wael-suleiman-UdeS/RobotFoot/Livrables/Présentation Publique/Images/ConceptArt.png

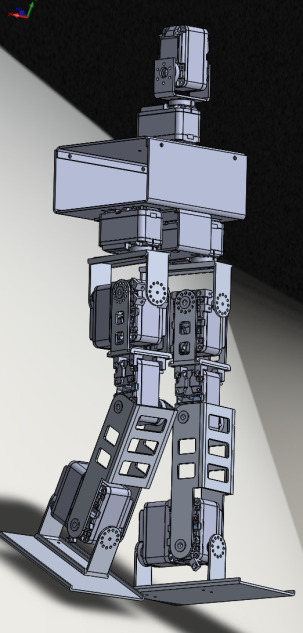
Livrables/Présentation Publique/Images/ConceptArt.png
