wael-suleiman-UdeS/RobotFoot/README.md

RobotFoot
=========

A humanoid robot soccer team.
