wael-suleiman-UdeS/RobotFoot/PCB/PINMAP.TXT

PE14 -> LED1
PE15 -> LED2
PC1  -> SW1
PC2  -> SW2
PC3  -> SW3
PA0  -> Vsense (ADC123_IN0)
PA2  -> DBG_TX (USART_2)
PA3  -> DBG_RX (USART_2)
PB10 -> MOT_TX (USART_3)
PB11 -> MOT_RX (USART_3)
PA4  -> MCU_AUDIO
PC10 -> SCLK [GY/ACC]
PC11 -> MISO [GY/ACC]
PC12 -> MOSI [GY/ACC]
PD0  -> INT1_A
PD1  -> INT2_A
PD2  -> INT1_G
PD3  -> INT2_G
PD4  -> DEN_G
PD6  -> CS_G
PD7  -> CS_A
