wael-suleiman-UdeS/RobotFoot/Darwin/Framework/LisezMoi.txt

Votre rôle sera de modifier le fichier suivant et ses dépendances:

./src/motion/modules/Walking.cpp
