wael-suleiman-UdeS/RobotFoot/Livrables/Canevas/Rapports.docx

Titre du rapport

Équipe RobotFoot

Présenté à:

Noms des superviseurs

Département de génie électrique et de génie information

Date de remise du rapport

# Section 1

## Sous-section 1.1

Lorem ipsum

## Sous-section 1.2

Lorem ipsum

# Section 2

## Sous-section 2.1

Lorem ipsum

## Sous-section 2.2

Lorem ipsum
