wael-suleiman-UdeS/RobotFoot/Marketing/Most.docx

# Most Player

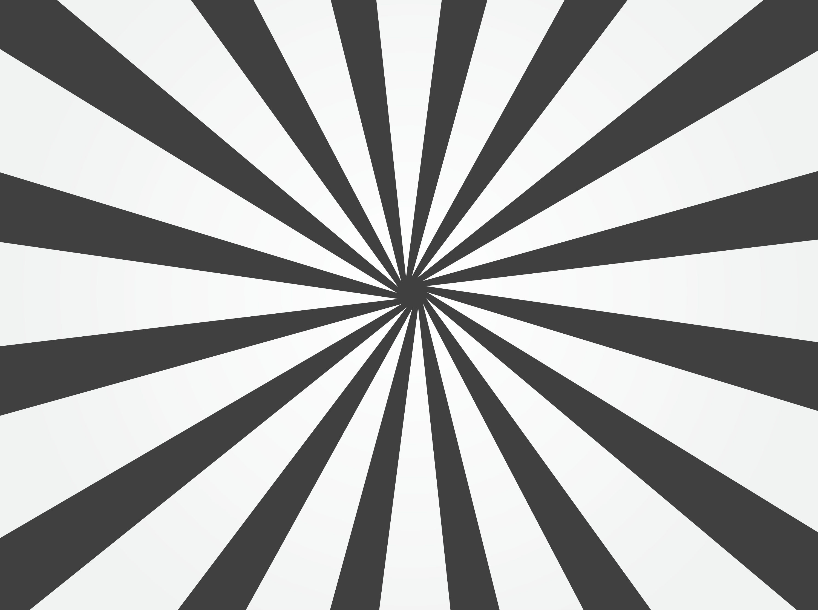
[picture p21: figure]
Background Graphic
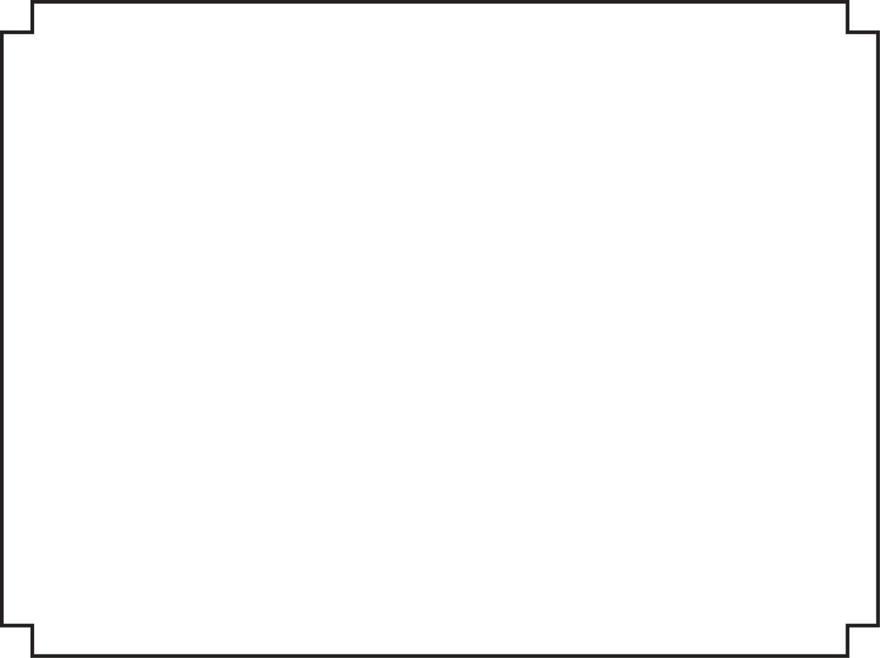
[picture p22: figure]
Background Graphic

RobotFoot

is hereby recognized as this season’s Most Improved Player for phenomenal participation on

learn how to walk

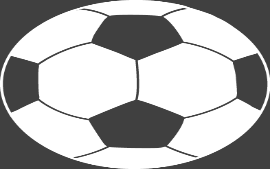
[picture p23: figure]
Soccer ball

| | Presented By: L’équipe RobotFoot On This Day: December 5, 2013
