wael-suleiman-UdeS/RobotFoot/Livrables/Présentation Publique/Affiche.docx

Présentation Publique

      Affiche / Présentation publique

Légende

En gris : À mettre sur l'affiche

Titre de l'affiche

- Comment construire un robot de A à Z : RobotFoot
- How it's made : RobotFoot
- RobotFoot
        Estimer les coûts du projet et faire la planification financière (20 pts)
- Tableau des dépenses
- Prix total du projet pour nous
- Prix total du projet pour un particulier
        Mettre en place des mesures de suivi et de contrôle (20 pts)
- Pointe de tarte des heures des membres de l'équipe
- Moyenne par sprint mis-à-jour (sans les sprints de 0 hrs)
- Échéancier S7-S8
- Suivi des risques
        Faire la conception détaillée (15 pts)
- Résumé de comment créer un robot humanoïde
        Valider et implémenter la solution (15 pts)
- Image de la reconnaissance d'image (les crayons feutre)
- La démonstration du robot qui marche et botte la balle
        Répondre de façon satisfaisante aux questions (14 pts)
- Création de Spécialistes
        Recourir à un support visuel de qualité (13 pts)
- Image du robot
- Nos commanditaire
        Capter l'attention de l'auditoire (13 pts)
- Bien habillé
- Habit de groupe (chandail d'arbitre par exemple)
- LEDs sur la plate-forme et/ou les buts
        Énoncer les objectifs à atteindre (10 pts)
- Tableau des contraintes
- But du projet
