wael-suleiman-UdeS/RobotFoot/Livrables/MAP/Shémas/RobotFoot - Proforma.docx

## 1.1 Rapports - proforma

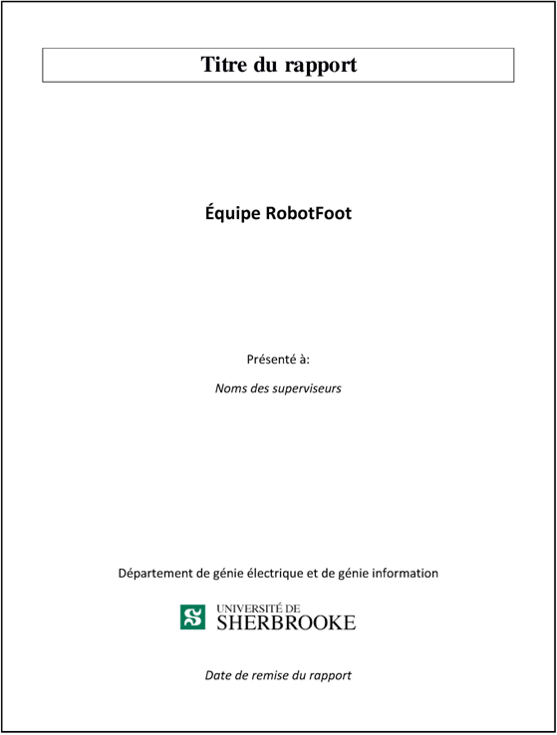
[picture p32: figure]
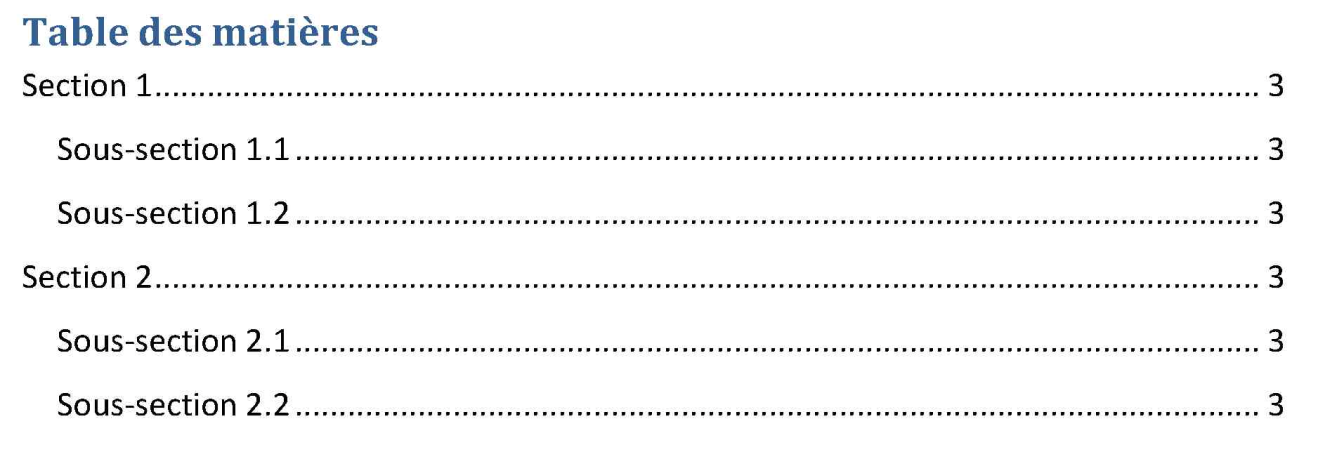
[picture p33: figure]
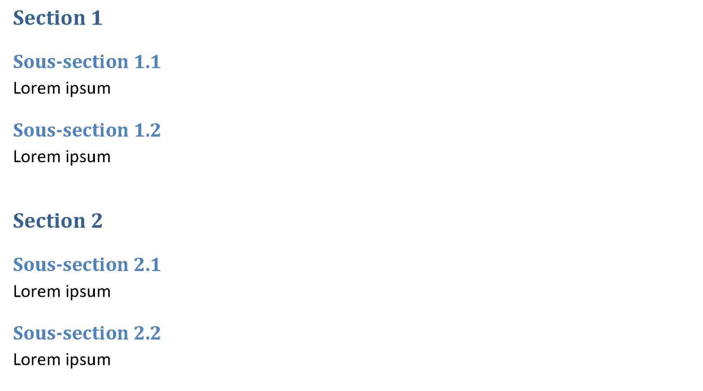
[picture p34: figure]

## 1.2 Compte-rendu de rencontres - proforma

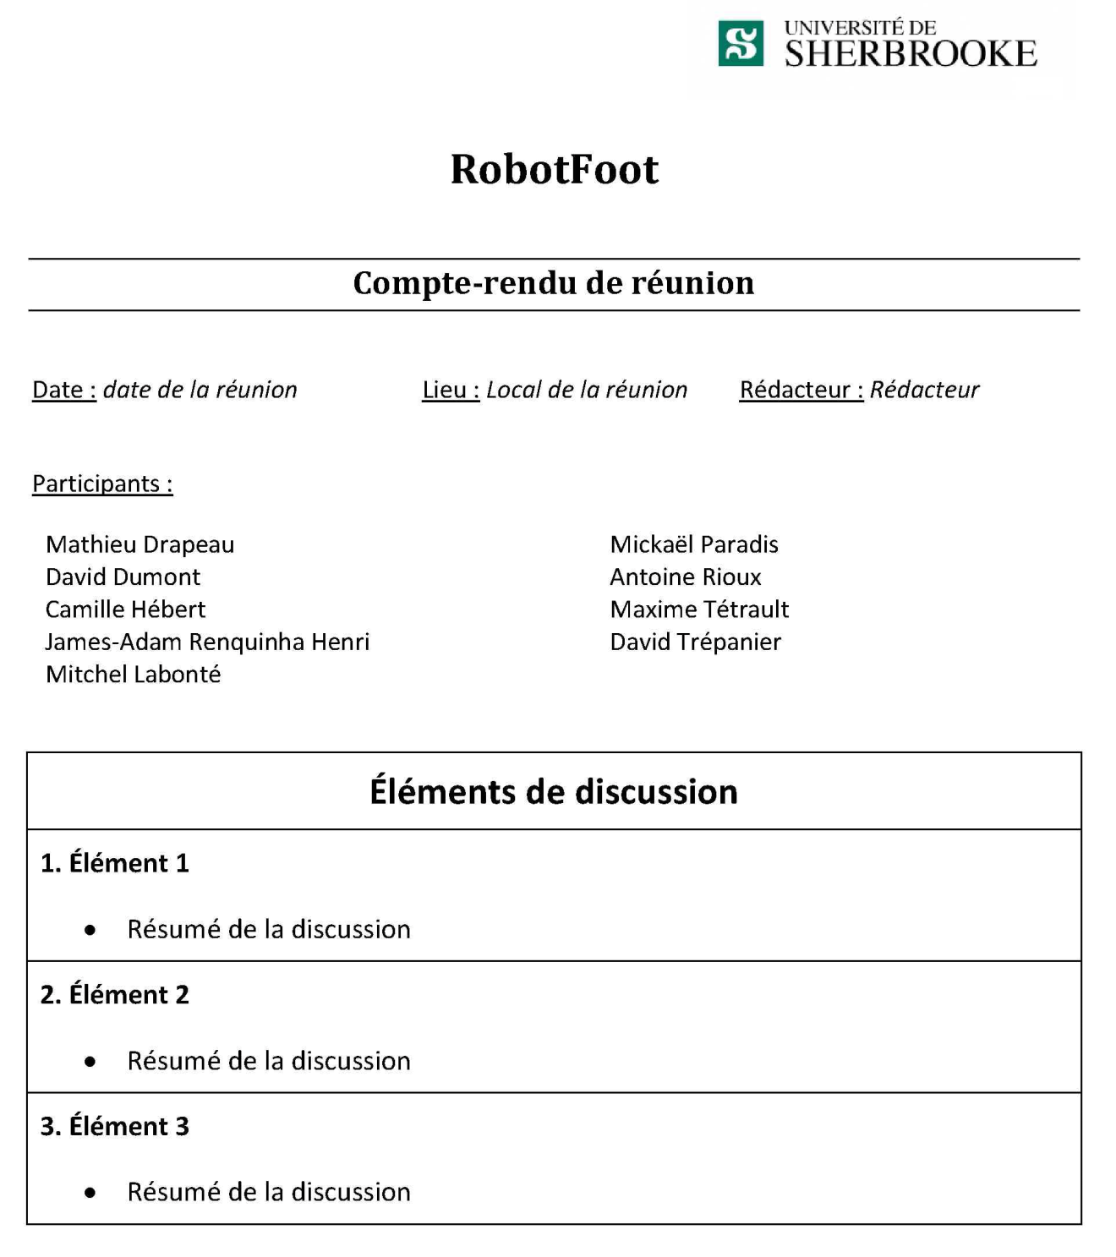
[picture p35: figure]

## 1.3 Suivi budgétaire
