wael-suleiman-UdeS/RobotFoot/Budget/Factures/CA-256597_RoboShop.pdf

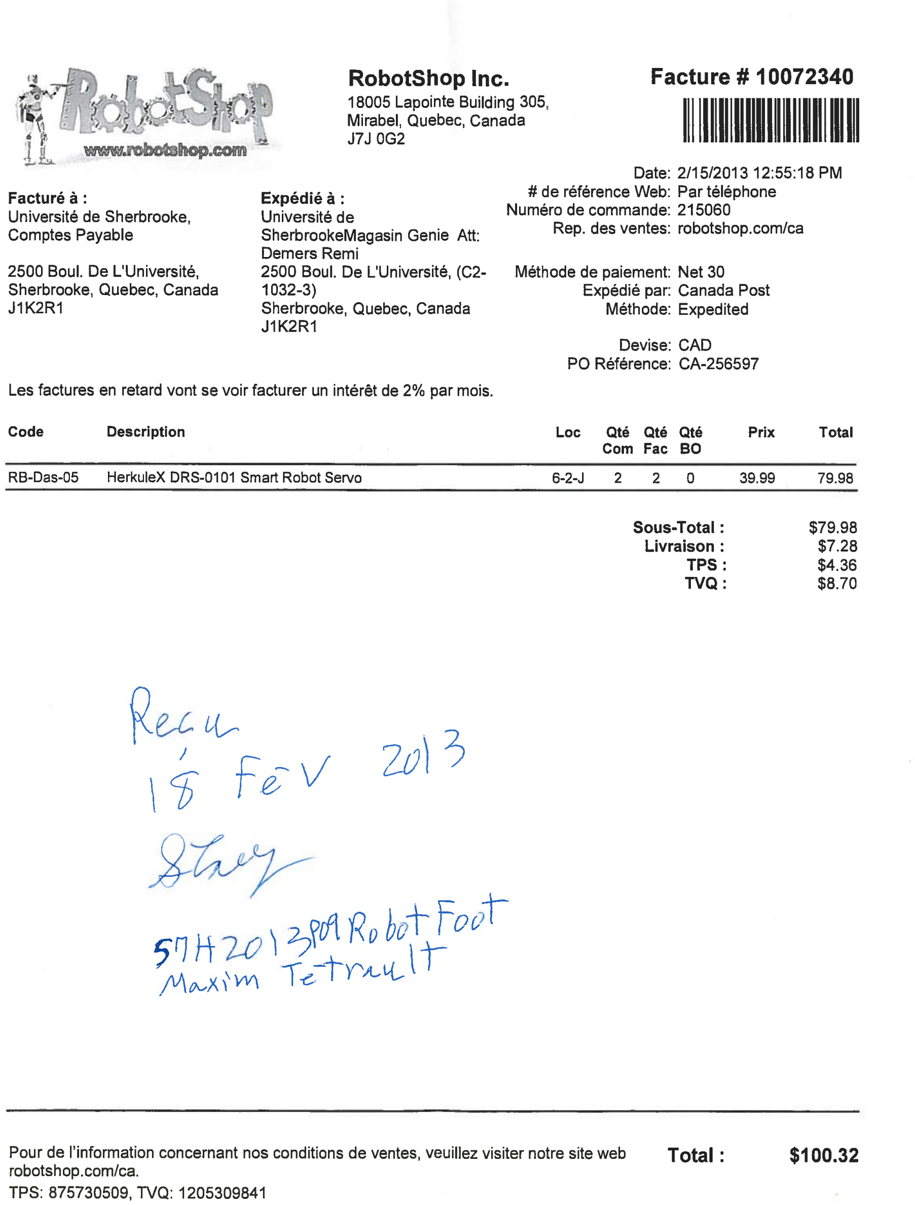
[picture p36: page 1]
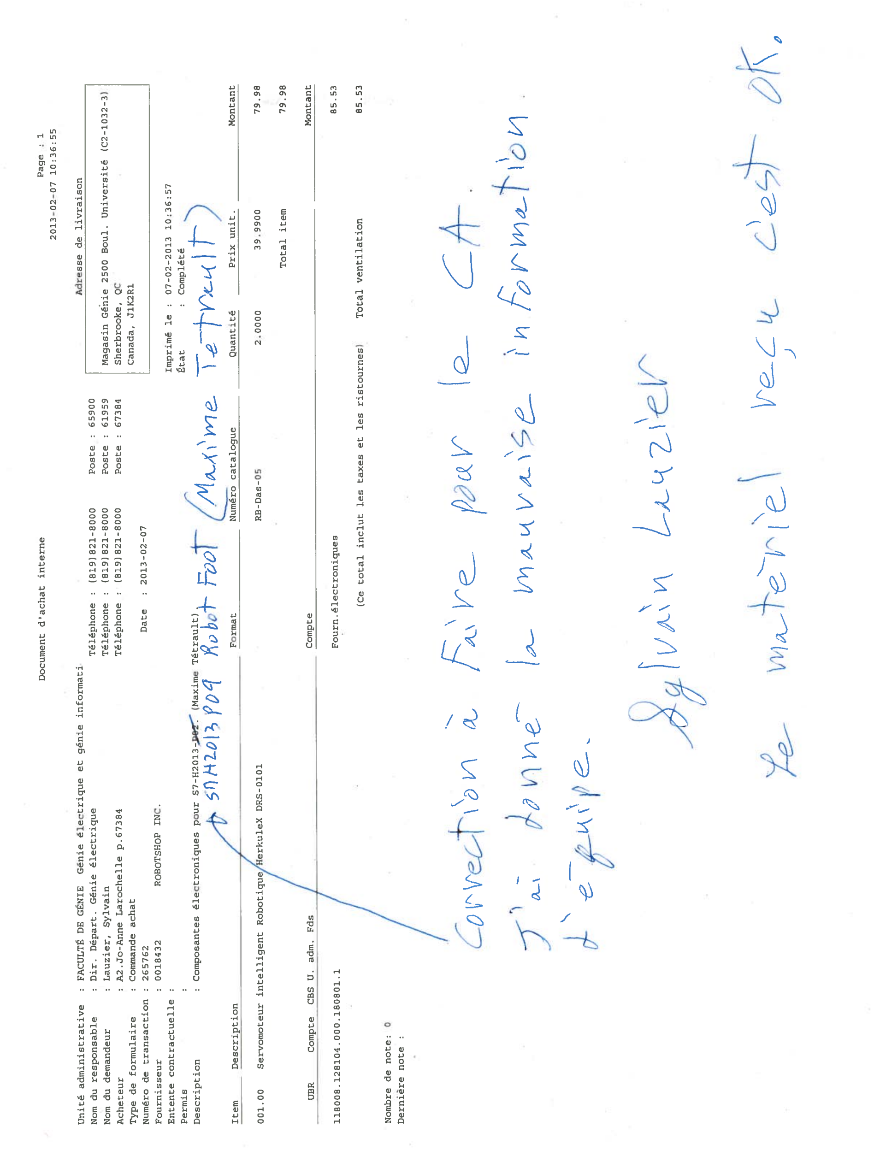
[picture p37: page 2]
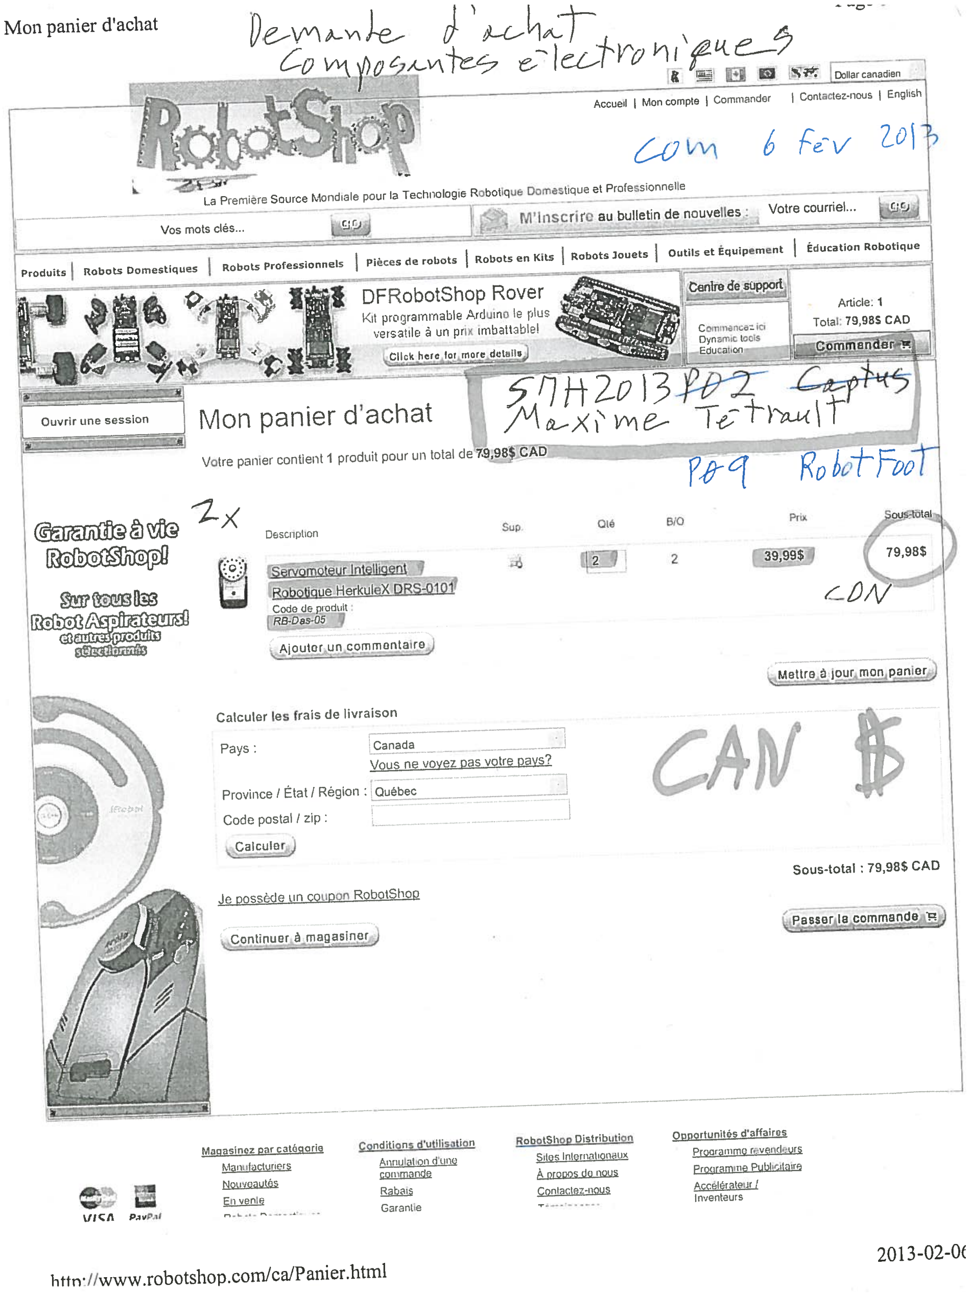
[picture p38: page 3]
