wael-suleiman-UdeS/RobotFoot/Budget/Factures/CA-257648_RoboShop.pdf

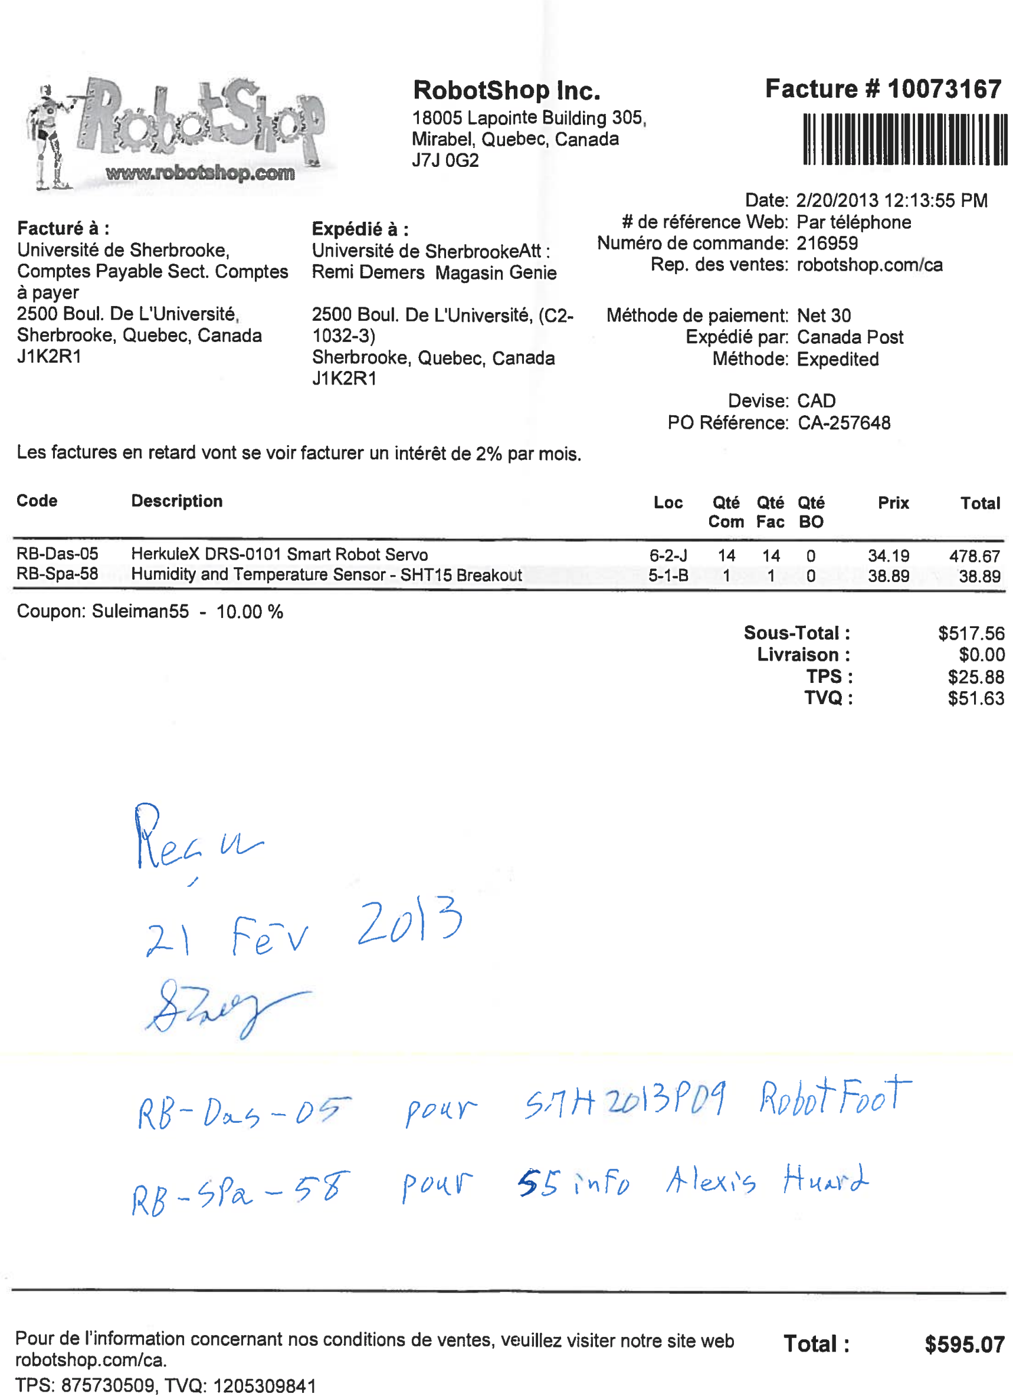
[picture p39: page 1]
