wael-suleiman-UdeS/RobotFoot/Budget/Factures/Rapport de d+®penses - GEGI - +ëtudiant  - V3_R1.xlsx

Sheet: Rapport de dépenses
 |  |  |  |  |  |  | RAPPORT DE DÉPENSES
Département de génie électrique et de génie informatique
ACTIVITÉ : |  |  |  |  |  |  |  |  | Dates de l'activité
 |  |  |  |  |  |  |  | Du :
Nom étudiant | David Dumont |  | Responsable du budget : |  |  |  |  | Au :
Matricule | 9097112 |  | UBR :
Téléphone | 819-239-9498 |  | Équipe projet : | P9 - Robot Foot
ACHAT | Facture d'achat |  |  |  |  |  |  | x | x | Devise | TOTAL
Date |  | Description de la dépense |  |  |  | Montant |  | Facture originale | Preuves paiement (relevés)
2013-03-28 |  | Achat carte-mémoire et un lecteur |  |  |  | 23.63 $ |  |  |  |  | 23.63 $
2013-03-28 |  | Webcam |  |  |  | 26.30 $ |  |  |  |  | 26.30 $
2013-04-22 |  | Essence - On est aller chercher des pièces pour notre robot à la place de se les êtres fait livrer (50$ de livraison) pour pouvoir les avoirs à temps pour l'audit. Il y avais Mitchel Labonté, Antoine Rioux et Mickaël Paradis présent dans l'automobile de Mitchel Labonté. Les pièces ont été fabriqué chez CBR Laser à Princeville/Plessiville. Le gas est celui utilisé pour l'aller-retour de la rue Léonard à Princeville. |  |  |  | 36.00 $ |  |  |  |  | 36.00 $
 |  |  |  |  |  |  |  |  |  |  | 0.00 $
 |  |  |  |  |  |  |  |  |  |  | 0.00 $
 |  |  |  |  |  |  |  |  |  |  | 0.00 $
 |  |  |  |  |  |  |  |  |  |  | 0.00 $
 |  |  |  |  |  |  |  |  |  |  | 0.00 $
 |  |  |  |  |  |  |  |  |  |  | 0.00 $
 |  |  |  |  |  |  |  |  |  |  | 0.00 $
 |  |  |  |  |  |  |  |  |  |  | 0.00 $
 |  |  |  |  |  |  |  |  |  |  | 0.00 $
 |  |  |  |  |  |  |  |  |  |  | 0.00 $
 |  |  |  |  |  |  |  |  |  |  | 0.00 $
 |  |  |  |  |  |  |  |  |  |  | 0.00 $
 |  |  |  |  |  |  |  |  |  |  | 0.00 $
 |  |  |  |  |  | 85.93 $ |  |  |  |  | 85.93 $
NOTES : |  |  |  |  |  |  |  |  |  | Sous-total : | 85.93 $
 |  |  |  |  |  |  |  |  |  | Avances :
 |  |  |  |  |  |  |  |  |  | TOTAL : | 85.93 $
 |  |  |  |  |  |  |  |  |  |  | LES PIÈCES JUSTIFICATIVES ORIGINALES SONT
 | Signature du responsable (approbation) |  | Nom en lettres moulées |  | Date |  |  |  |  |  | OBLIGATOIRES AINSI QUE LA PREUVE DE PAIEMENT.

Sheet: Directives
Directive relative au remboursement des frais de déplacement (extrait de la directive 2600-013)
8.1 | La demande de paiement des frais de déplacement doit comprendre les renseignements suivants :
 | - la durée et l'endroit
 | - le motif du déplacement (si pour enseignement, indiquer le sigle, la session et l'APP)
 | - le nom et la fonction de la personne rencontrée, ainsi que la relation d’affaires (s’il y a lieu)
 | - le détail des dépenses encourues et le montant du remboursement réclamé
 | - les pièces justificatives originales (les photocopies de pièces ne sont pas acceptées)
 | - les pièces justificatives doivent indiquer clairement que le montant est payé.
8.2 | La demande de paiement de dépenses inhabituelles doit être appuyée de justifications détaillées.
 | Précisions
 | Il est important d'inscrire tous les détails pertinents à votre demande, ceci afin d'en accélérer le traitement.
 | Il n'est pas nécessaire d'indiquer le kilométrage, car les déplacements sont remboursés selon la directive de l'Université de Sherbrooke, disponible à l'adresse suivante : https://helios.usherb.ca/lib880/dosetu/cw/wde0/CGW100PA
 | Lorsqu'une facture d'hôtel comprend un forfait, si possible, indiquer le contenu du forfait si celui-ci n'est pas détaillé sur la facture (salle de cours, coucher, repas, pauses-café, par exemple).
Envoi du rapport de dépenses
 | Lorsque complété, vous devez retourner votre rapport de dépenses à l'adresse suivante, accompagné des pièces justificatives appropriées :
 | Université de Sherbrooke
 | Faculté de génie
 | Département de génie électrique et informatique
 | 2500, boul. de l'Université
 | Sherbrooke (Québec) J1K 2R1
 |  | Rapport cliquer ici
