wael-suleiman-UdeS/RobotFoot/Budget/Factures/Remboursement 1 Max- batterie (paypal).png

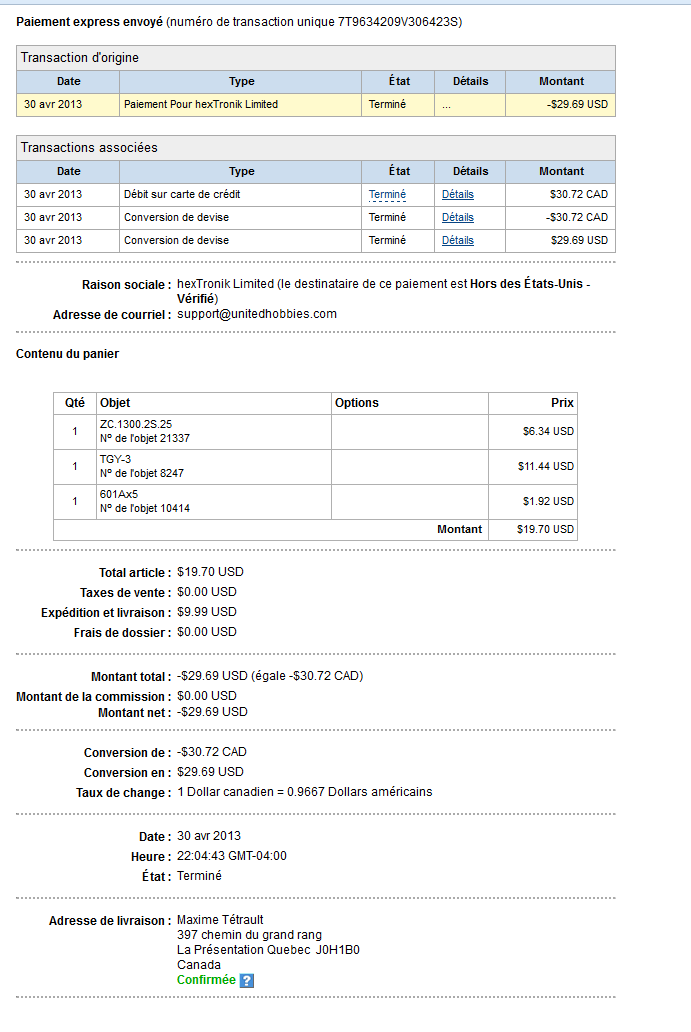
Budget/Factures/Remboursement 1 Max- batterie (paypal).png
