wael-suleiman-UdeS/RobotFoot/Budget/Factures/Remboursement 1 Max- batterie.png

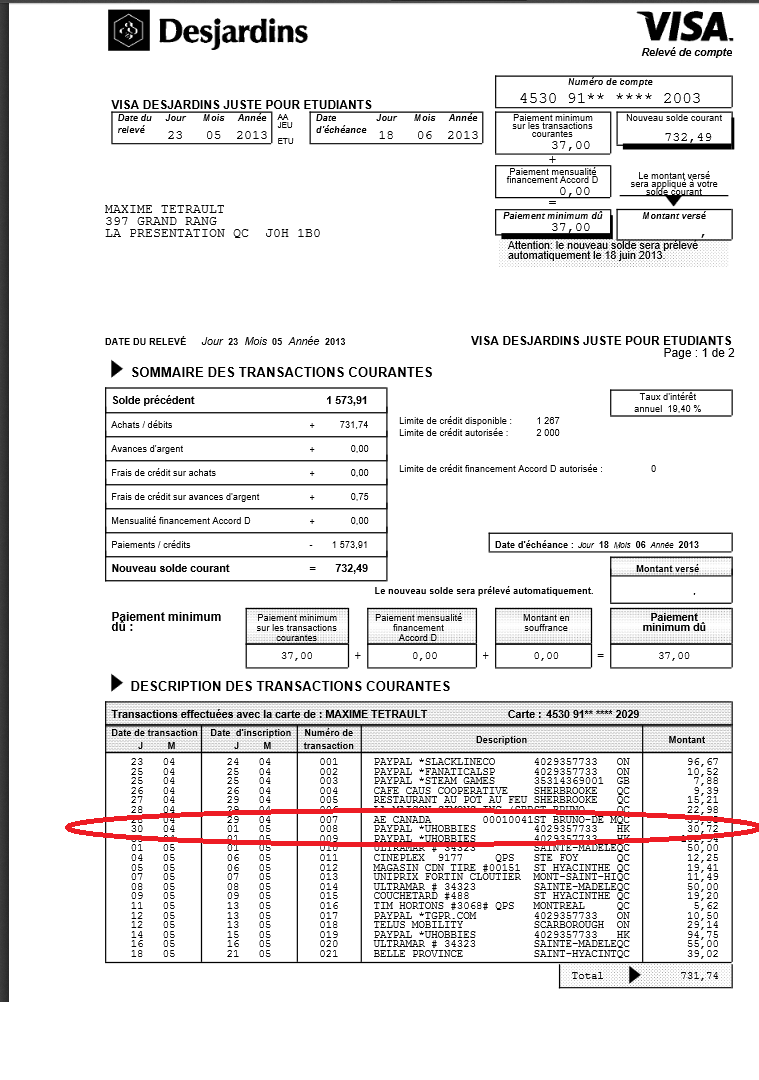
Budget/Factures/Remboursement 1 Max- batterie.png
