wael-suleiman-UdeS/RobotFoot/Budget/Factures/remboursement Batterie 2.png

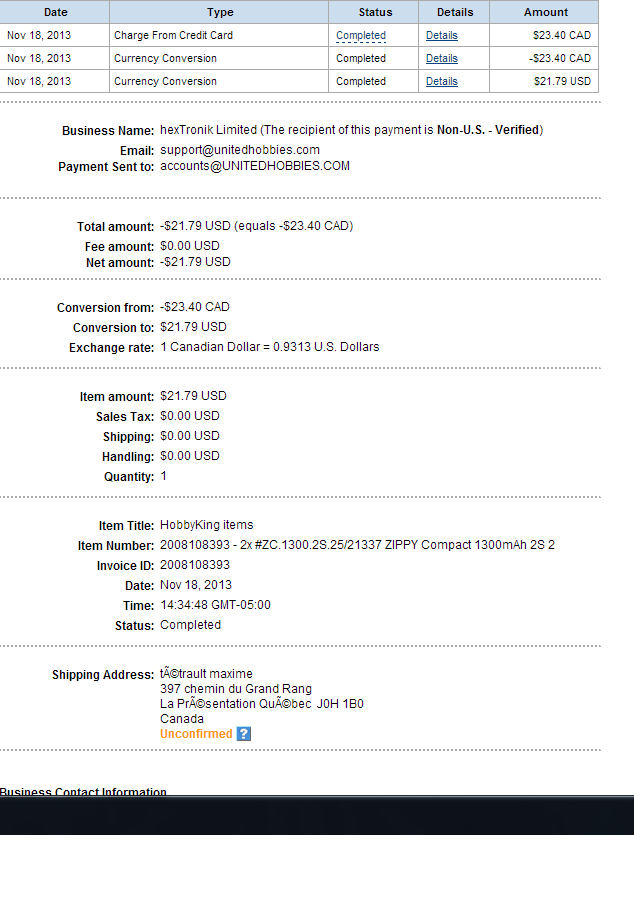
Budget/Factures/remboursement Batterie 2.png
