wael-suleiman-UdeS/RobotFoot/doc/Documentation et reference/HerculeX/Hovis LIte.png

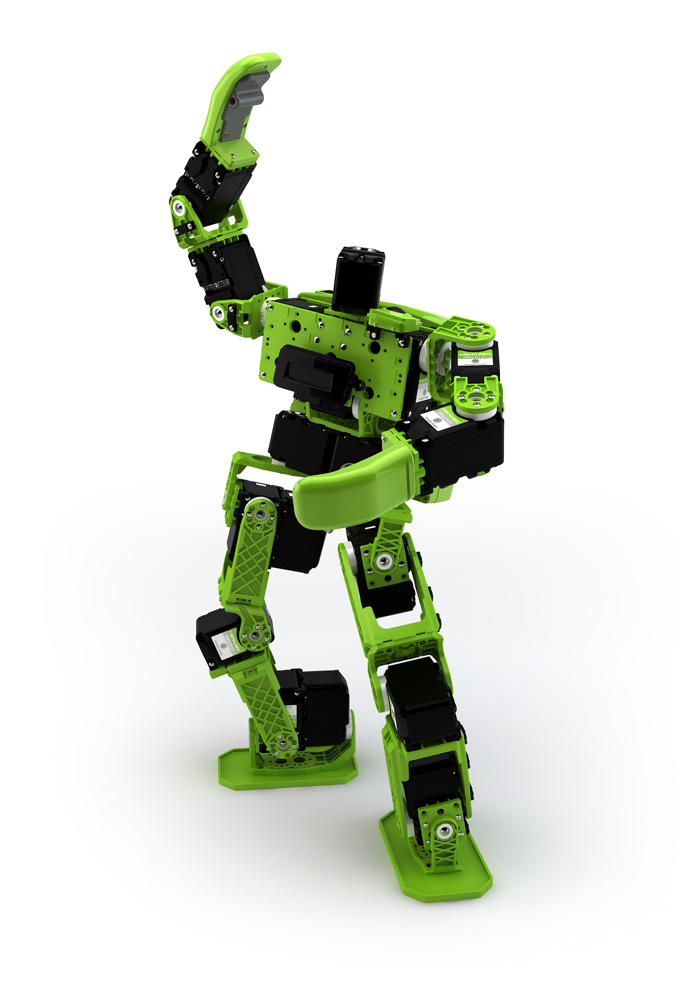
doc/Documentation et reference/HerculeX/Hovis LIte.png
