wael-suleiman-UdeS/RobotFoot/doc/Documentation et reference/HerculeX/Pieces.png

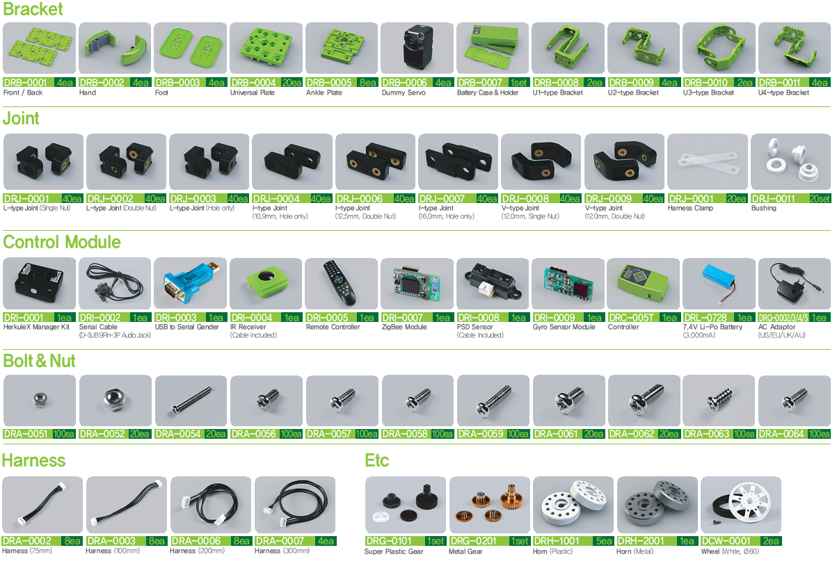
doc/Documentation et reference/HerculeX/Pieces.png
