wael-suleiman-UdeS/RobotFoot/Livrables/Article Scientifique/architecture.PNG

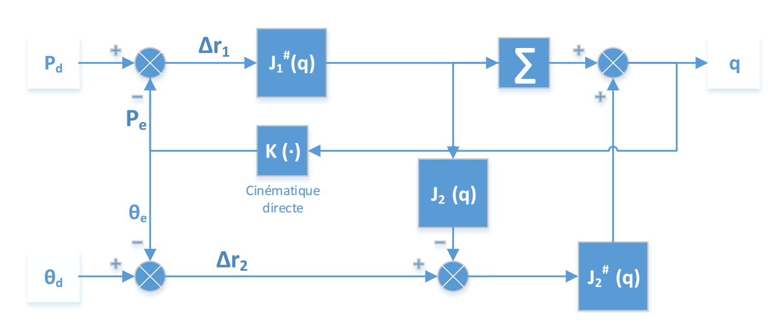
Livrables/Article Scientifique/architecture.PNG
