wael-suleiman-UdeS/RobotFoot/Livrables/Article Scientifique/Figures/2013-11-29 17.06.52.jpg

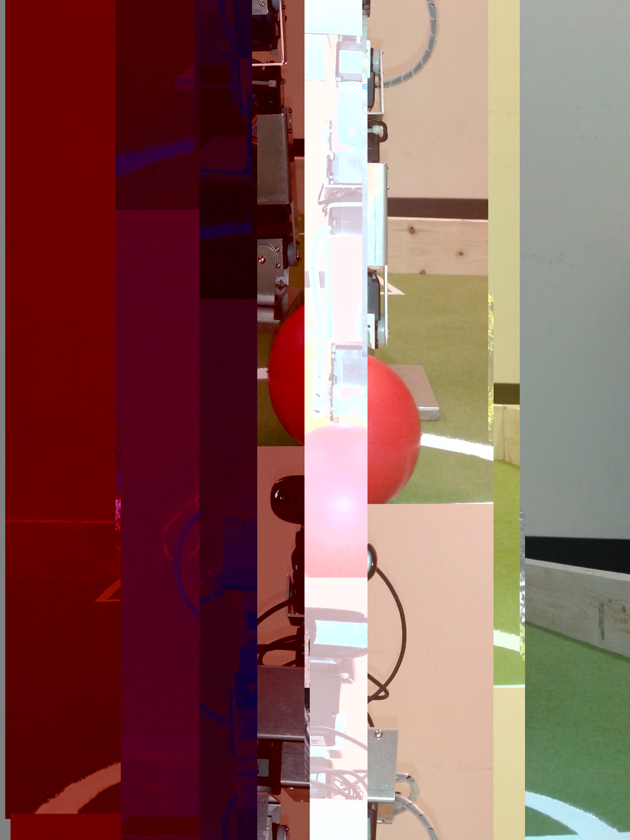
Livrables/Article Scientifique/Figures/2013-11-29 17.06.52.jpg
