wael-suleiman-UdeS/RobotFoot/Livrables/Article Scientifique/Figures/2013-11-29 17.07.05.jpg

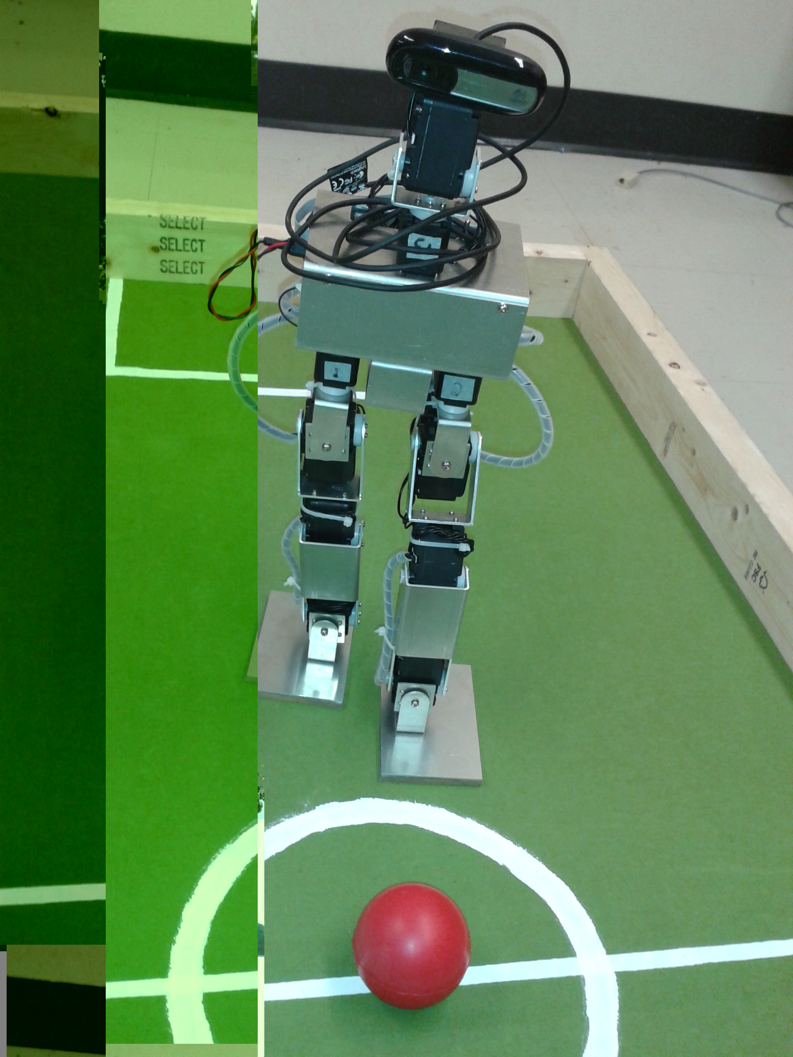
Livrables/Article Scientifique/Figures/2013-11-29 17.07.05.jpg
