wael-suleiman-UdeS/RobotFoot/Livrables/Article Scientifique/Figures/Bezier.jpg

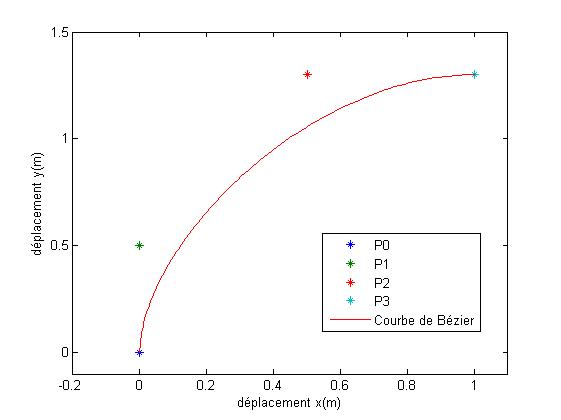
Livrables/Article Scientifique/Figures/Bezier.jpg
