wael-suleiman-UdeS/RobotFoot/Livrables/Article Scientifique/Figures/BezierPas.jpg

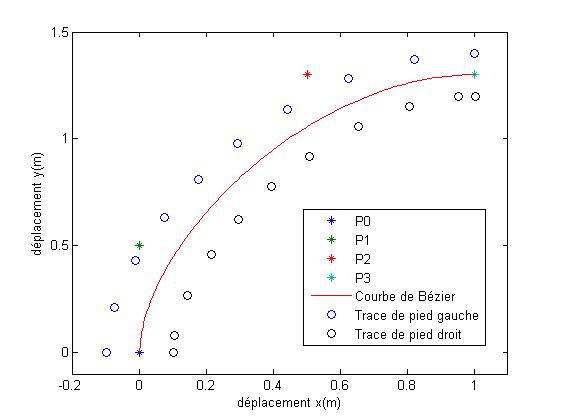
Livrables/Article Scientifique/Figures/BezierPas.jpg
