wael-suleiman-UdeS/RobotFoot/Livrables/Article Scientifique/Figures/DSCF1675 - Copie - Copie.JPG

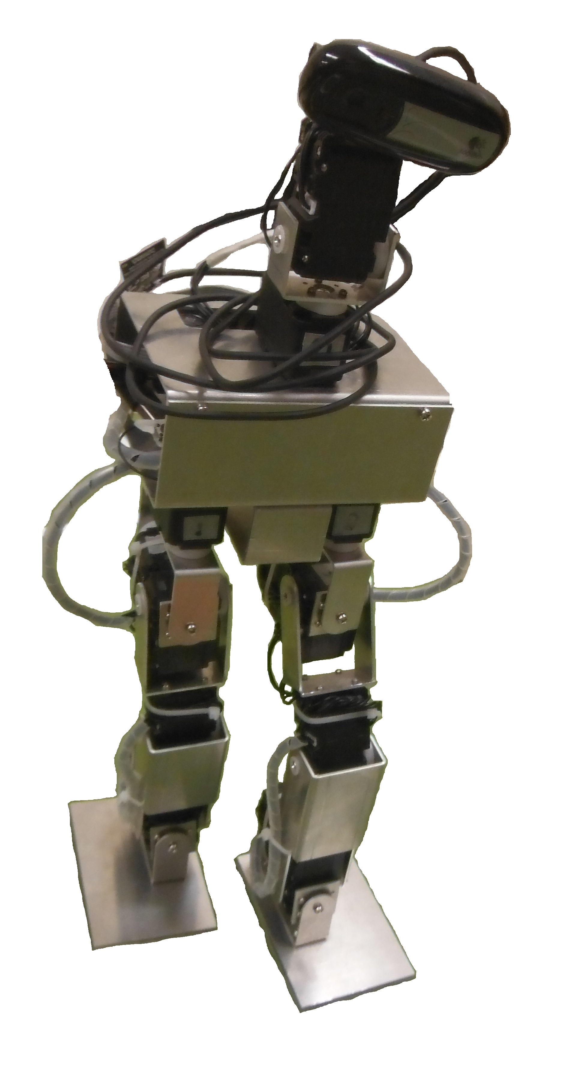
Livrables/Article Scientifique/Figures/DSCF1675 - Copie - Copie.JPG
