wael-suleiman-UdeS/RobotFoot/Livrables/Article Scientifique/Figures/Empreinte.png

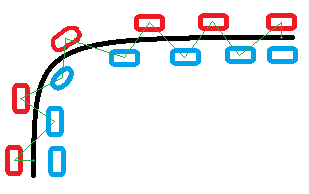
Livrables/Article Scientifique/Figures/Empreinte.png
