wael-suleiman-UdeS/RobotFoot/Livrables/Article Scientifique/pourleDH.PNG

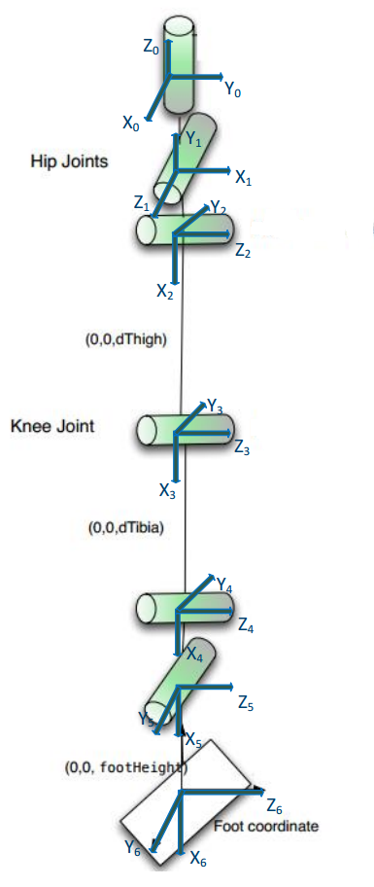
Livrables/Article Scientifique/pourleDH.PNG
