wael-suleiman-UdeS/RobotFoot/Livrables/Audit 1 mars/After Color Filter.jpg

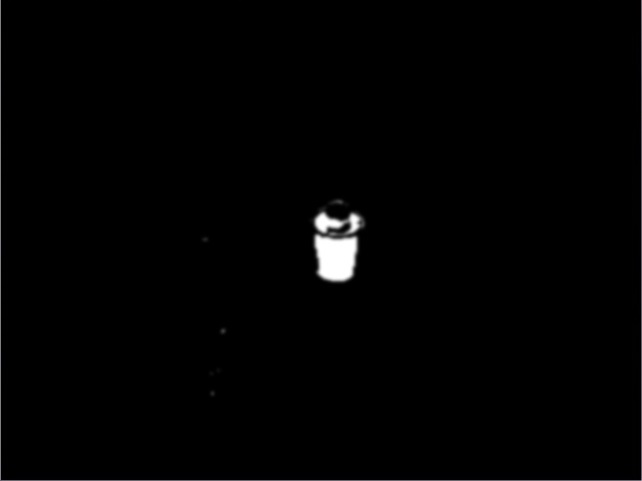
Livrables/Audit 1 mars/After Color Filter.jpg
