wael-suleiman-UdeS/RobotFoot/Livrables/Audit 1 mars/Camera.jpg

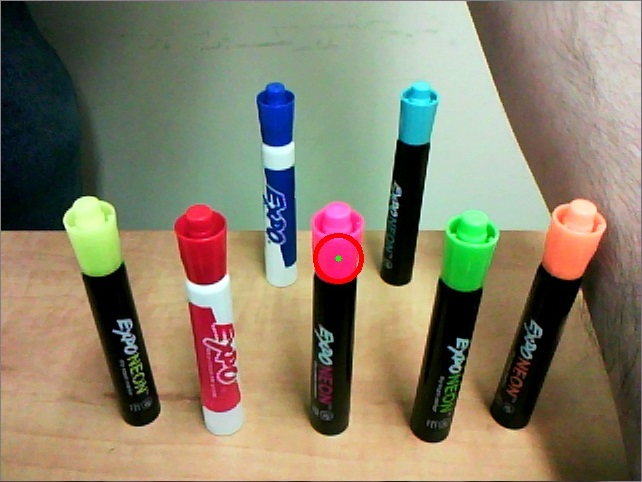
Livrables/Audit 1 mars/Camera.jpg
