wael-suleiman-UdeS/RobotFoot/Livrables/Audit 1 mars/choix de servo.png

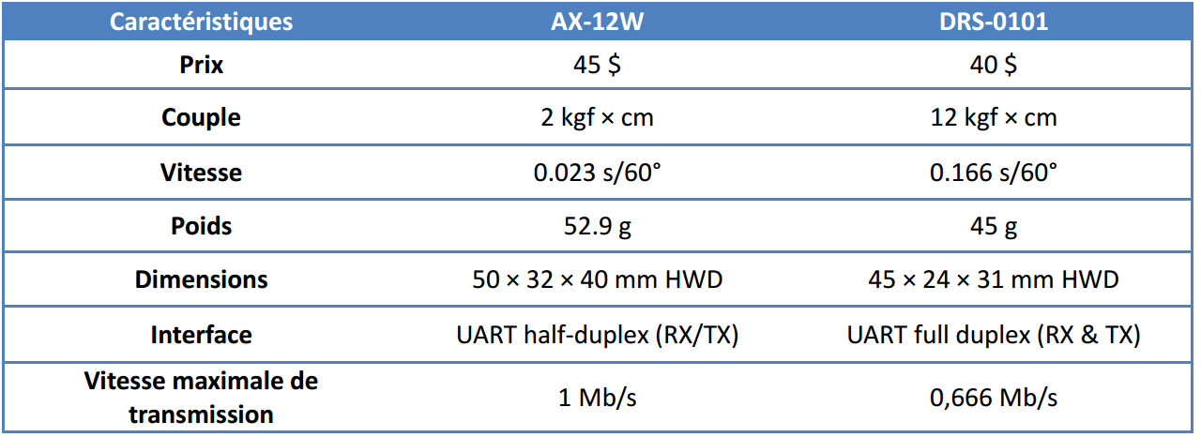
Livrables/Audit 1 mars/choix de servo.png
