wael-suleiman-UdeS/RobotFoot/Livrables/Audit 1 mars/choix Microcontroleur.png

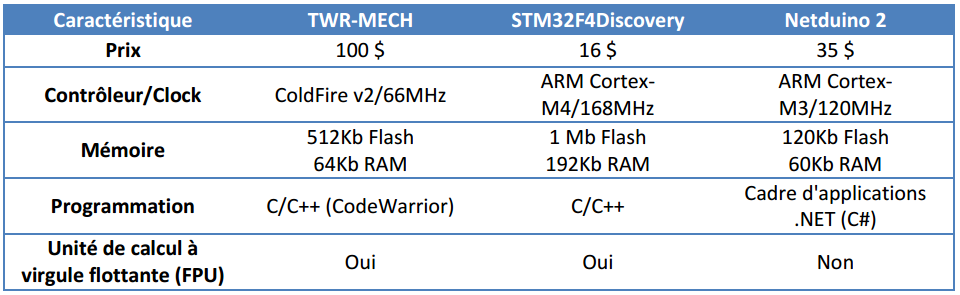
Livrables/Audit 1 mars/choix Microcontroleur.png
