wael-suleiman-UdeS/RobotFoot/Livrables/Audit 1 mars/composant élect.png

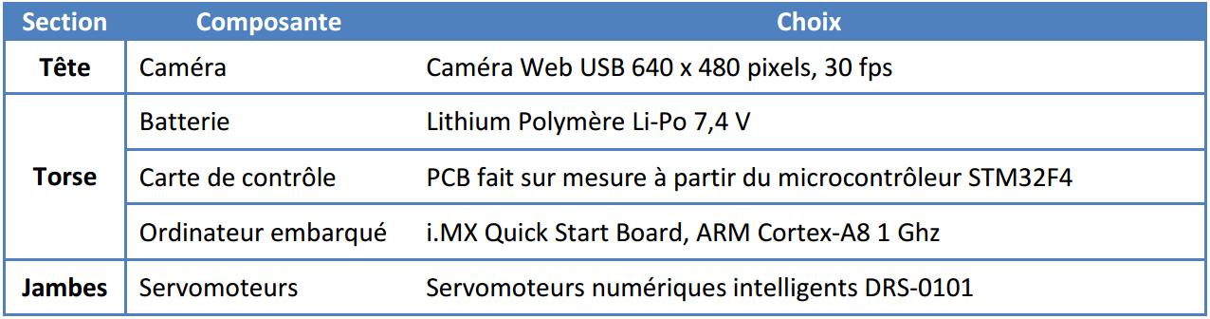
Livrables/Audit 1 mars/composant élect.png
