wael-suleiman-UdeS/RobotFoot/Livrables/Audit 1 mars/conception physique.png

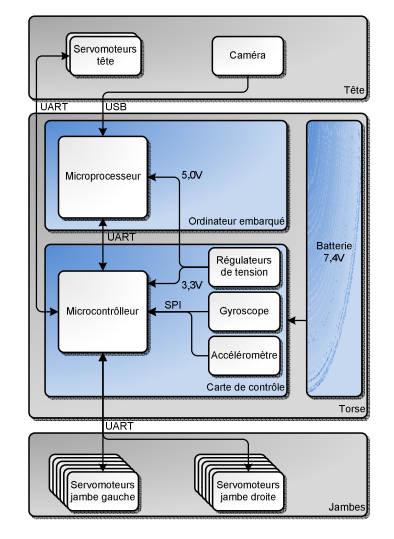
Livrables/Audit 1 mars/conception physique.png
