wael-suleiman-UdeS/RobotFoot/Livrables/Audit 1 mars/graph.png

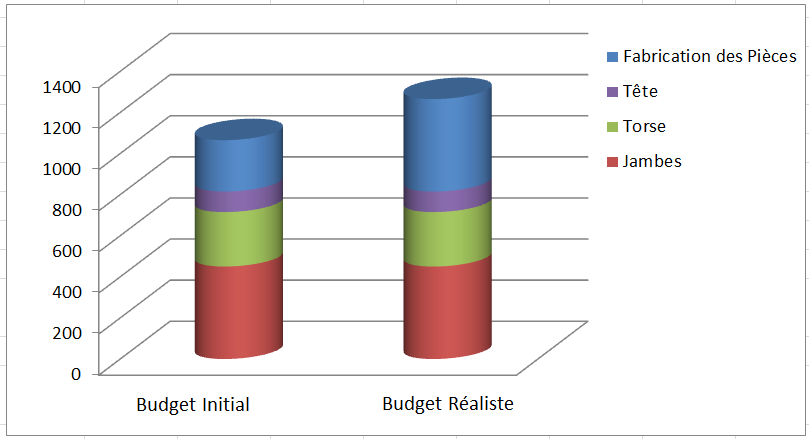
Livrables/Audit 1 mars/graph.png
