wael-suleiman-UdeS/RobotFoot/Livrables/Audit 1 mars/Graphique Budget.png

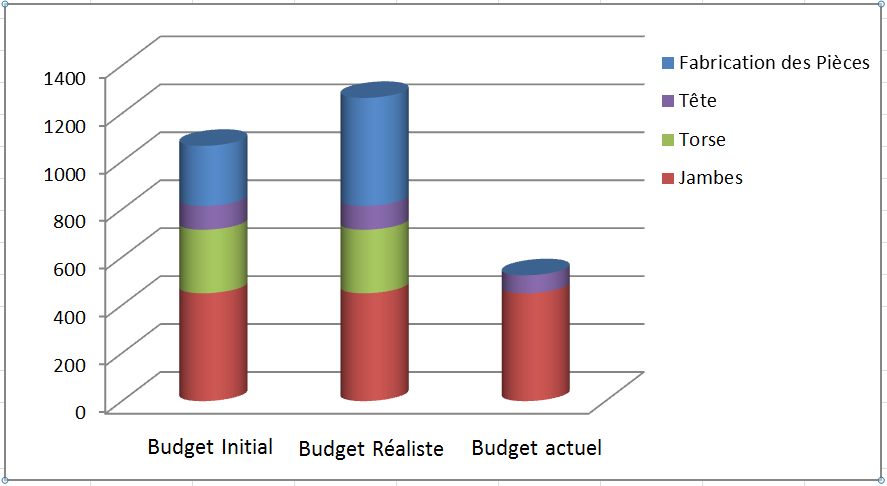
Livrables/Audit 1 mars/Graphique Budget.png
