wael-suleiman-UdeS/RobotFoot/Livrables/Audit 1 mars/herkulex-drs-0101-robot-servo-B.jpg

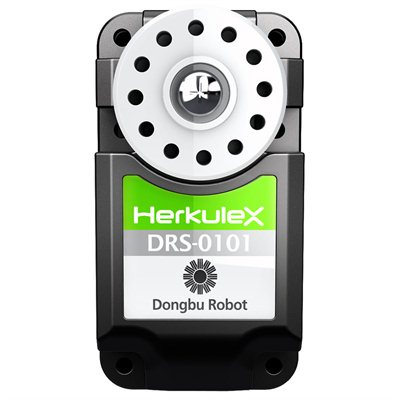
Livrables/Audit 1 mars/herkulex-drs-0101-robot-servo-B.jpg
