wael-suleiman-UdeS/RobotFoot/Livrables/Audit 1 mars/HSV Camera.jpg

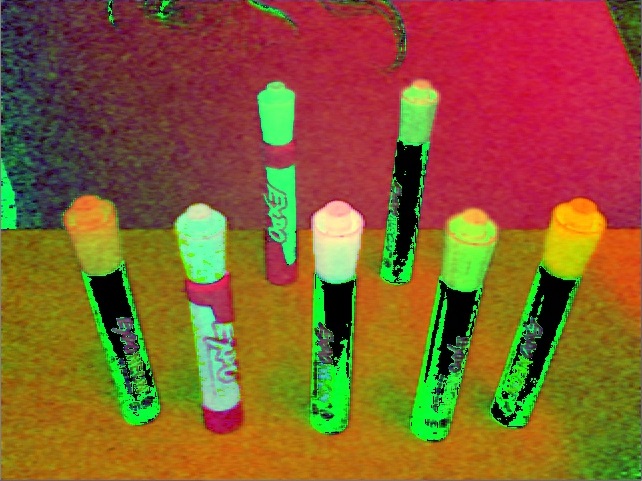
Livrables/Audit 1 mars/HSV Camera.jpg
