wael-suleiman-UdeS/RobotFoot/Livrables/Audit 1 mars/Jambe.png

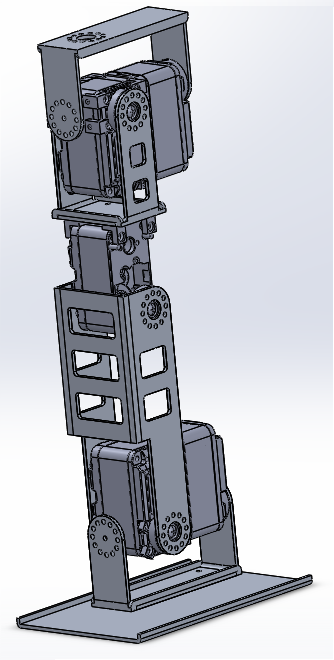
Livrables/Audit 1 mars/Jambe.png
