wael-suleiman-UdeS/RobotFoot/Livrables/Audit 1 mars/machine à état fini.png

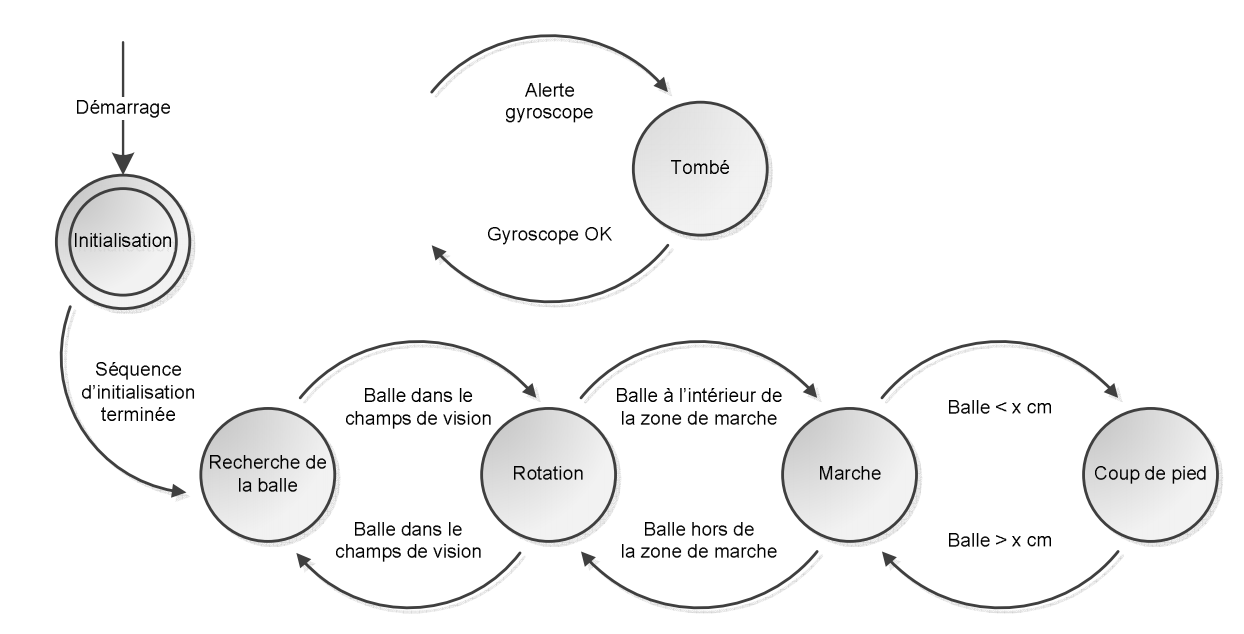
Livrables/Audit 1 mars/machine à état fini.png
