wael-suleiman-UdeS/RobotFoot/Livrables/Audit 1 mars/schéma décision.png

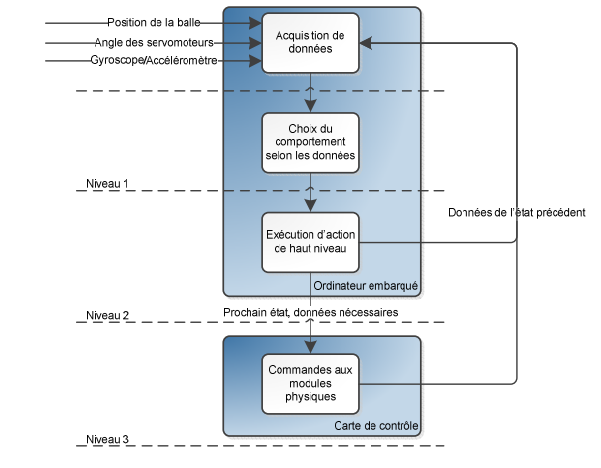
Livrables/Audit 1 mars/schéma décision.png
