wael-suleiman-UdeS/RobotFoot/Livrables/Audit 1 mars/schéma logique haut niveau.png

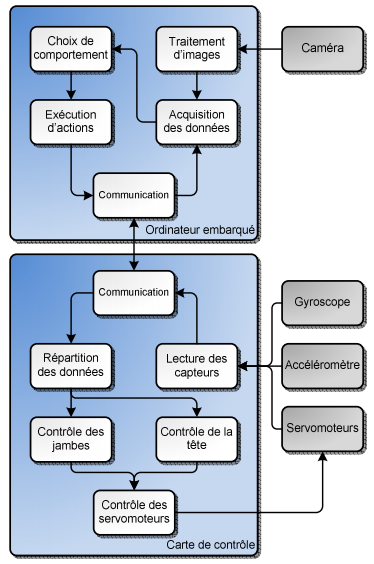
Livrables/Audit 1 mars/schéma logique haut niveau.png
