wael-suleiman-UdeS/RobotFoot/Livrables/Audit 1 mars/torse.png

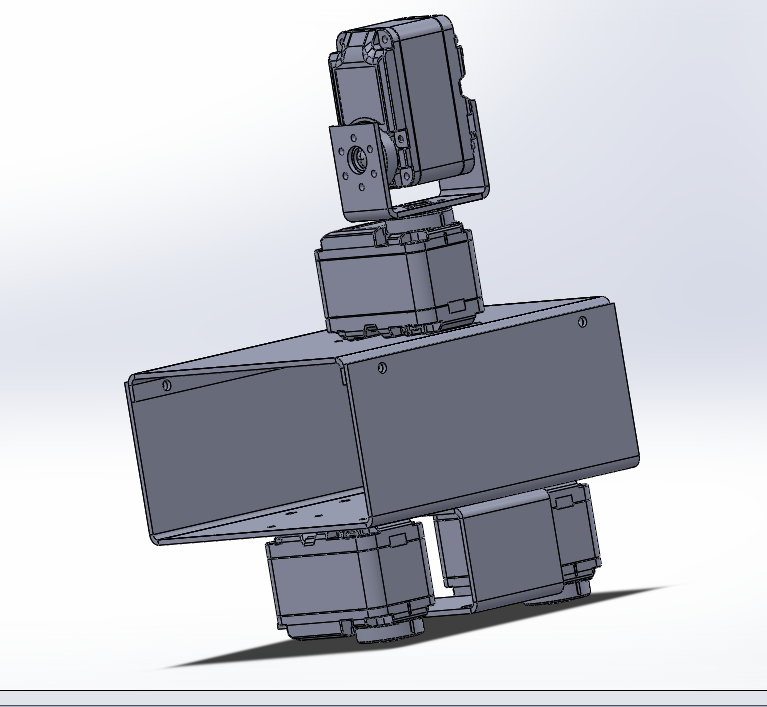
Livrables/Audit 1 mars/torse.png
