wael-suleiman-UdeS/RobotFoot/Livrables/Audit 1 mars/type de servo.png

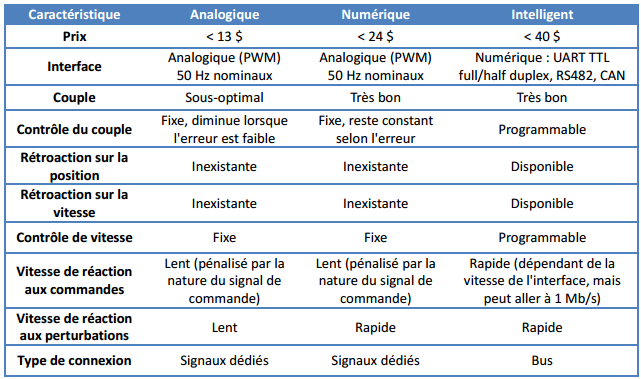
Livrables/Audit 1 mars/type de servo.png
