wael-suleiman-UdeS/RobotFoot/Livrables/Audit 23 avril/bioloid-300.jpg

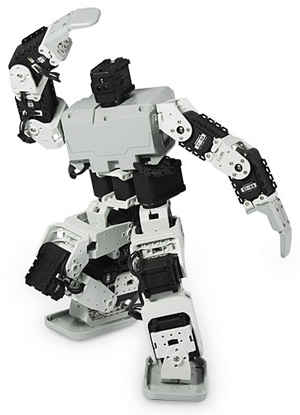
Livrables/Audit 23 avril/bioloid-300.jpg
