wael-suleiman-UdeS/RobotFoot/Livrables/Audit 23 avril/Budget 2 robots.PNG

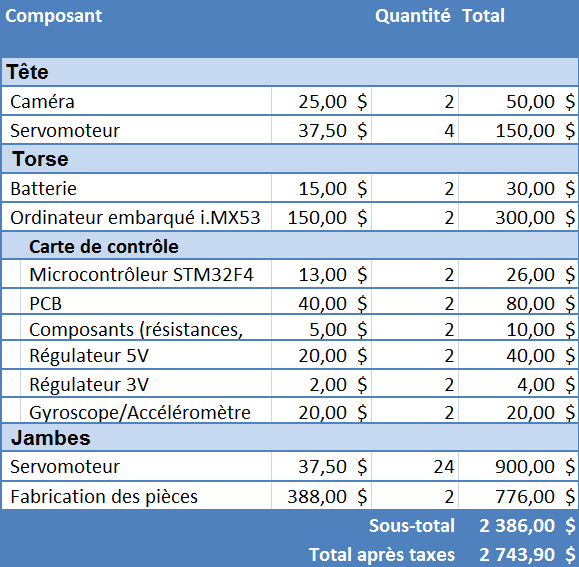
Livrables/Audit 23 avril/Budget 2 robots.PNG
