wael-suleiman-UdeS/RobotFoot/Livrables/Audit 23 avril/Budget disponible.PNG

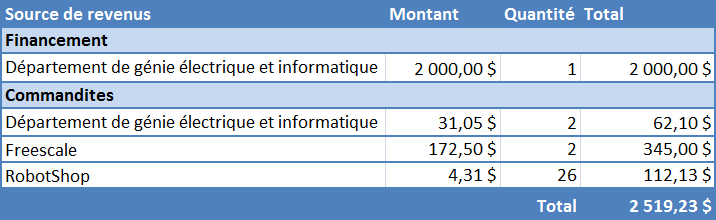
Livrables/Audit 23 avril/Budget disponible.PNG
