wael-suleiman-UdeS/RobotFoot/Livrables/Audit 23 avril/Capture.PNG

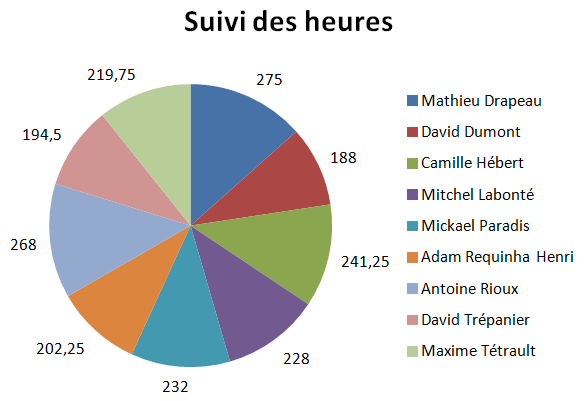
Livrables/Audit 23 avril/Capture.PNG
