wael-suleiman-UdeS/RobotFoot/Livrables/Audit 23 avril/claire-lomas.jpg

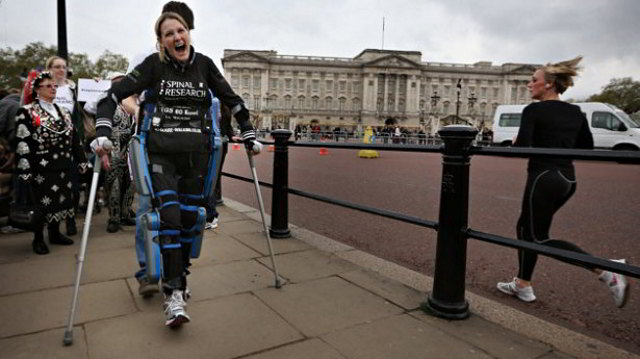
Livrables/Audit 23 avril/claire-lomas.jpg
