wael-suleiman-UdeS/RobotFoot/Livrables/Audit 23 avril/nao.png

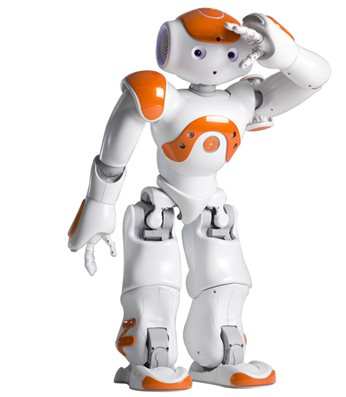
Livrables/Audit 23 avril/nao.png
