wael-suleiman-UdeS/RobotFoot/Livrables/Audit 23 avril/PCB.PNG

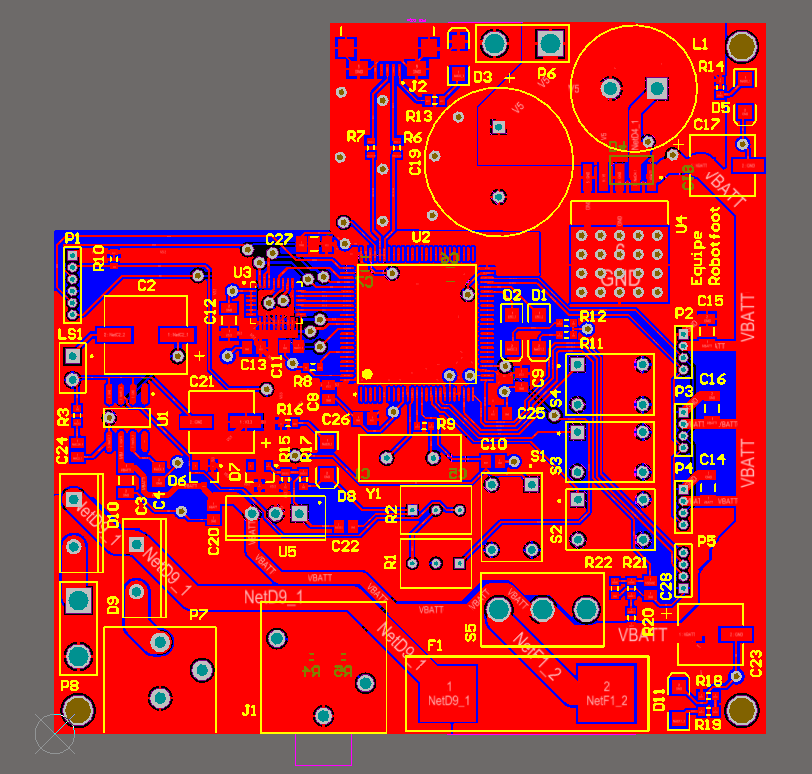
Livrables/Audit 23 avril/PCB.PNG
