wael-suleiman-UdeS/RobotFoot/Livrables/Audit 23 avril/Risques.PNG

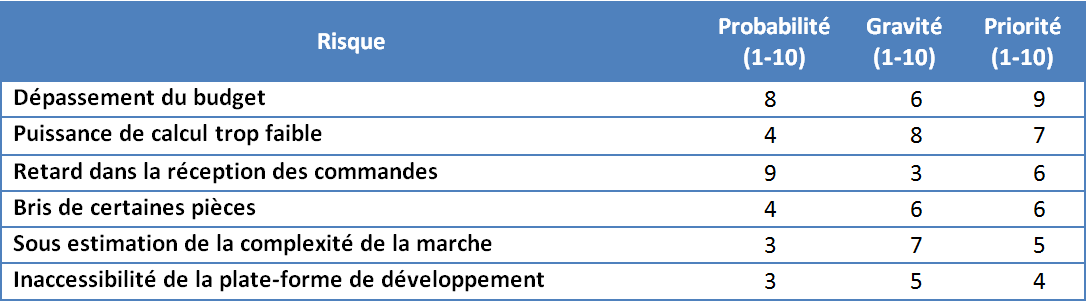
Livrables/Audit 23 avril/Risques.PNG
