wael-suleiman-UdeS/RobotFoot/Livrables/Audit 23 avril/sprint2_burndown_chart.png

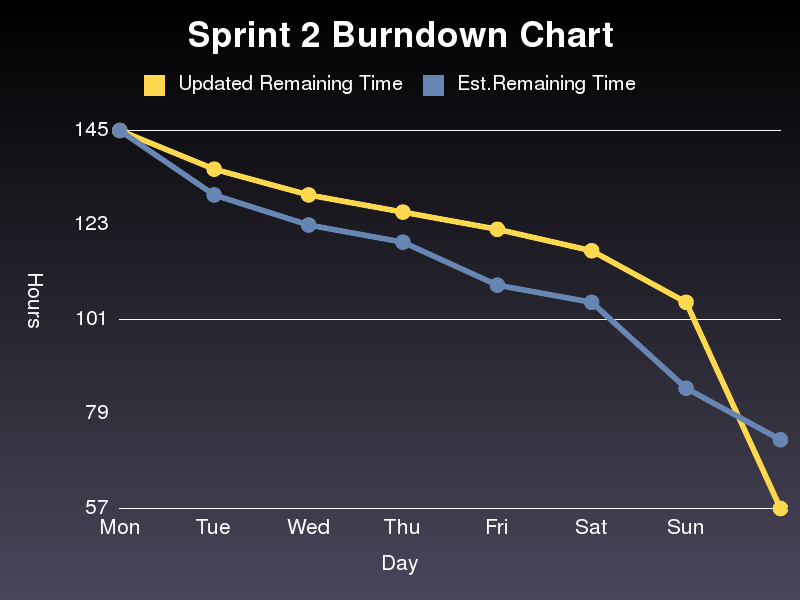
Livrables/Audit 23 avril/sprint2_burndown_chart.png
