wael-suleiman-UdeS/RobotFoot/Livrables/Audit 23 avril/sprint12_burndown_chart.png

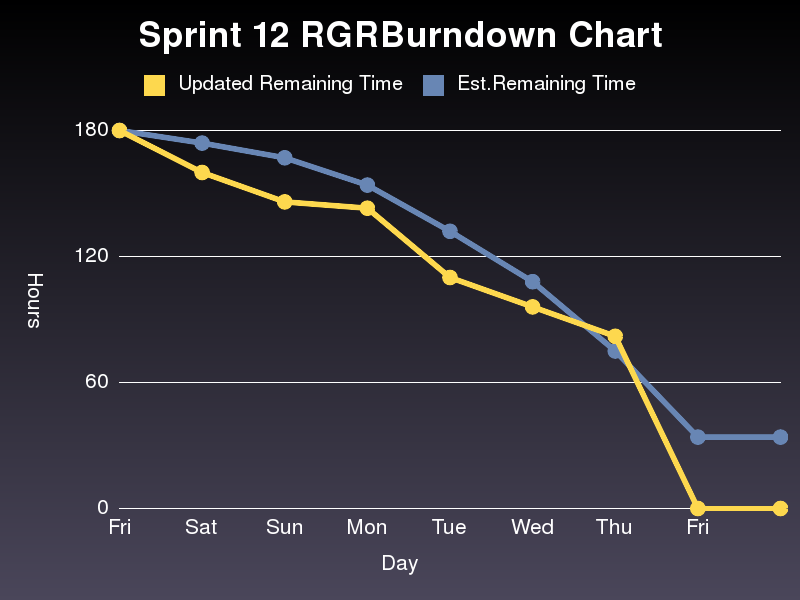
Livrables/Audit 23 avril/sprint12_burndown_chart.png
