wael-suleiman-UdeS/RobotFoot/Livrables/Audit 25 octobre/Capture.PNG

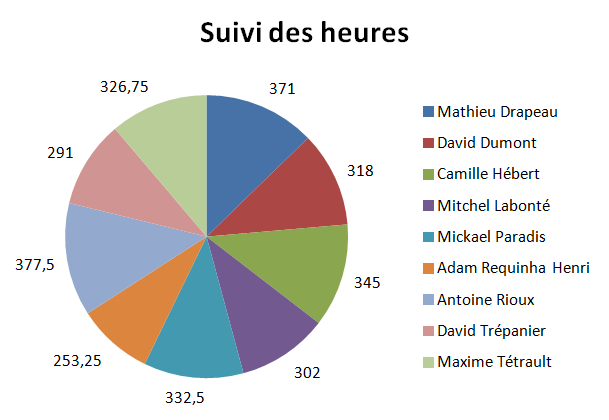
Livrables/Audit 25 octobre/Capture.PNG
