wael-suleiman-UdeS/RobotFoot/Livrables/Audit 25 octobre/Dessin5.jpg

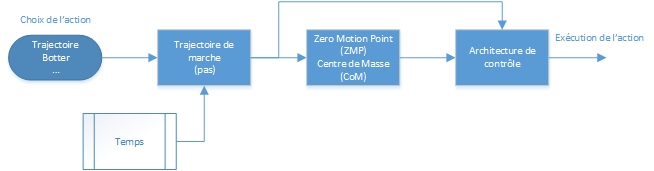
Livrables/Audit 25 octobre/Dessin5.jpg
