wael-suleiman-UdeS/RobotFoot/Livrables/Audit 25 octobre/gestion risque.PNG

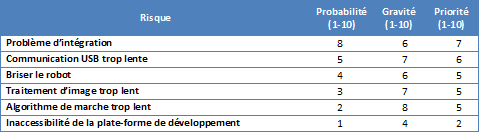
Livrables/Audit 25 octobre/gestion risque.PNG
