wael-suleiman-UdeS/RobotFoot/Livrables/Audit 25 octobre/leftfoot.png

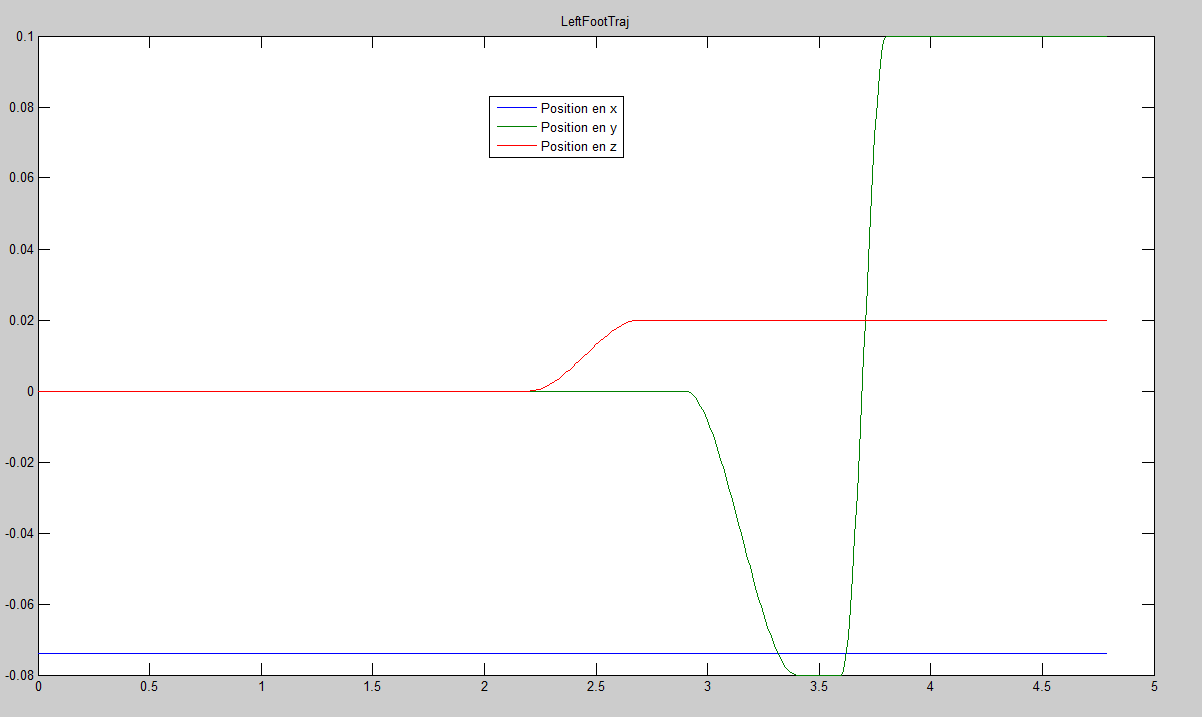
Livrables/Audit 25 octobre/leftfoot.png
