wael-suleiman-UdeS/RobotFoot/Livrables/Audit 25 octobre/Pelvis.png

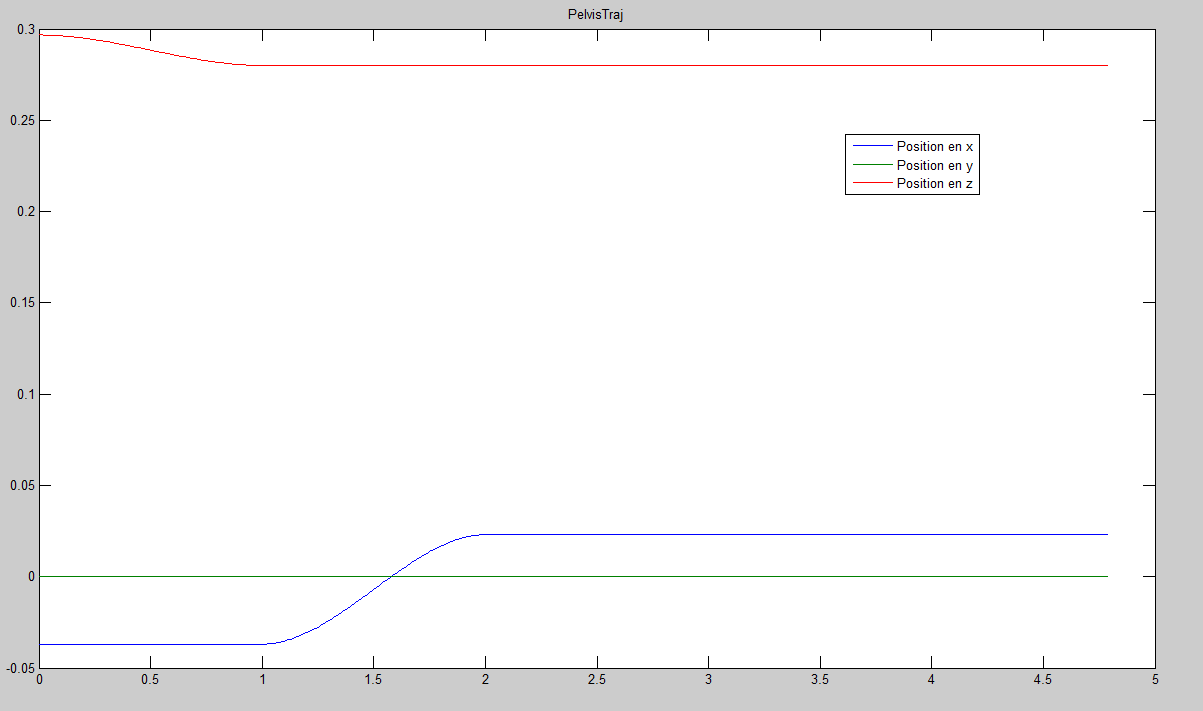
Livrables/Audit 25 octobre/Pelvis.png
