wael-suleiman-UdeS/RobotFoot/Livrables/Audit 25 octobre/sprint16_burndown_chart.png

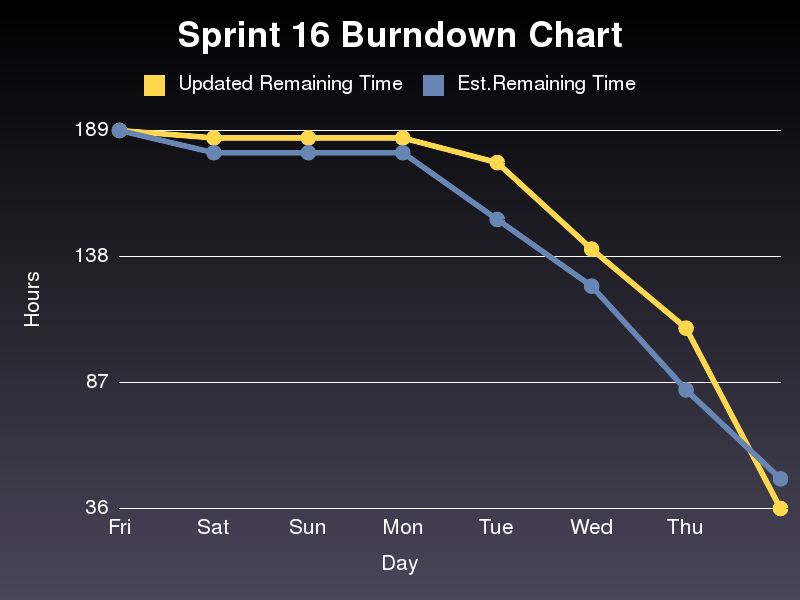
Livrables/Audit 25 octobre/sprint16_burndown_chart.png
