wael-suleiman-UdeS/RobotFoot/Livrables/Audit 25 octobre/sprint17_burndown_chart.png

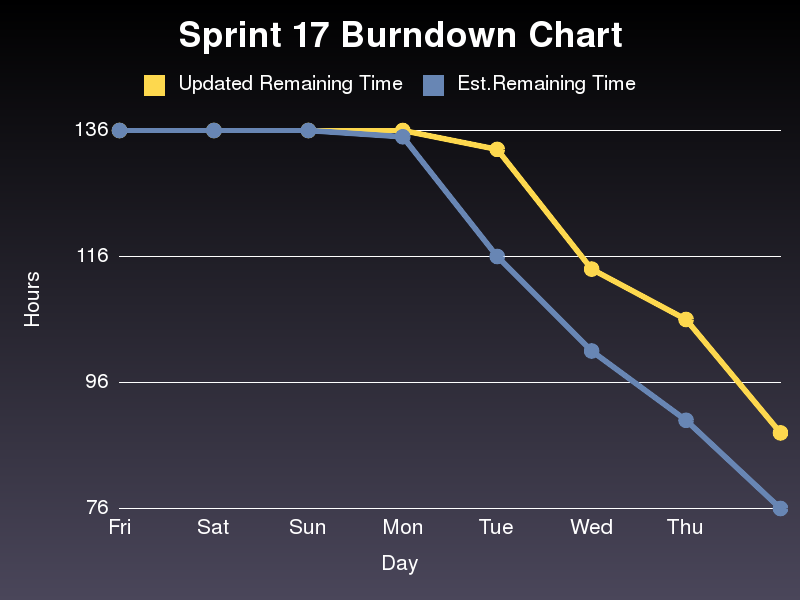
Livrables/Audit 25 octobre/sprint17_burndown_chart.png
