wael-suleiman-UdeS/RobotFoot/Livrables/Audit 25 octobre/sprint18_burndown_chart.png

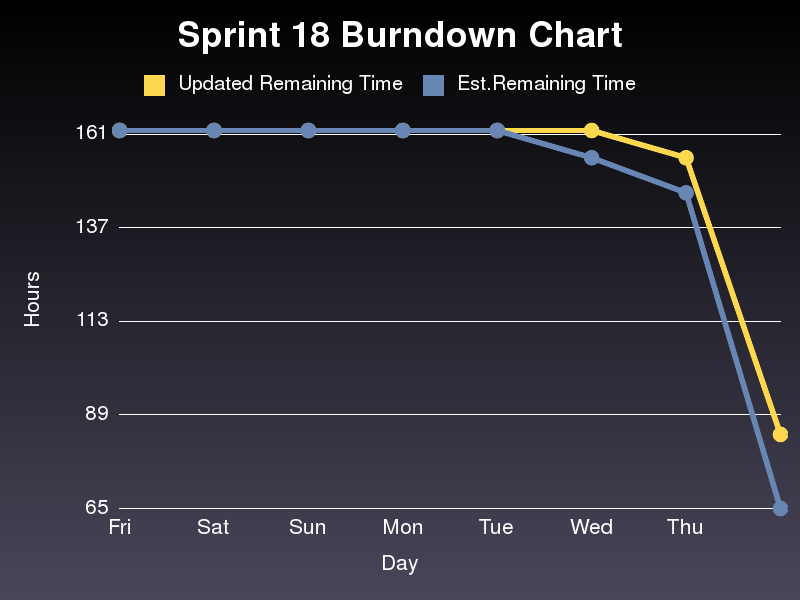
Livrables/Audit 25 octobre/sprint18_burndown_chart.png
