wael-suleiman-UdeS/RobotFoot/Livrables/Audit 25 octobre/SuiviDesHeures.png

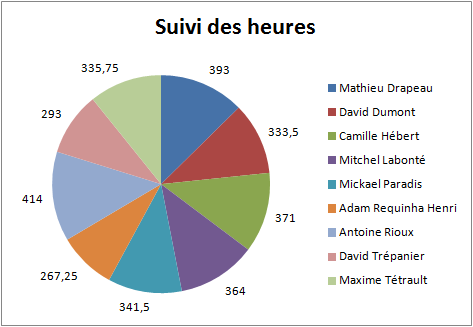
Livrables/Audit 25 octobre/SuiviDesHeures.png
