wael-suleiman-UdeS/RobotFoot/Livrables/MAP/Shémas/Communication des modules.png

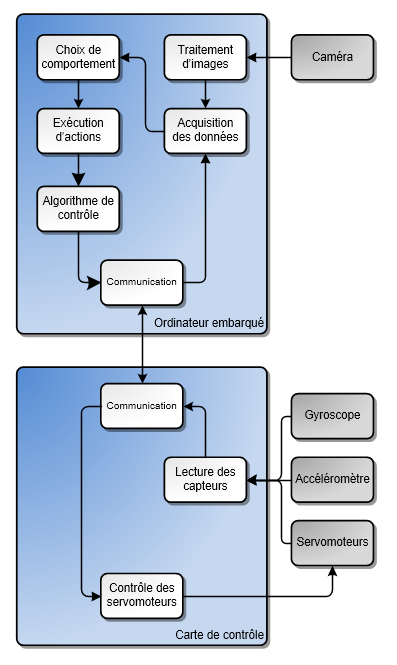
Livrables/MAP/Shémas/Communication des modules.png
