wael-suleiman-UdeS/RobotFoot/Livrables/Présentation Publique/affiche2/Marché.png

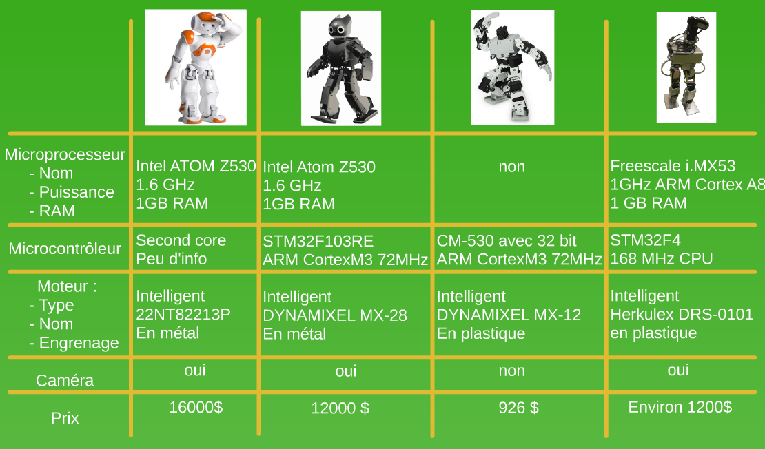
Livrables/Présentation Publique/affiche2/Marché.png
