wael-suleiman-UdeS/RobotFoot/Livrables/Présentation Publique/AFFICHE.png

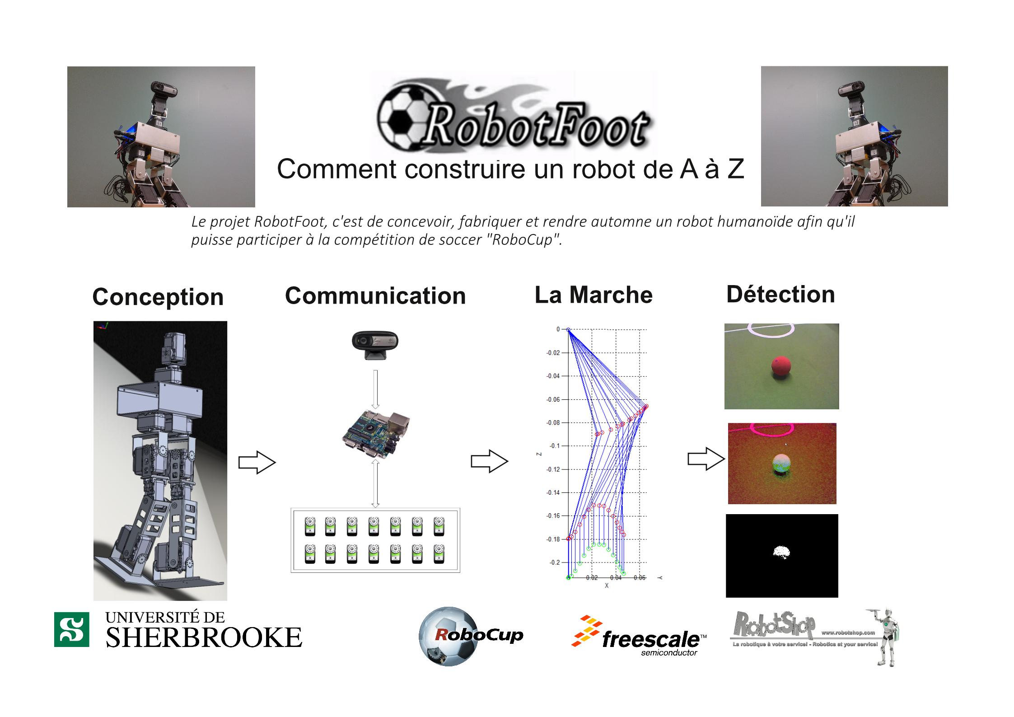
Livrables/Présentation Publique/AFFICHE.png
