wael-suleiman-UdeS/RobotFoot/Livrables/Présentation Publique/Créativité/CameraC170.jpg

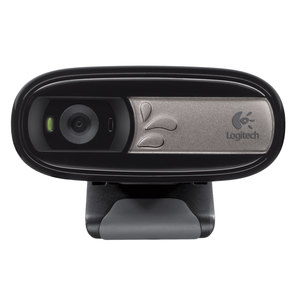
Livrables/Présentation Publique/Créativité/CameraC170.jpg
