wael-suleiman-UdeS/RobotFoot/Livrables/Présentation Publique/Créativité/Communication.jpg

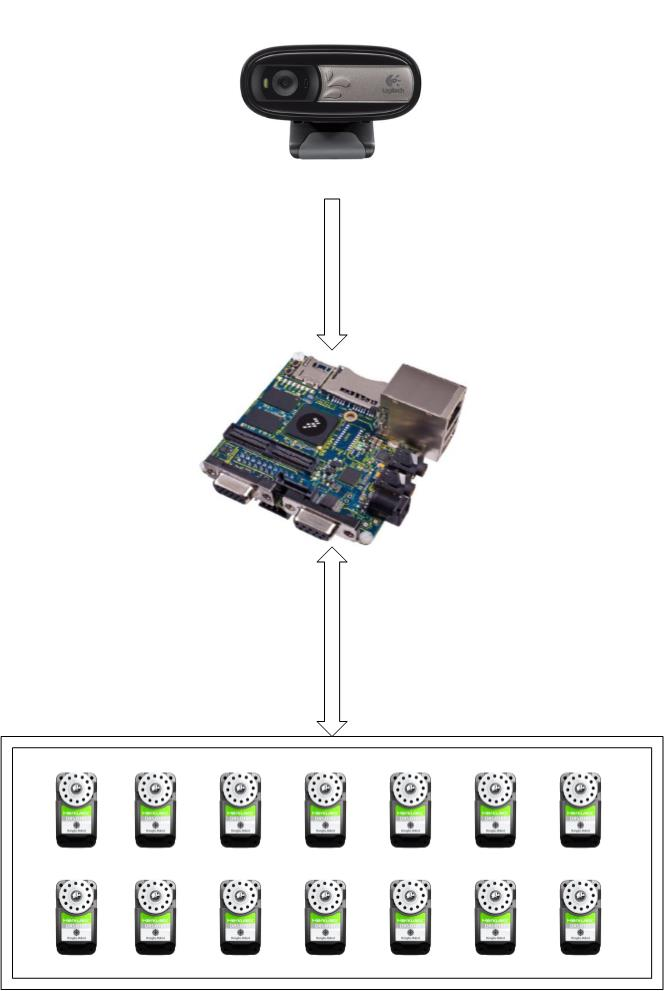
Livrables/Présentation Publique/Créativité/Communication.jpg
