wael-suleiman-UdeS/RobotFoot/Livrables/Présentation Publique/Créativité/freescale1.jpg

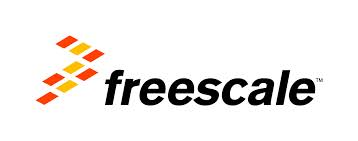
Livrables/Présentation Publique/Créativité/freescale1.jpg
