wael-suleiman-UdeS/RobotFoot/Livrables/Présentation Publique/Créativité/PCB.jpg

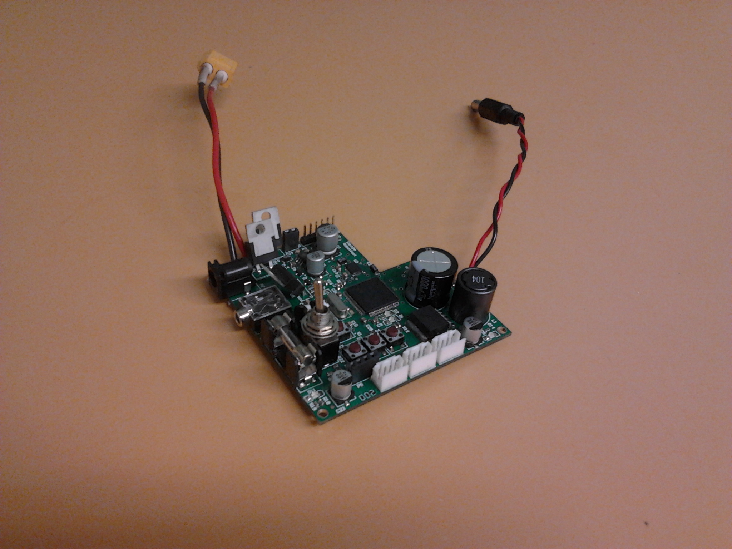
Livrables/Présentation Publique/Créativité/PCB.jpg
