wael-suleiman-UdeS/RobotFoot/Livrables/Présentation Publique/Créativité/PhotoBalle3.png

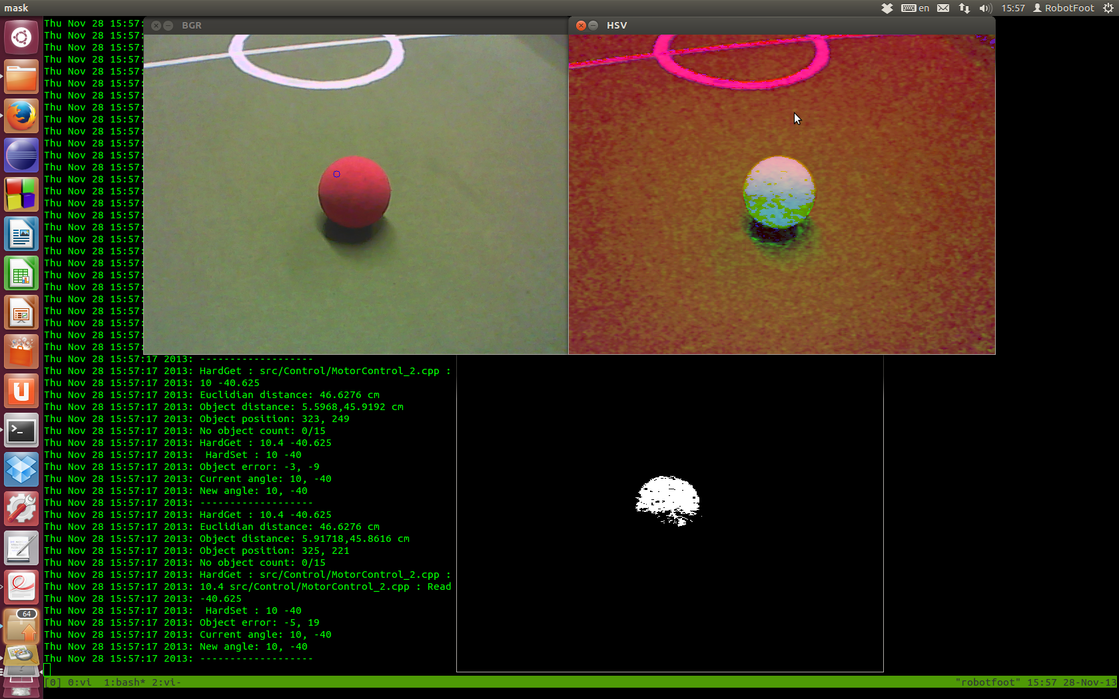
Livrables/Présentation Publique/Créativité/PhotoBalle3.png
