wael-suleiman-UdeS/RobotFoot/Livrables/Présentation Publique/Créativité/robotShop2.jpg

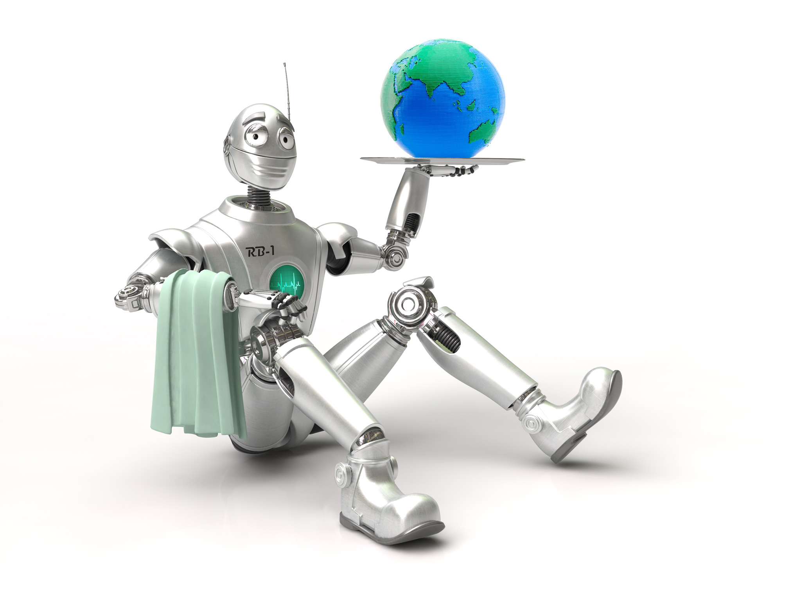
Livrables/Présentation Publique/Créativité/robotShop2.jpg
