wael-suleiman-UdeS/RobotFoot/Livrables/Présentation Publique/Créativité/robotshop3.jpg

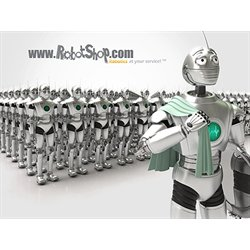
Livrables/Présentation Publique/Créativité/robotshop3.jpg
