wael-suleiman-UdeS/RobotFoot/Livrables/Présentation Publique/Créativité/robotshop.jpg

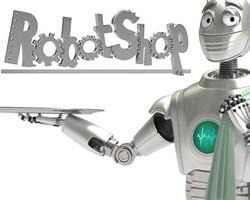
Livrables/Présentation Publique/Créativité/robotshop.jpg
