wael-suleiman-UdeS/RobotFoot/Livrables/Présentation Publique/Images/freescale2.jpg

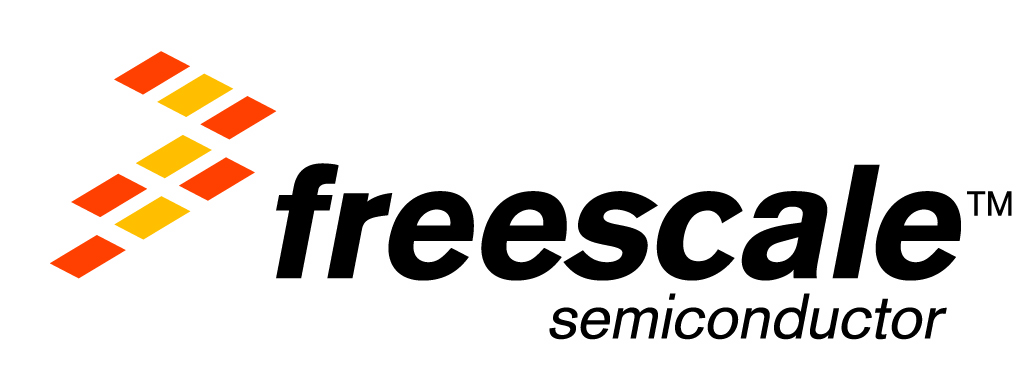
Livrables/Présentation Publique/Images/freescale2.jpg
