wael-suleiman-UdeS/RobotFoot/Livrables/Présentation Publique/Images/PieChartHeures.png

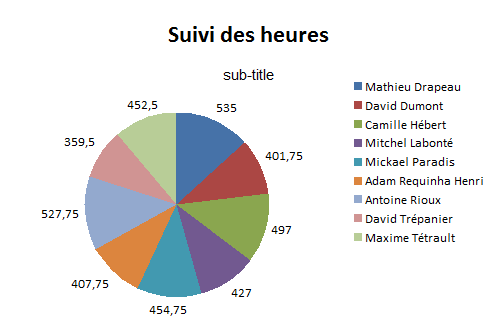
Livrables/Présentation Publique/Images/PieChartHeures.png
