wael-suleiman-UdeS/RobotFoot/Livrables/Présentation Publique/Images/RobotFootReverse.png

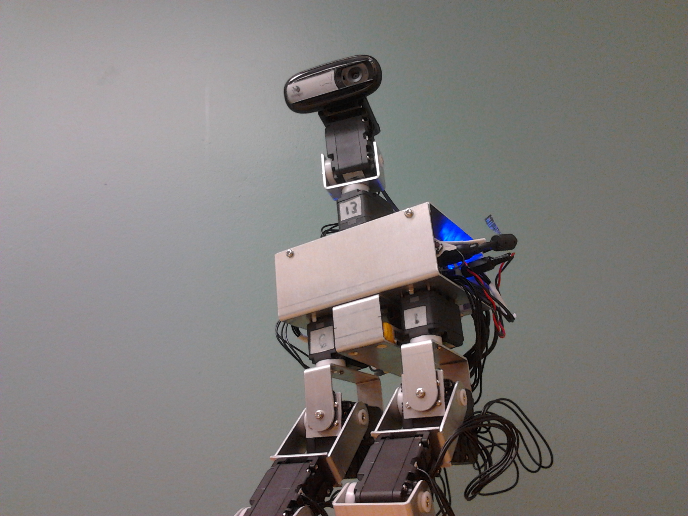
Livrables/Présentation Publique/Images/RobotFootReverse.png
