wael-suleiman-UdeS/RobotFoot/Livrables/Présentation Publique/Images/RobotShop-Blog-Lancement.jpg

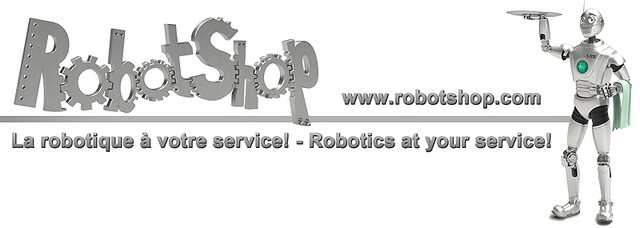
Livrables/Présentation Publique/Images/RobotShop-Blog-Lancement.jpg
