wael-suleiman-UdeS/RobotFoot/Livrables/Présentation Publique/Images/usherbrooke.jpg

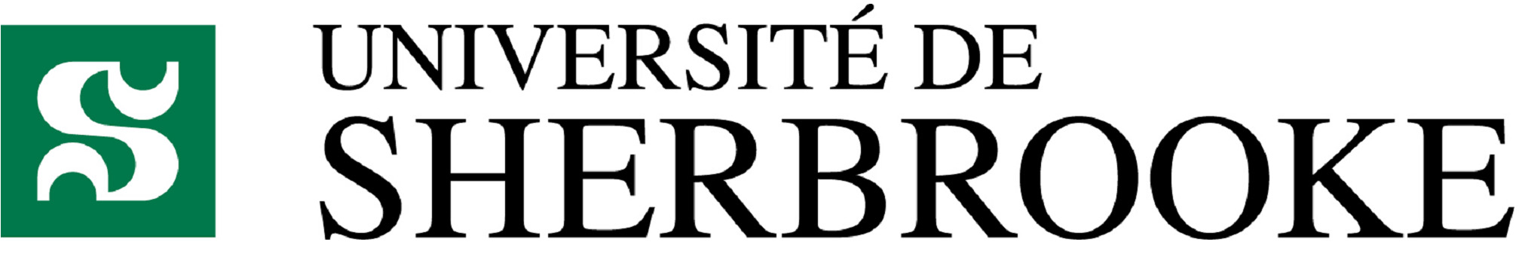
Livrables/Présentation Publique/Images/usherbrooke.jpg
