wael-suleiman-UdeS/RobotFoot/Livrables/Présentation Publique/team15_burndown_chart.png

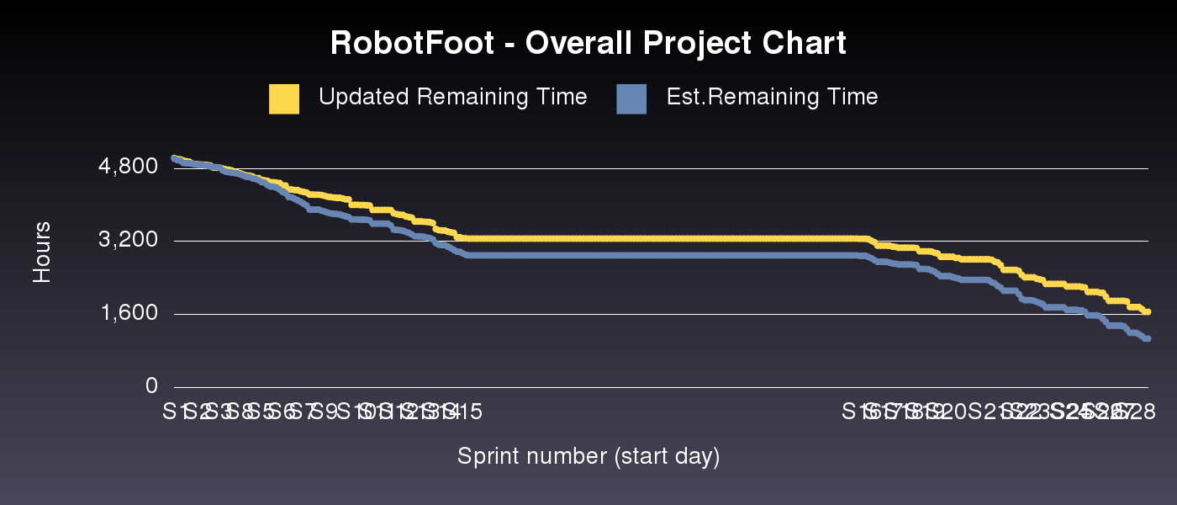
Livrables/Présentation Publique/team15_burndown_chart.png
