wael-suleiman-UdeS/RobotFoot/Marketing/Images/NakedRobot.jpg

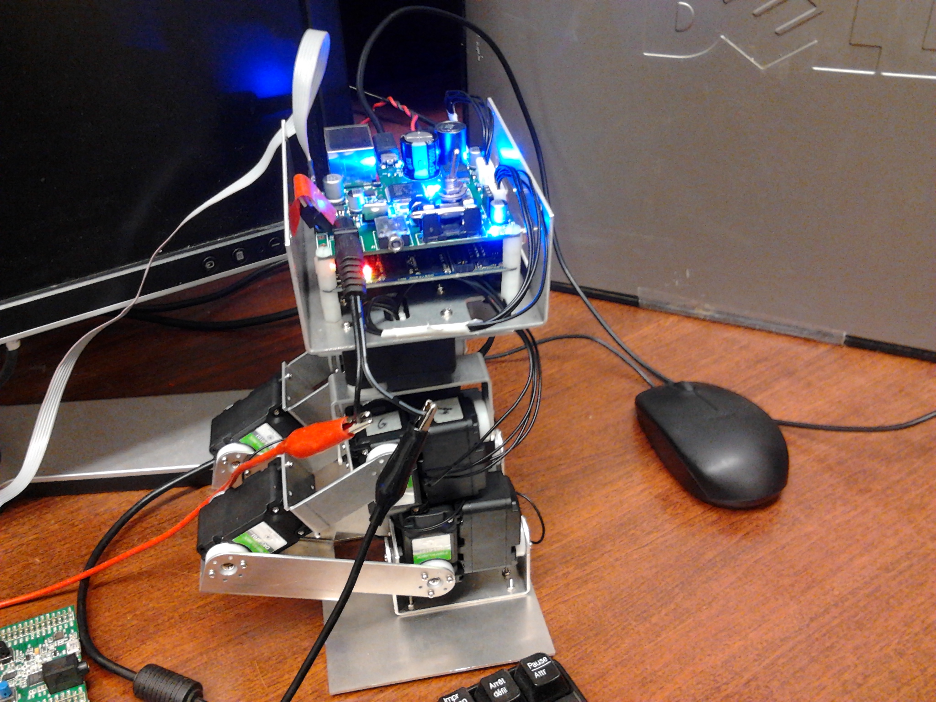
Marketing/Images/NakedRobot.jpg
