wael-suleiman-UdeS/RobotFoot/Marketing/Images/Pensif.jpg

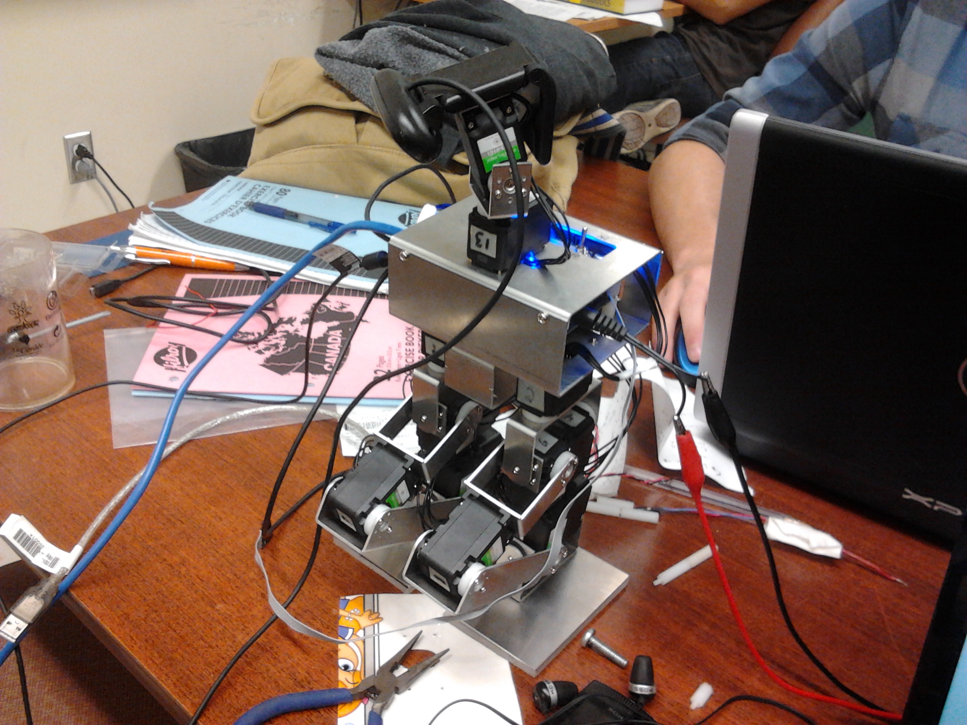
Marketing/Images/Pensif.jpg
