wael-suleiman-UdeS/RobotFoot/Marketing/Images/RobotFoot1.jpg

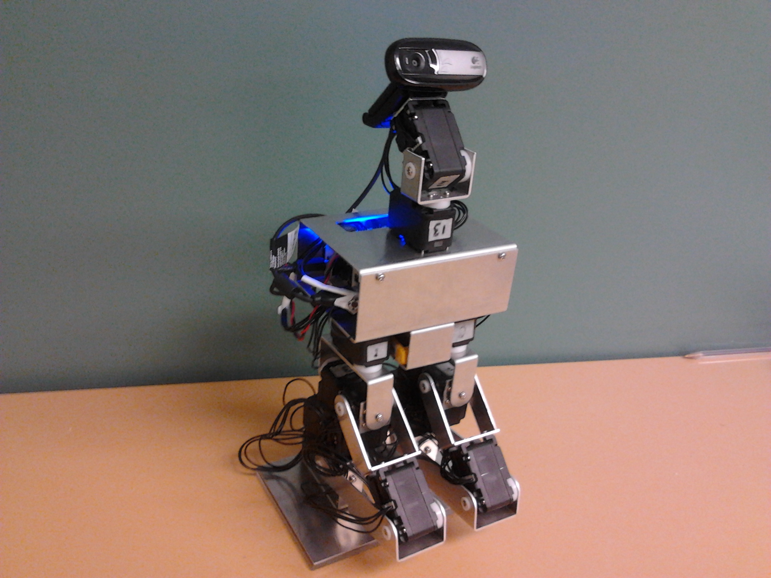
Marketing/Images/RobotFoot1.jpg
