wael-suleiman-UdeS/RobotFoot/Marketing/Images/RobotFoot2.jpg

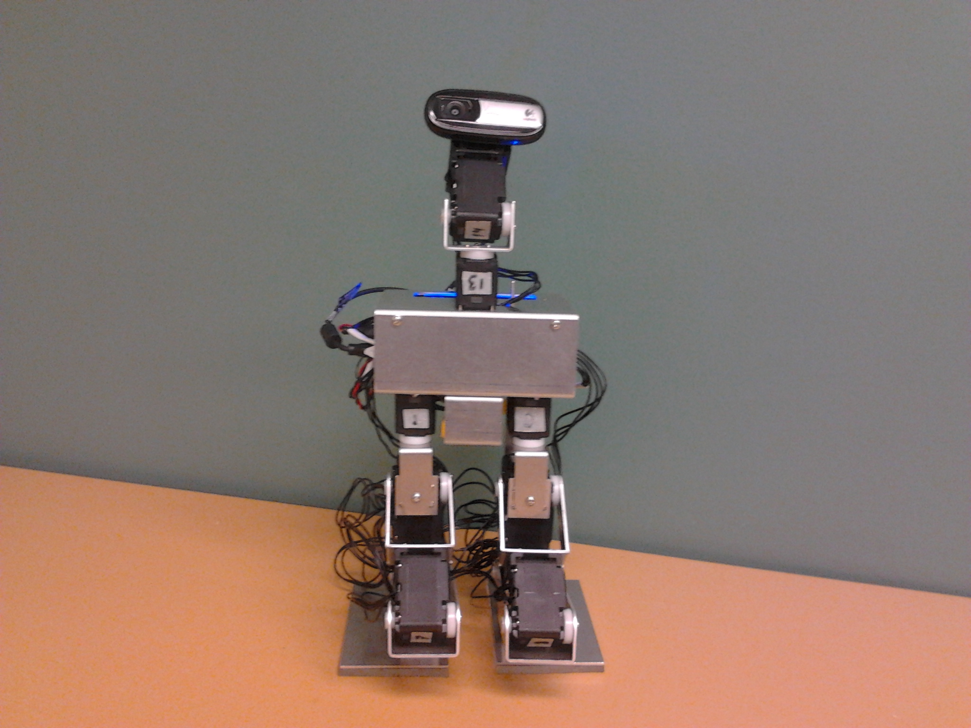
Marketing/Images/RobotFoot2.jpg
