wael-suleiman-UdeS/RobotFoot/Marketing/Images/RobotFoot3.jpg

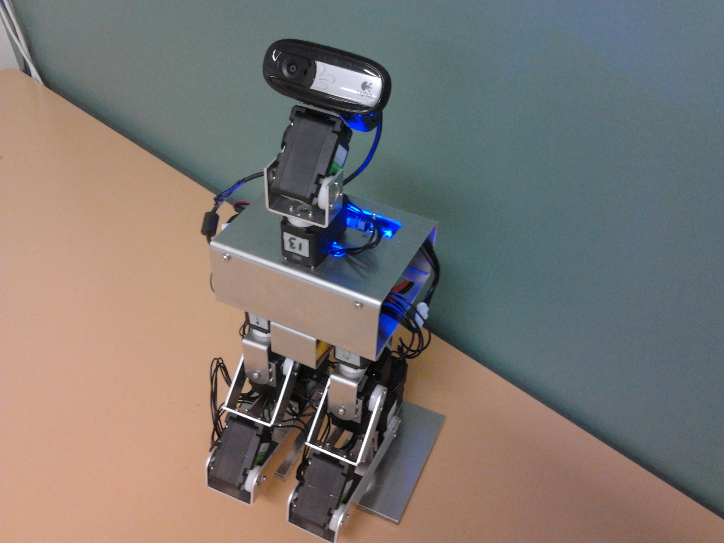
Marketing/Images/RobotFoot3.jpg
