wael-suleiman-UdeS/RobotFoot/Marketing/Images/RobotFoot4.jpg

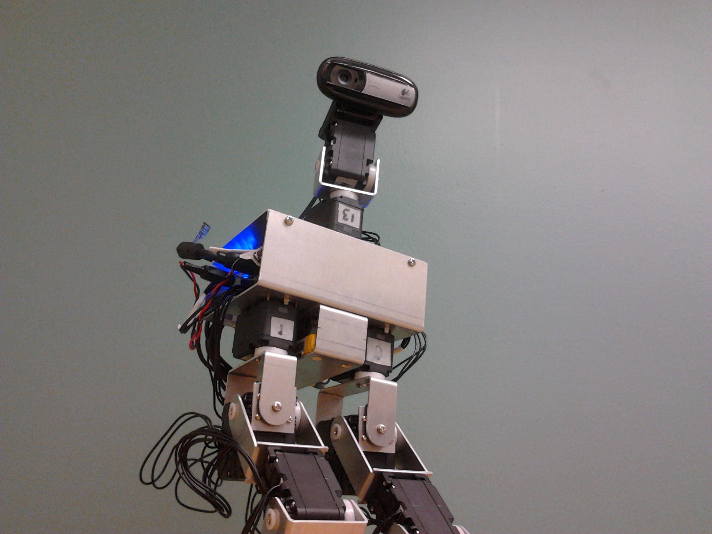
Marketing/Images/RobotFoot4.jpg
