wael-suleiman-UdeS/RobotFoot/Marketing/Images/RobotFoot5.jpg

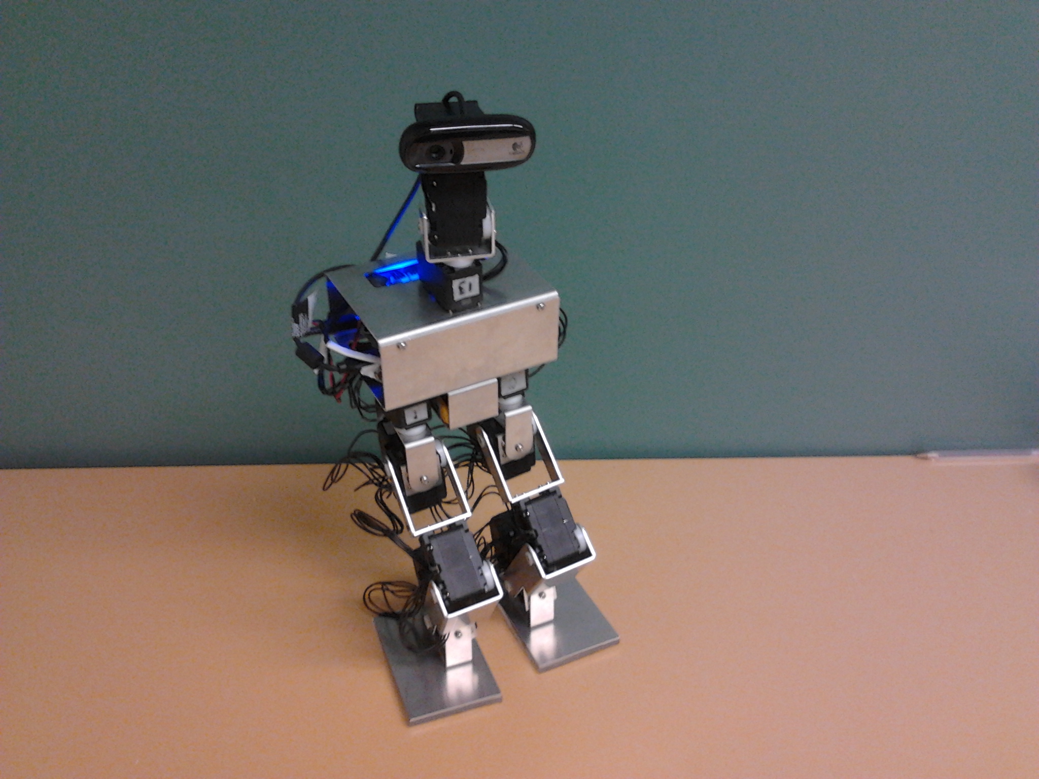
Marketing/Images/RobotFoot5.jpg
