wael-suleiman-UdeS/RobotFoot/Marketing/Images/RobotFoot6.jpg

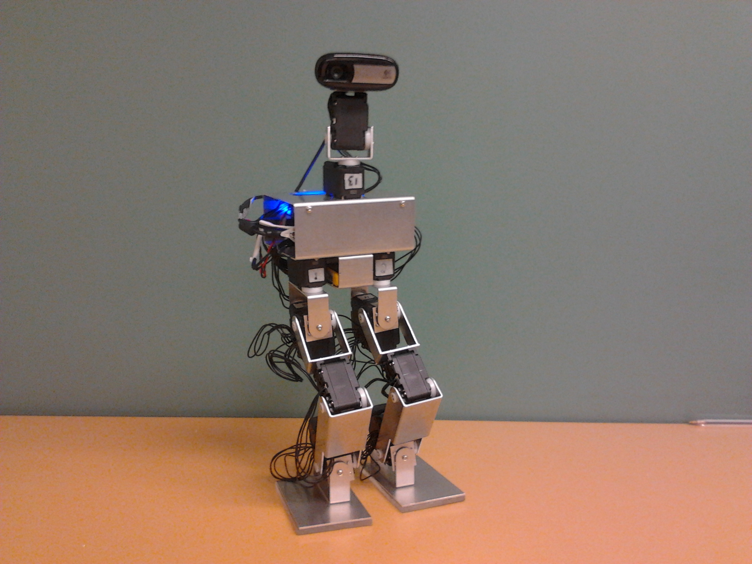
Marketing/Images/RobotFoot6.jpg
