wael-suleiman-UdeS/RobotFoot/Marketing/Images/RobotFoot7.jpg

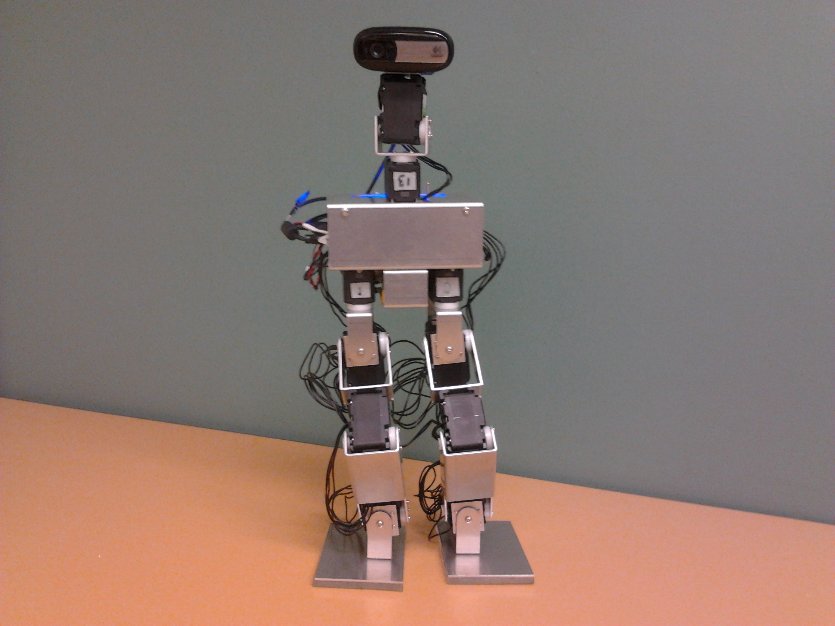
Marketing/Images/RobotFoot7.jpg
