wael-suleiman-UdeS/RobotFoot/Marketing/Images/Sad.jpg

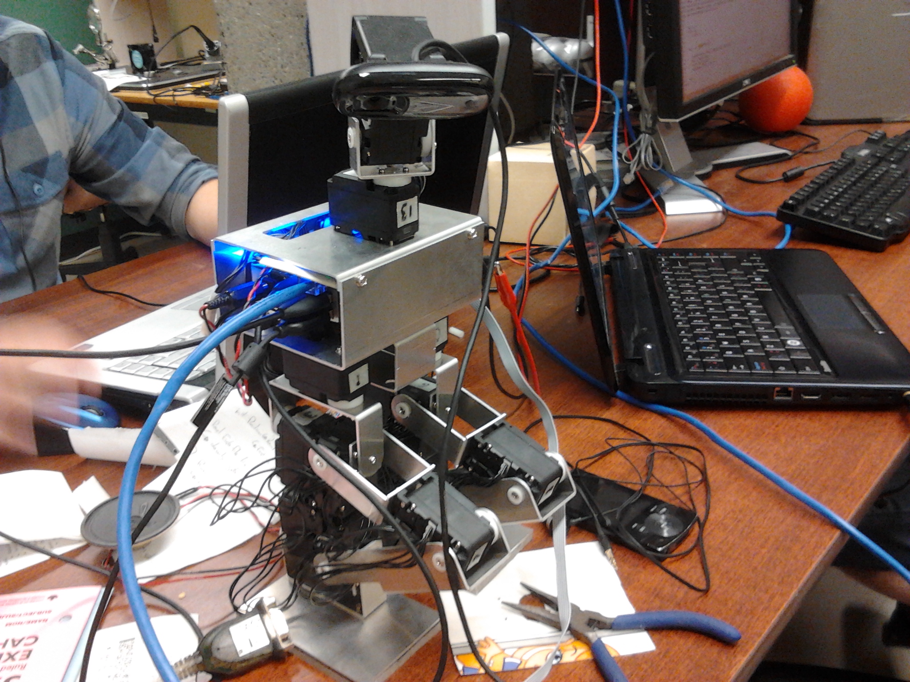
Marketing/Images/Sad.jpg
