wael-suleiman-UdeS/RobotFoot/Marketing/photos/DSCF0173.JPG

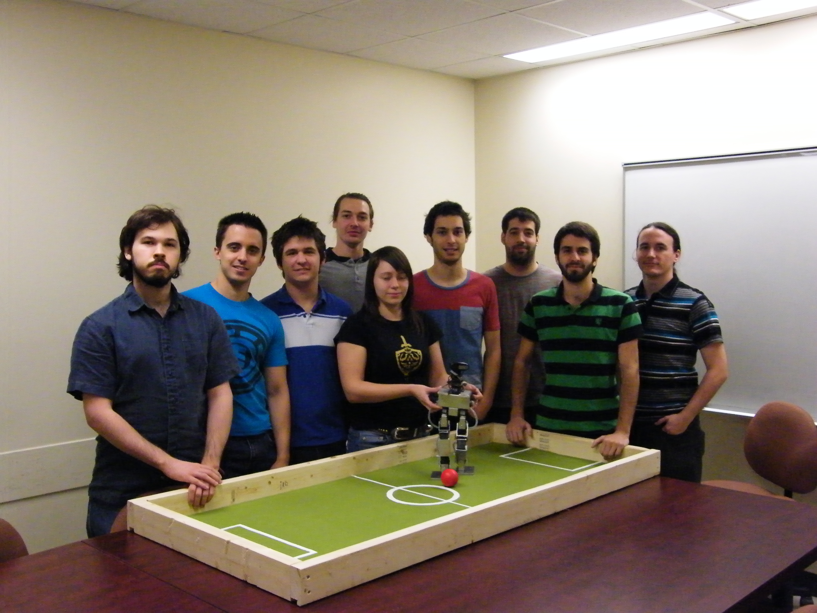
Marketing/photos/DSCF0173.JPG
