wael-suleiman-UdeS/RobotFoot/Marketing/photos/DSCF0176.JPG

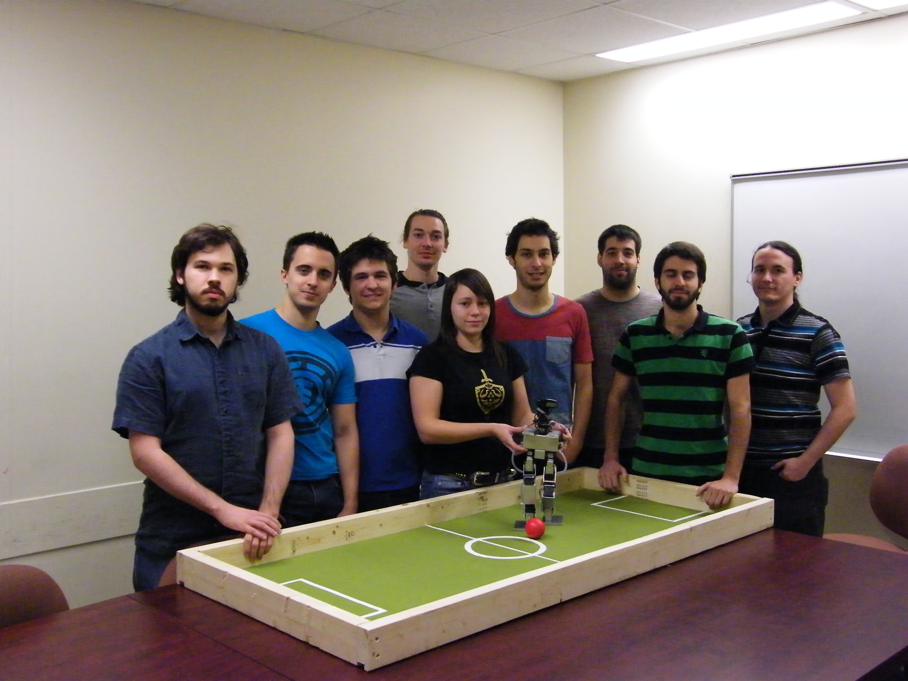
Marketing/photos/DSCF0176.JPG
