wael-suleiman-UdeS/RobotFoot/Marketing/photos/DSCF0177.JPG

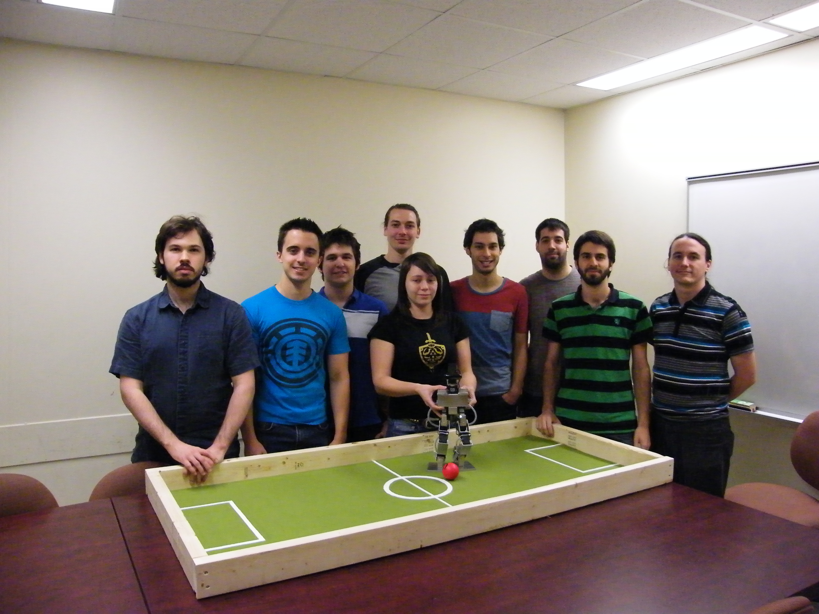
Marketing/photos/DSCF0177.JPG
