wael-suleiman-UdeS/RobotFoot/Marketing/photos/DSCF0179.JPG

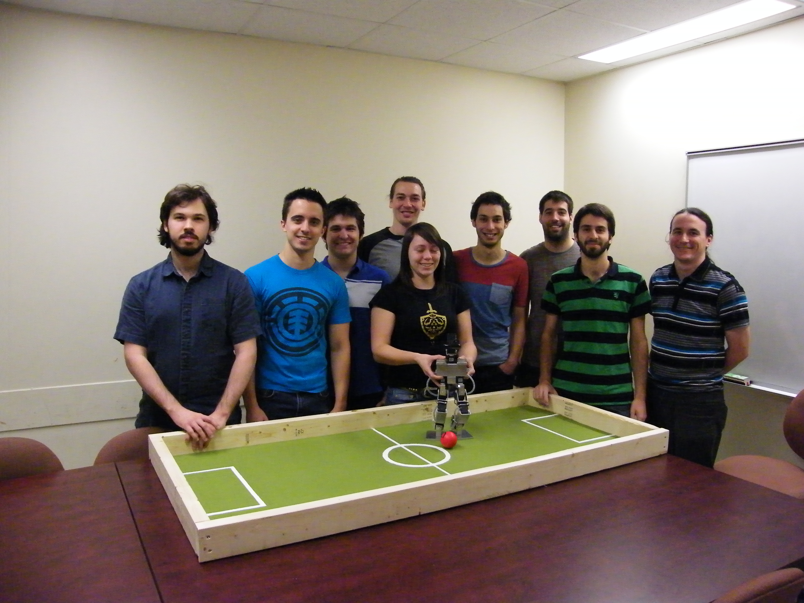
Marketing/photos/DSCF0179.JPG
