wael-suleiman-UdeS/RobotFoot/Matlab/bezier/TrajectoireCom.png

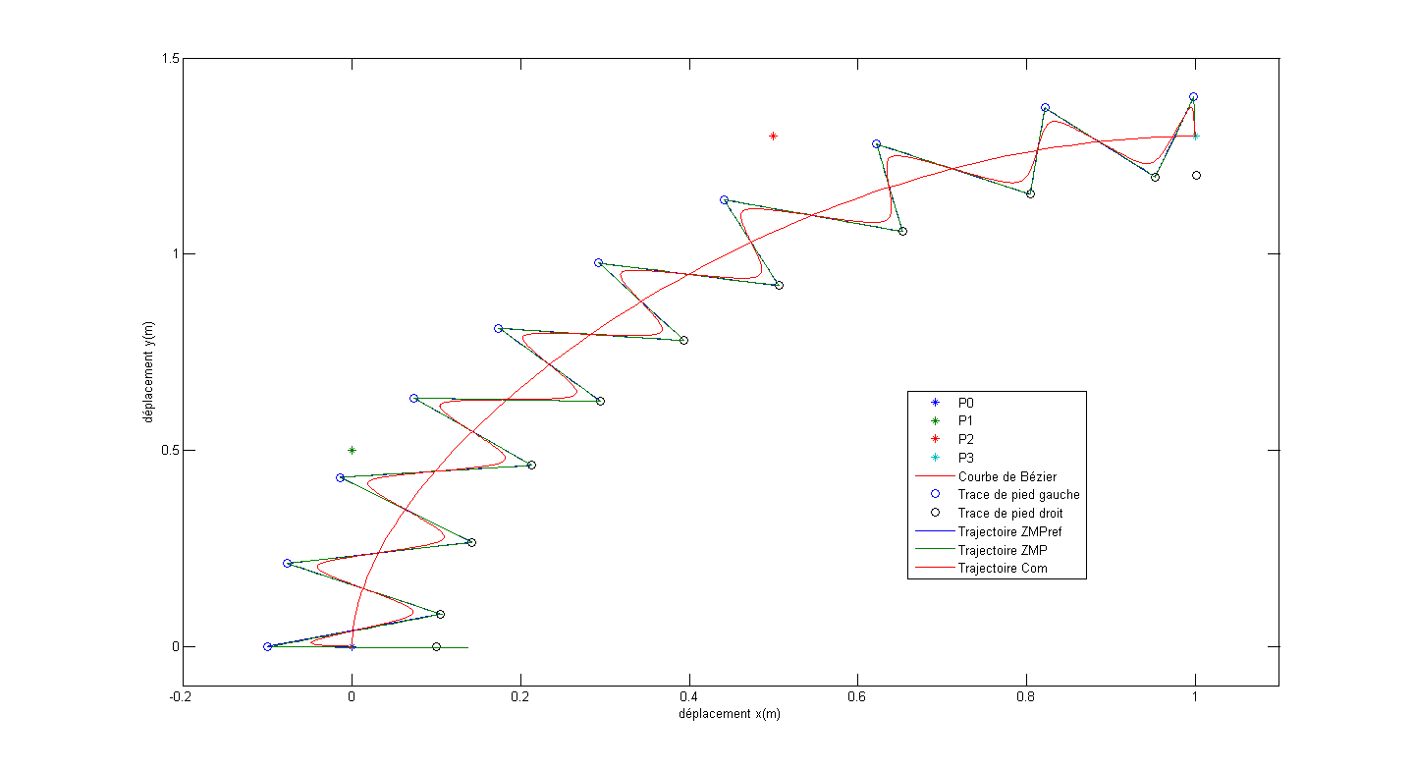
Matlab/bezier/TrajectoireCom.png
