wael-suleiman-UdeS/RobotFoot/solidworks/Exports/Plans/pdf/global.png

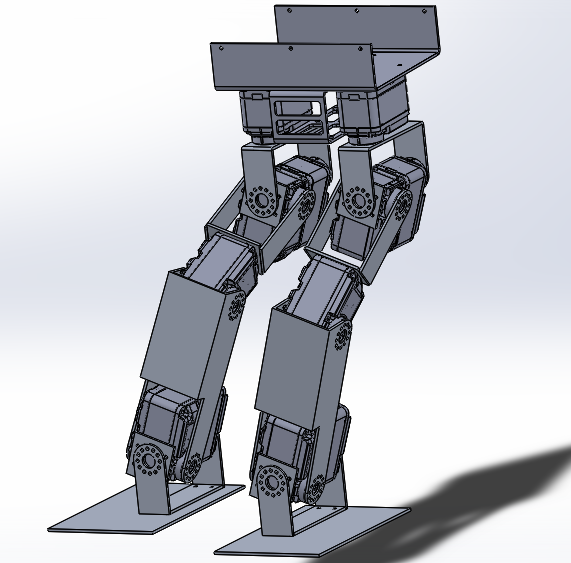
solidworks/Exports/Plans/pdf/global.png
