wael-suleiman-UdeS/RobotFoot/solidworks/Exports/screenshot2.png

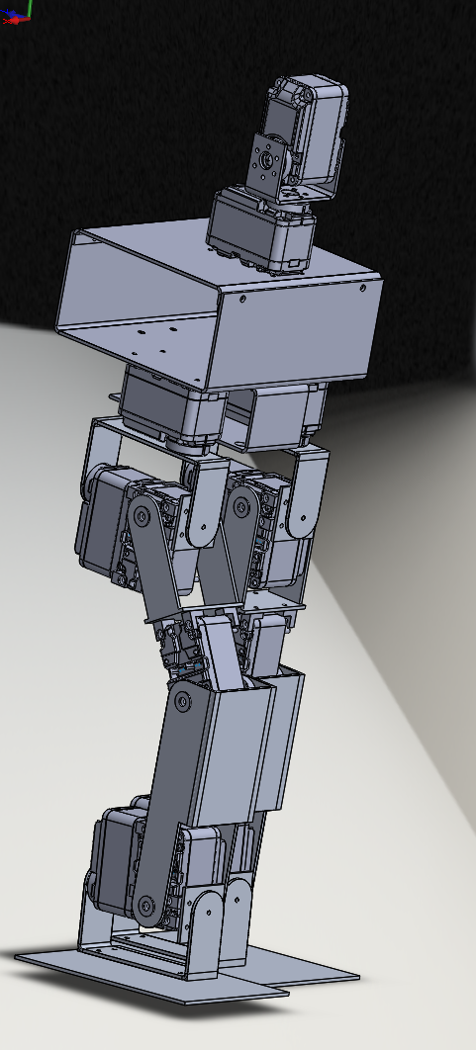
solidworks/Exports/screenshot2.png
