wael-suleiman-UdeS/RobotFoot/solidworks/Exports/screenshot.png

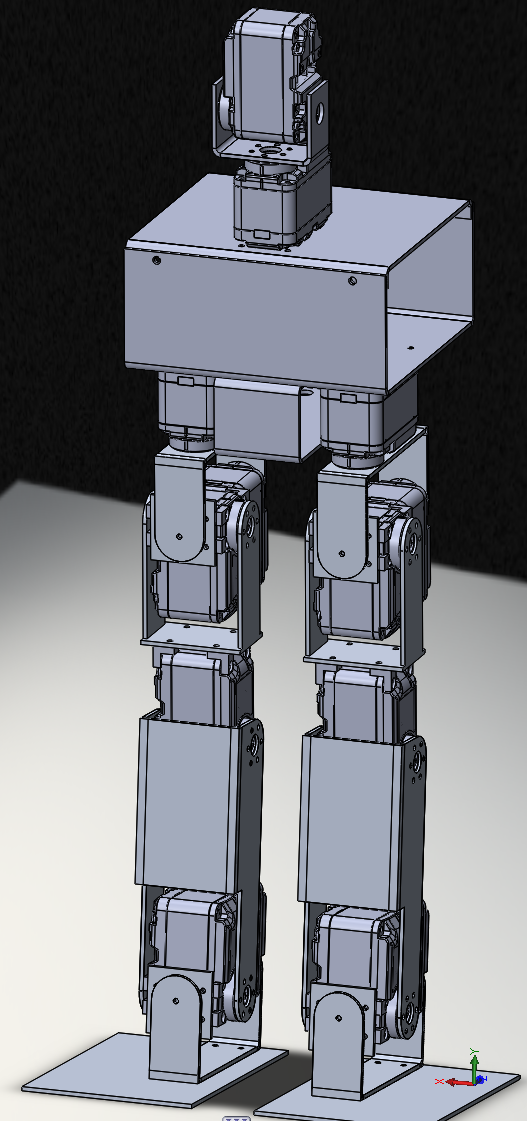
solidworks/Exports/screenshot.png
