wael-suleiman-UdeS/RobotFoot/Budget/achat fin de session.xlsx

Item | Qté. | Prix Unit. | Coût | ref.
HerkuleX DRS-0101 Smart Robot Servo (http://www.robotshop.com/en/herkulex-drs-0101-robot-servo.html) | 14 | 39.99 | 559.86 $ | www.robotshop.ca
BD-SL-i.MX6 | 1 | 184.37 | 184.37 $ | http://www.canada.newark.com/freescale-semiconductor/mcimx6q-sl/i-mx6-hdmi-lvds-rj45-sabre-lite/dp/05W6138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
ZIPPY Compact 1300mAh 2S 25C Lipo Pack | 2 | 6.34 | 12.68 $ | http://www.hobbyking.com/hobbyking/store/__21337__ZIPPY_Compact_1300mAh_2S_25C_Lipo_Pack.html
 |  | 756.91 $
TPS | 5% | 37.85 $
TVQ | 9.5% | 75.50 $
TOTAL = |  | 870.26 $
