wael-suleiman-UdeS/RobotFoot/Budget/Budget et suivi.xlsx

Sheet: Budget global
 | BUDGET GLOBAL
 | Prix | Quantité | Totaux
Revenu |  |  | 2290.64 $ |  | GRAND TOTAL : | -138.17 $
Financement
Du département | 2000.00 $ | 1 | 2000.00 $
Commandites
RobotShop | 4.31 $ | 14 | 60.38 $
Freescale | 172.50 $ | 1 | 172.50 $
Échantillons | 26.71 $ | 1 | 26.71 $
Université | 31.05 $ | 1 | 31.05 $
 |  |  |  |  |  | Prix | Quantité | Totaux | Avec Taxe |  | Prix | Quantité | Totaux | Avec Taxe
 |  |  |  |  | Dépenses planifiées |  |  | 1980.00 $ | 2277.00 $ | Dépenses planifiées pour un tier |  |  | 1304.00 $ | 1499.60 $
 |  |  |  |  | Tête |  |  |  |  | Tête
 | Prix | Quantité | Totaux | Avec Taxe | Caméra | 25.00 $ | 2 | 50.00 $ |  | Caméra | 25.00 $ | 1 | 25.00 $
Dépenses |  |  | 2112.01 $ | 2428.81 $ | Servomoteur | 37.50 $ | 4 | 150.00 $ |  | Servomoteur | 37.50 $ | 2 | 75.00 $
Tête |  |  |  |  | Torse |  |  |  |  | Torse |  |  |  |  | 100
Caméra | 22.88 $ | 1 | 22.88 $ |  | Batterie | 15.00 $ | 2 | 30.00 $ |  | Batterie | 31.00 $ | 1 | 31.00 $
Servomoteur 1er commande | 37.50 $ | 2 | 75.00 $ |  | CPU | 150.00 $ | 2 | 300.00 $ |  | CPU | 150.00 $ | 1 | 150.00 $
Servomoteur 2e commande | 39.99 $ | 2 | 79.98 $ |  | Carte controleur |  |  |  |  | Carte controleur
Torse |  |  |  |  | Micro-controlleur | 13.00 $ | 2 | 26.00 $ |  | Micro-controlleur | 13.00 $ | 1 | 13.00 $
Chargeur | 28.00 $ | 1 | 28.00 $ |  | PCB | 40.00 $ | 2 | 80.00 $ |  | PCB | 41.31 $ | 1 | 41.31 $
Batterie | 6.34 $ | 3 | 19.02 $ |  | Composants (résistances, condensateurs, etc.) | 5.00 $ | 2 | 10.00 $ |  | Composants (résistances, condensateurs, etc.) | 5.00 $ | 1 | 5.00 $
CPU | 149.99 $ | 1 | 149.99 $ |  | Régulateur 5V | 20.00 $ | 2 | 40.00 $ |  | Régulateur 5V | 20.00 $ | 1 | 20.00 $
Carte controleur |  |  |  |  | Régulateur 3V | 2.00 $ | 2 | 4.00 $ |  | Régulateur 3V | 2.00 $ | 1 | 2.00 $
Micro-controlleur | 7.16 $ | 1 | 7.16 $ |  | Gyroscope/Accéléromètre | 20.00 $ | 2 | 40.00 $ |  | Gyroscope/Accéléromètre | 3.69 $ | 1 | 3.69 $
PCB (paquet de 10) | 47.51 $ | 1 | 47.51 $ |  | Jambe |  |  |  |  | Jambe |  |  |  |  | 266.00 $
Composants (résistances, condensateurs, etc.) | 111.97 $ | 1 | 111.97 $ |  | Servomoteur | 37.50 $ | 24 | 900.00 $ |  | Servomoteur | 37.50 $ | 12 | 450.00 $ |  | 450
Jambe |  |  |  |  | Autres |  |  |  |  | Autres
Servomoteur 1er commande | 37.50 $ | 12 | 450.00 $ |  | Fabrication des pièces | 175.00 $ | 2 | 350.00 $ |  | Fabrication des pièces | 488.00 $ | 1 | 488.00 $ |  | 275
Servomoteur 2e commande | 39.99 $ | 12 | 479.88 $ |  |  | Prix | Quantité | Totaux |  |  | Prix | Quantité | Totaux
Terrain de soccer
2x4 bois | 2.52 $ | 2 | 5.04 $
Tissu vert, 2mx1m | 11.99 $ | 1 | 11.99 $
Peinture et colle | 14.16 $ | 1 | 14.16 $
Appret, Peinture, Pinceaux, bouche pore et chiffons | 33.35 $ | 1 | 33.35 $
Autres
Fabrication des pièces | 388.00 $ | 1 | 388.00 $
Servomoteur | 39.99 $ | 2 | 79.98 $
Frais des douanes (IMX3) | 29.25 $ | 1 | 29.25 $
CarteSD | 9.88 $ | 1 | 9.88 $
Lecteur USB<->SD | 10.67 $ | 1 | 10.67 $
Poids | 9.00 $ | 1 | 9.00 $
Balles de couleur | 1.50 $ | 4 | 6.00 $
Essence | 31.30 $ | 1 | 31.30 $
Vis/Flat Washer/Hex Nut | 12.00 $ | 1 | 12.00 $
 | Prix | Quantité | Totaux

Sheet: Suivi Budgetaire
Suivi budgetaire |  |  |  | Suivi budgetaire planifié
Date | Montant ajouté | Cumulatif | Achat | Date | Montant ajouté | Cumulatif | Achat
2013-01-06 | 0.00 $ | 0.00 $ | - | 2013-01-06 | 0.00 $ | 0.00 $ | -
2013-01-13 | 0.00 $ | 0.00 $ | - | 2013-01-13 | 0.00 $ | 0.00 $ | -
2013-01-20 | 0.00 $ | 0.00 $ | - | 2013-01-20 | 0.00 $ | 0.00 $ | -
2013-01-27 | 0.00 $ | 0.00 $ | - | 2013-01-27 | 0.00 $ | 0.00 $ | -
2013-02-03 | 0.00 $ | 0.00 $ | - | 2013-02-03 | 0.00 $ | 0.00 $ | -
2013-02-10 | 0.00 $ | 0.00 $ | - | 2013-02-10 | 0.00 $ | 0.00 $ | -
2013-02-17 | 100.32 $ | 100.32 $ | 2 X Servomoteur HerkuleX | 2013-02-17 | 28.75 $ | 28.75 $ | 1 x Caméra
 | 2.69 $ | 103.01 $ | 1 X Phillips Head Screws Package 100 |  | 86.25 $ | 115.00 $ | 2 X Servomoteur
 | 550.46 $ | 653.47 $ | 14 X Servomoteur HerkuleX |  | 603.75 $ | 718.75 $ | 14 x Servomoteur
2013-02-24 |  | #N/A |  | 2013-02-24 | 132.25 $ | 851.00 $ | 1 x CPU
2013-03-03 | 34.41 $ | #N/A | Frais des douanes (CPU) | 2013-03-03 | 17.25 $ | 868.25 $ | 1 x Batterie
2013-03-10 |  | #N/A |  | 2013-03-10 | 115.00 $ | 983.25 $ | 1 x Carte Controleur
2013-03-17 |  | #N/A |  | 2013-03-17 | 201.25 $ | 1184.50 $ | Fabrication des pièces Jambes
2013-03-24 |  | #N/A |  | 2013-03-24 | 0.00 $ | 1184.50 $ | -
2013-03-31 |  | #N/A |  | 2013-03-31 | 0.00 $ | 1184.50 $ | -
2013-04-07 |  | #N/A |  | 2013-04-07 | 0.00 $ | 1184.50 $ | -
2013-04-14 |  | #N/A |  | 2013-04-14 | 0.00 $ | 1184.50 $ | -
2013-04-21 |  | #N/A |  | 2013-04-21 | 0.00 $ | 1184.50 $ | -
STAGE |  |  |  | STAGE
2013-09-01 |  | #N/A |  | 2013-09-01 | 0.00 $ | 1184.50 $ | -
2013-09-08 |  | #N/A |  | 2013-09-08 | 1299.50 $ | 2484.00 $ | -
2013-09-15 |  | #N/A |  | 2013-09-15 | 0.00 $ | 2484.00 $ | -
2013-09-22 |  | #N/A |  | 2013-09-22 | 0.00 $ | 2484.00 $ | -
2013-09-29 |  | #N/A |  | 2013-09-29 | 0.00 $ | 2484.00 $ | -
2013-10-06 |  | #N/A |  | 2013-10-06 | 0.00 $ | 2484.00 $ | -
2013-10-13 |  | #N/A |  | 2013-10-13 | 0.00 $ | 2484.00 $ | -
2013-10-20 |  | #N/A |  | 2013-10-20 | 0.00 $ | 2484.00 $ | -
2013-10-27 |  | #N/A |  | 2013-10-27 | 0.00 $ | 2484.00 $ | -
2013-11-03 |  | #N/A |  | 2013-11-03 | 0.00 $ | 2484.00 $ | -
2013-11-10 |  | #N/A |  | 2013-11-10 | 0.00 $ | 2484.00 $ | -
2013-11-17 |  | #N/A |  | 2013-11-17 | 0.00 $ | 2484.00 $ | -
2013-11-24 |  | #N/A |  | 2013-11-24 | 0.00 $ | 2484.00 $ | -
 |  |  |  | 2519.22 $
 |  |  |  | 2519.22 $
 |  |  |  | 2519.22 $
 |  |  |  | 2519.22 $
 |  |  |  | 2519.22 $
 |  |  |  | 2519.22 $
 |  |  |  | 2519.22 $
 |  |  |  | 2519.22 $
 |  |  |  | 2519.22 $
 |  |  |  | 2519.22 $
 |  |  |  | 2519.22 $
 |  |  |  | 2519.22 $
 |  |  |  | 2519.22 $
 |  |  |  | 2519.22 $
 |  |  |  | 2519.22 $
 |  |  |  | 2519.22 $
 |  |  |  | 2519.22 $
 |  |  |  | 2519.22 $
 |  |  |  | 2519.22 $
 |  |  |  | 2519.22 $
 |  |  |  | 2519.22 $
 |  |  |  | 2519.22 $
 |  |  |  | 2519.22 $
 |  |  |  | 2519.22 $
 |  |  |  | 2519.22 $
 |  |  |  | 2519.22 $
 |  |  |  | 2519.22 $
 |  |  |  | 2519.22 $
 |  |  |  | 2519.22 $
 |  |  |  | 2519.22 $
