wael-suleiman-UdeS/RobotFoot/Budget/Budget Preliminaire.xls

 | BUDGET PRÉLIMINAIRE
Nom | Description | Prix | Quantité
FSLBOT | Tower System mechatronics board | 199 | 1
 | 4x PWM controlled RC servos
 | Leg mechanics and associated hardware
 | Bipedal 4DOF walking robot assembly instructions |  |  | Total : | 303
 | Tower System mechatronics board user guide
 | Quick Start Guide
1320XRFC | The 1320XRFC daughter card supports direct connection to ColdFire MCU development boards, providing an ideal platform for developing wireless applications | 79 | 1
LFDA8451 | The LFDA8451 is a device adapter for Freescale’s MMA8451Q 14-bit, 3-axis accelerometer | 25 | 1
Servomoteur |  |  | 8
Camera |  |  | 2
Construcion piece 3D |  |  | X
CodeWarrior IDE |  |  | 9?
Autre senseur |  |  | X
