wael-suleiman-UdeS/RobotFoot/Livrables/Audit 23 avril/Classeur3.xlsx

Source de revenus |  | Montant | Quantité | Total
Financement
 | Département de génie électrique et informatique | 2 000,00 $ | 1 | 2 000,00 $
Commandites
 | Département de génie électrique et informatique | 31,05 $ | 2 | 62,10 $
 | Freescale | 172,50 $ | 2 | 345,00 $
 | RobotShop | 4,31 $ | 26 | 112,13 $
 |  |  | Total | 2 519,23 $
 | Source de revenus | Montant | Quantité | Total
 | Financement
 | Département de génie électrique et informatique | 2 000,00 $ | 1 | 2 000,00 $
 | Commandites
 | Département de génie électrique et informatique | 31,05 $ | 2 | 62,10 $
 | Freescale | 172,50 $ | 2 | 345,00 $
 | RobotShop | 4,31 $ | 26 | 112,13 $
 |  |  | Total | 2 519,23 $
Composant |  |  | Coût | Quantité | Total
Tête
 | Caméra |  | 25,00 $ | 2 | 50,00 $
 | Servomoteur |  | 37,50 $ | 4 | 150,00 $
Torse
 | Batterie |  | 15,00 $ | 2 | 30,00 $
 | Ordinateur embarqué i.MX53 Quick Start Board |  | 150,00 $ | 2 | 300,00 $
 | Carte de contrôle
 |  | Microcontrôleur STM32F4 | 13,00 $ | 2 | 26,00 $
 |  | PCB | 40,00 $ | 2 | 80,00 $
 |  | Composants (résistances, condensateurs, etc.) | 5,00 $ | 2 | 10,00 $
 |  | Régulateur 5V | 20,00 $ | 2 | 40,00 $
 |  | Régulateur 3V | 2,00 $ | 2 | 4,00 $
 |  | Gyroscope/Accéléromètre | 20,00 $ | 2 | 20,00 $
Jambes |  |  |  |  |  | Composant |  |  | Quantité | Total
 | Servomoteur |  | 37,50 $ | 24 | 900,00 $ | Tête
 | Fabrication des pièces |  | 275,00 $ | 2 | 550,00 $ | Caméra |  | 25.00 $ | 2 | 50.00 $
 |  |  |  | Sous-total | 2 180,00 $ | Servomoteur |  | 37.50 $ | 4 | 150.00 $
 |  |  | Total après taxes |  | 2 507,00 $ | Torse
 |  |  |  |  |  | Batterie |  | 15.00 $ | 2 | 30.00 $
 |  |  |  |  |  | Ordinateur embarqué i.MX53 Quick Start Board |  | 150.00 $ | 2 | 300.00 $
 |  |  |  |  |  |  | Carte de contrôle
 |  |  |  |  |  |  | Microcontrôleur STM32F4 | 13.00 $ | 2 | 26.00 $
 |  |  |  |  |  |  | PCB | 40.00 $ | 2 | 80.00 $
 |  |  |  |  |  |  | Composants (résistances, condensateurs, etc.) | 5.00 $ | 2 | 10.00 $
 |  |  |  |  |  |  | Régulateur 5V | 20.00 $ | 2 | 40.00 $
 |  |  |  |  |  |  | Régulateur 3V | 2.00 $ | 2 | 4.00 $
 |  |  |  |  |  |  | Gyroscope/Accéléromètre | 20.00 $ | 2 | 20.00 $
 |  |  |  |  |  | Jambes
 |  |  |  |  |  | Servomoteur |  | 37.50 $ | 24 | 900.00 $
 |  |  |  |  |  | Fabrication des pièces |  | 388.00 $ | 2 | 776.00 $
 |  |  |  |  |  |  | Sous-total |  |  | 2386.00 $
 |  |  |  |  |  |  | Total après taxes |  |  | 2743.90 $
