wael-suleiman-UdeS/RobotFoot/PCB/Pièces/Commande.xlsx

Sheet: Feuil1
Liste de pièces Digikey
 | Digikey part number | Qty | Prix unitaire | Prix
USB | 609-4613-1-ND | 3 | 0.510 $ | 1.53 $
Condensateurs
15pf | 311-1101-1-ND | 25 | 0.049 $ | 1.23 $
100nf | 445-6957-1-ND | 100 | 0.063 $ | 6.33 $
10nf | 445-2280-1-ND | 30 | 0.122 $ | 3.66 $
10uf | 718-1118-1-ND | 20 | 0.550 $ | 11.00 $
100uf | PCE3898CT-ND | 9 | 0.700 $ | 6.30 $
2.2uF | 478-3105-1-ND | 3 | 1.120 $ | 3.36 $
470uF | 493-2181-1-ND | 3 | 0.680 $ | 2.04 $
1000uf | URS1V102MHD-ND | 3 | 0.880 $ | 2.64 $
Diode | SS3P3-M3/84AGICT-ND | 3 | 0.670 $ | 2.01 $
Diode | MBR1645-E3/45GI-ND | 6 | 0.990 $ | 5.94 $
Diode | MMBD914-FDICT-ND | 10 | 0.125 $ | 1.25 $
Résistances
10R | P10GCT-ND | 50 | 0.011 $ | 0.54 $
22R | P22GCT-ND | 50 | 0.011 $ | 0.54 $
100R | P100GCT-ND | 50 | 0.011 $ | 0.54 $
240R | P240GCT-ND | 50 | 0.011 $ | 0.54 $
390R | P390GCT-ND | 50 | 0.011 $ | 0.54 $
10K | P10KGCT-ND | 50 | 0.011 $ | 0.54 $
Potentiometre 1k | 3352W-102LF-ND | 6 | 1.63 $ | 9.78 $
Led | 350-2307-1-ND | 25 | 0.400 $ | 9.99 $
Crystal | CTX900-ND | 3 | 0.390 $ | 1.17 $
Fuseholder | F4546-ND | 3 | 1.400 $ | 4.20 $
LSM330DLC | 497-12400-1-ND | 3 | 7.500 $ | 22.50 $
 |  |  | Total | 98.17 $

Sheet: Feuil2
 |  | Scénario 1 |  |  | Scénario 2
 |  | 1 autre board |  |  | 2 autres boards
Pièce | Description | Qty | Prix unitaire @Qty | Prix | Qty | Prix unitaire @Qty | Prix
292132-4 | Con. moteur | 3 | 0.43 $ | 1.29 $ | 6 | 0.43 $ | 2.58 $
SS3P3-M3/84AGICT-ND | Diode 3A |  |  |  | 1 | 0.68 $ | 0.68 $
MBR1645-E3/45GI-ND | Diode 16A |  |  |  | 2 | 1.01 $ | 2.02 $
718-1118-1-ND | 10uF |  |  |  | 3 | 0.67 $ | 2.01 $
PCE3898CT-ND | 100uf |  |  |  | 3 | 0.72 $ | 2.16 $
478-3105-1-ND | 2.2uF | 1 | 1.15 $ | 1.15 $ | 3 | 1.15 $ | 3.45 $
URS1V102MHD-ND | 1000uf |  |  |  | 1 | 0.90 $ | 0.90 $
TOTAL |  |  |  | 2.44 $ |  |  | 13.80 $
