wael-suleiman-UdeS/RobotFoot/PCB/Pièces/Liste de pièces.xlsx

Sheet: Feuil1
Liste de pièces Digikey |  |  |  |  |  |  | Liste pièces au tech | Qty |  | Commandes special
 | Digikey part number | REAL QTY | Qty | Qty pour 5 | Prix unitaire | Prix | Batt header (trous pour cable) | 2 |  | Coil | 1
USB | 609-4613-1-ND | 5 | 1 | 5 | 0.510 $ | 2.55 $ |  |  |  | LM2576S-5.0 | 1
 |  |  |  |  |  |  | Jack audio | 1 | (mode-elec | STM32F407VG | 1
Condensateurs |  |  |  |  |  |  | MHDR1X4 | 4 |  | LM386N-1 | 1 | A COMMANDER
15pf | 311-1101-1-ND | 25 | 2 | 10 | 0.049 $ | 1.23 $ | MHDR1X6 | 1
100nf | 445-6957-1-ND | 100 | 8 | 40 | 0.063 $ | 6.33 $ | Power Jack | 1 | (mode-elec)
10nf | 445-2280-1-ND | 30 | 5 | 25 | 0.122 $ | 3.66 $ | Switch button | 4 | (mode-elec)
10uf | 718-1118-1-ND | 30 | 6 | 30 | 0.550 $ | 16.50 $ | Switch on/off | 1 | (mode-elec)
100uf | PCE3898CT-ND | 15 | 3 | 15 | 0.700 $ | 10.50 $ | Speaker | 1
2.2uF | 478-3105-1-ND | 5 | 1 | 5 | 1.120 $ | 5.60 $
470uF | 493-2181-1-ND | 5 | 1 | 5 | 0.680 $ | 3.40 $
1000uf | URS1V102MHD-ND | 5 | 1 | 5 | 0.880 $ | 4.40 $ | LM317T | 1
Diode | SS3P3-M3/84AGICT-ND | 5 | 1 | 5 | 0.670 $ | 3.35 $
Diode | MBR1645-E3/45GI-ND | 10 | 2 | 10 | 0.875 $ | 8.75 $
Diode | MMBD914-FDICT-ND | 10 | 2 | 10 | 0.125 $ | 1.25 $
Résistances
10 | P10GCT-ND | 50 |  | 0 | 0.011 $ | 0.54 $
22 | P22GCT-ND | 50 |  | 0 | 0.011 $ | 0.54 $
100 | P100GCT-ND | 50 |  | 0 | 0.011 $ | 0.54 $
240 | P240GCT-ND | 50 |  | 0 | 0.011 $ | 0.54 $
390 | P390GCT-ND | 50 |  | 0 | 0.011 $ | 0.54 $
10K | P10KGCT-ND | 50 |  | 0 | 0.011 $ | 0.54 $
Potentiometre 1k | 3352W-102LF-ND | 10 | 2 | 10 | 1.44 $ | 14.39 $
Led | 350-2307-1-ND | 30 | 6 | 30 | 0.400 $ | 11.99 $
Crystal | CTX900-ND | 5 | 1 | 5 | 0.390 $ | 1.95 $
Fuseholder+Fuse | F4546-ND | 5 | 1 | 5 | 1.400 $ | 7.00 $
LSM330DLC | 497-12400-1-ND | 5 | 1 | 5 | 7.500 $ | 37.50 $
Connecteur moteur | 292132-4 |  | 3
 |  |  |  |  | Total | 143.59 $

Sheet: Feuil2
Liste de pièces Digikey (2)
 | Digikey part number | REAL QTY | Qty | Qty pour 3 | Prix unitaire | Prix
USB | 609-4613-1-ND | 3 | 1 | 3 | 0.510 $ | 1.53 $
Condensateurs
15pf | 311-1101-1-ND | 25 | 2 | 6 | 0.049 $ | 1.23 $
100nf | 445-6957-1-ND | 100 | 8 | 24 | 0.063 $ | 6.33 $
10nf | 445-2280-1-ND | 30 | 5 | 15 | 0.122 $ | 3.66 $
10uf | 718-1118-1-ND | 20 | 6 | 18 | 0.550 $ | 11.00 $
100uf | PCE3898CT-ND | 9 | 3 | 9 | 0.700 $ | 6.30 $
2.2uF | 478-3105-1-ND | 6 | 2 | 6 | 1.120 $ | 6.72 $
470uF | 493-2181-1-ND | 3 | 1 | 3 | 0.680 $ | 2.04 $
1000uf | URS1V102MHD-ND | 3 | 1 | 3 | 0.880 $ | 2.64 $
Diode | SS3P3-M3/84AGICT-ND | 3 | 1 | 3 | 0.670 $ | 2.01 $
Diode | MBR1645-E3/45GI-ND | 6 | 2 | 6 | 0.990 $ | 5.94 $
Diode | MMBD914-FDICT-ND | 10 | 2 | 6 | 0.125 $ | 1.25 $
Résistances
10 | P10GCT-ND | 50 |  | 0 | 0.011 $ | 0.54 $
22 | P22GCT-ND | 50 |  | 0 | 0.011 $ | 0.54 $
100 | P100GCT-ND | 50 |  | 0 | 0.011 $ | 0.54 $
240 | P240GCT-ND | 50 |  | 0 | 0.011 $ | 0.54 $
390 | P390GCT-ND | 50 |  | 0 | 0.011 $ | 0.54 $
10K | P10KGCT-ND | 50 |  | 0 | 0.011 $ | 0.54 $
Potentiometre 1k | 3352W-102LF-ND | 6 | 2 | 6 | 1.63 $ | 9.78 $
Led | 350-2307-1-ND | 25 | 6 | 18 | 0.400 $ | 9.99 $
Crystal | CTX900-ND | 3 | 1 | 3 | 0.390 $ | 1.17 $
Fuseholder+Fuse | F4546-ND | 3 | 1 | 3 | 1.400 $ | 4.20 $
LSM330DLC | 497-12400-1-ND | 3 | 1 | 3 | 7.500 $ | 22.50 $
 |  |  |  |  | Total | 101.53 $
 | := quantité exacte (ou presque)
