wael-suleiman-UdeS/RobotFoot/solidworks/AssemblageComplet.SLDASM

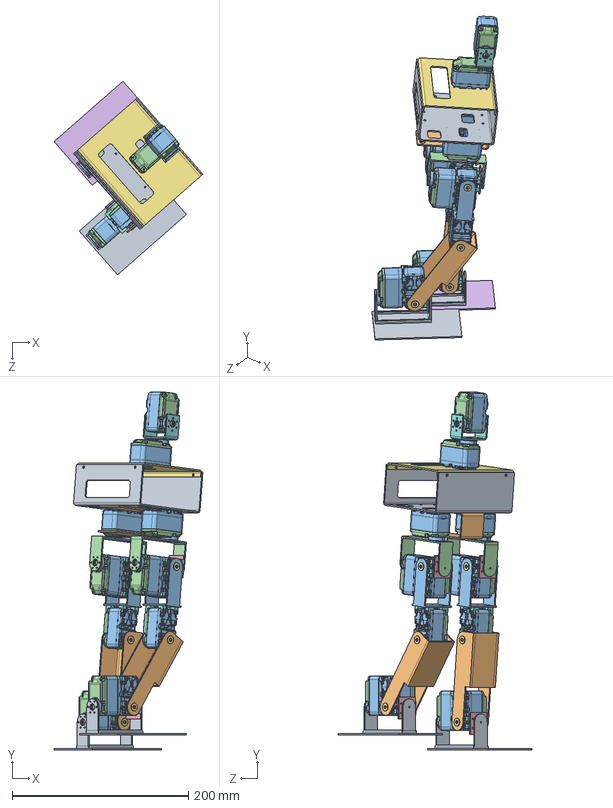
[picture p142: CAD file, 2013-12-12]
solidworks/AssemblageComplet.SLDASM
169.0 x 406.6 x 219.9 mm
Chest_Middle x 2
Chest_Lower
Document x 14
(#31287) TOP_191 x 14
(#129725) KSB1023A_M2_5X8Z x 14
(#112458) KSB1023A_T2X25NI x 56
Chest_Upper
Head_Neck
Leg_Foot x 2
Leg_Tibia x 2
Leg_Femur x 2
Leg_Hanche x 2
Leg_BeringAttach x 4
Leg_LeftFoot
Bering x 10
equerre x 40
Leg_RightFoot
