wael-suleiman-UdeS/RobotFoot/solidworks/Chest/Assemblage_Chest.SLDASM

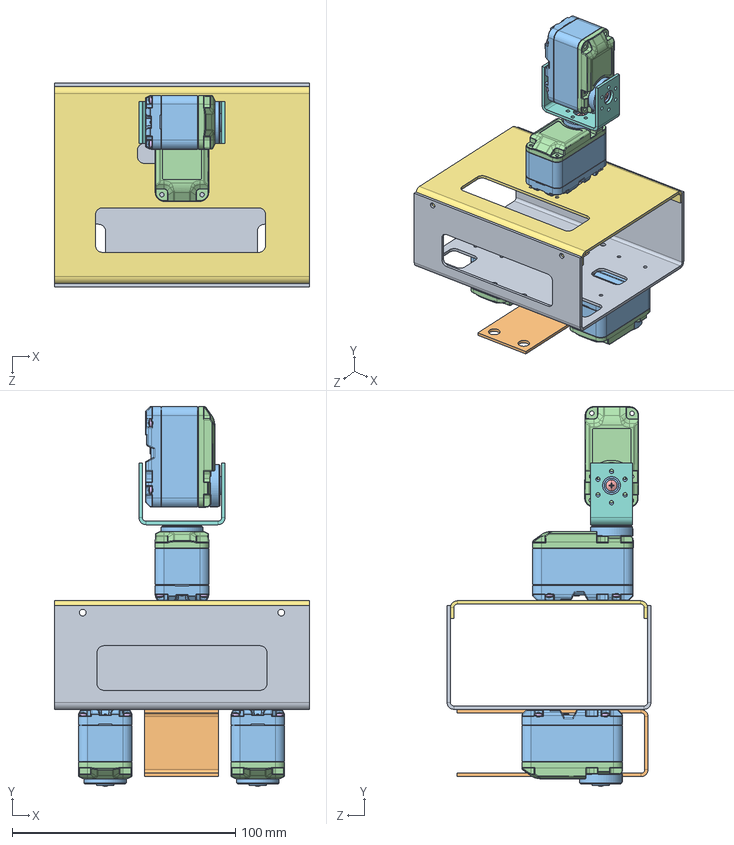
[picture p143: CAD file, 2013-12-12]
solidworks/Chest/Assemblage_Chest.SLDASM
114.3 x 170.2 x 91.3 mm
Chest_Middle x 2
Chest_Lower
Document x 4
(#31287) TOP_191 x 4
(#129725) KSB1023A_M2_5X8Z x 4
(#112458) KSB1023A_T2X25NI x 16
Chest_Upper
Head_Neck
