wael-suleiman-UdeS/RobotFoot/solidworks/servomoteur/ServoParfait.SLDASM

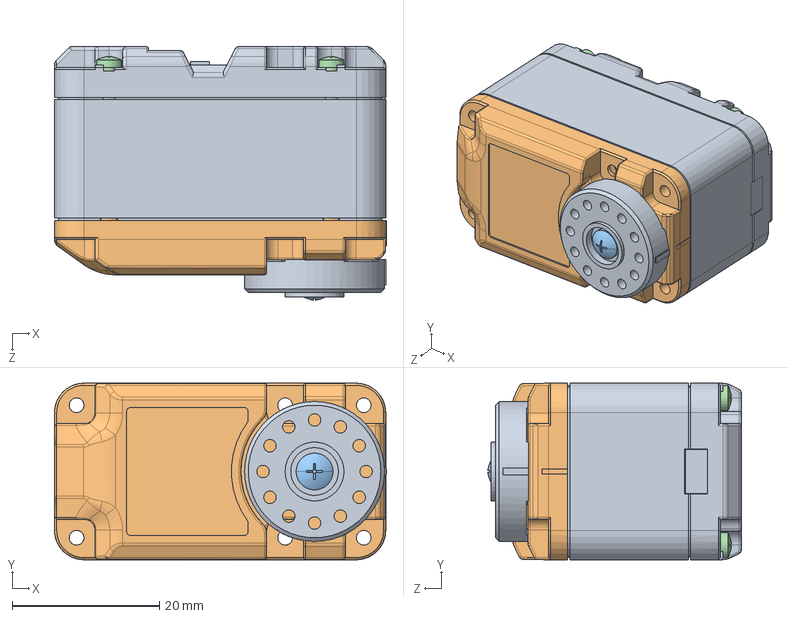
[picture p145: CAD file, 2013-12-12]
solidworks/servomoteur/ServoParfait.SLDASM
45.1 x 24.0 x 34.5 mm
Document
(#31287) TOP_191
(#129725) KSB1023A_M2_5X8Z
(#112458) KSB1023A_T2X25NI x 4
