wael-suleiman-UdeS/RobotFoot/doc/Documentation et reference/Darwin/DARwIn OP Part Files/OP 2D CAD Files/2D STEP/4_PR13_B01_FRM_PCB_MAIN_T.step

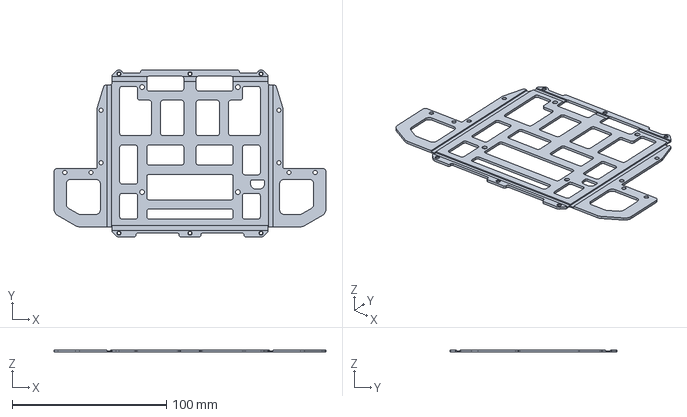
[picture p146: CAD file, 2013-12-12]
doc/Documentation et reference/Darwin/DARwIn OP Part Files/OP 2D CAD Files/2D STEP/4_PR13_B01_FRM_PCB_MAIN_T.step
176.1 x 108.1 x 1.50 mm
