wael-suleiman-UdeS/RobotFoot/solidworks/Jambes/AssemblageJambeDroite.SLDASM

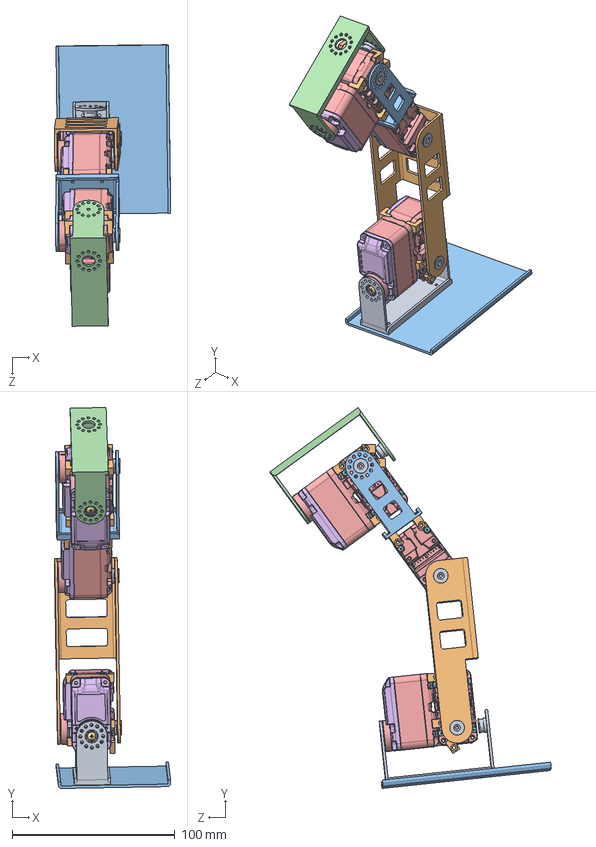
[picture p147: CAD file, 2013-12-12]
solidworks/Jambes/AssemblageJambeDroite.SLDASM
71.6 x 234.3 x 173.2 mm
Leg_Foot
Leg_Tibia
Leg_Femur
Leg_Hanche
Document x 5
(#31287) TOP_191 x 5
(#129725) KSB1023A_M2_5X8Z x 5
(#112458) KSB1023A_T2X25NI x 20
Bering x 5
equerre x 20
Leg_RightFoot
