wael-suleiman-UdeS/RobotFoot/3D Models/servomoteur/Servomoteur.SLDASM

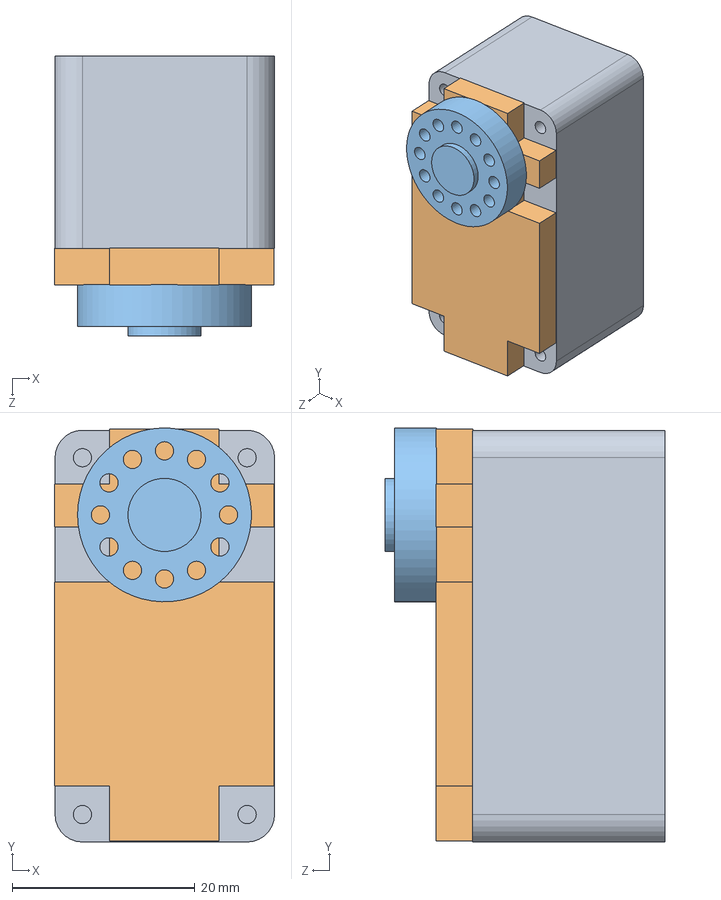
[picture p148: CAD file, 2013-02-07]
3D Models/servomoteur/Servomoteur.SLDASM
24.1 x 45.2 x 30.6 mm
boite
boite2
roue
