wael-suleiman-UdeS/RobotFoot/solidworks/Chest/Imprimante 3D/Assemblage_chest.SLDASM

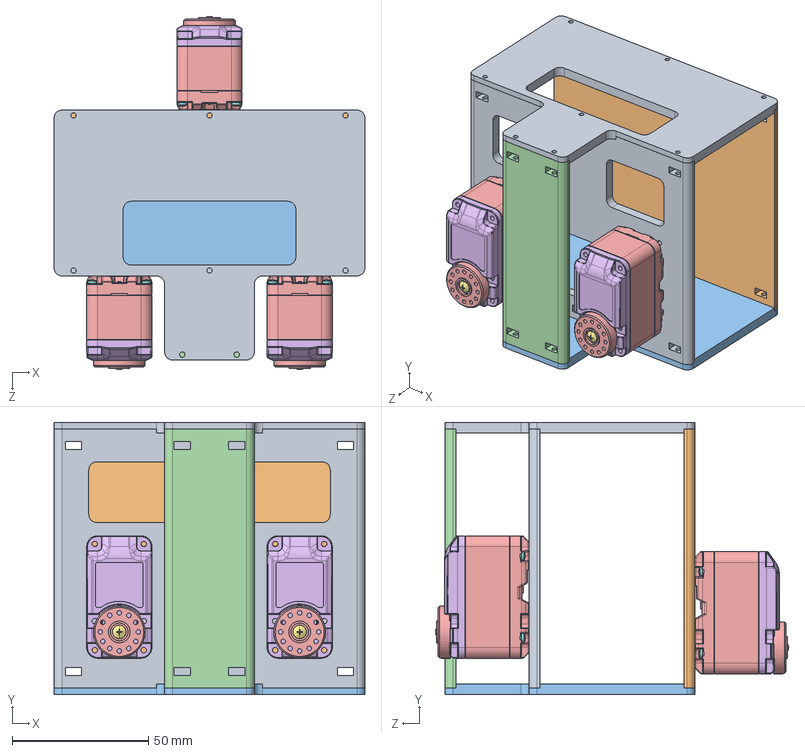
[picture p149: CAD file, 2013-12-12]
solidworks/Chest/Imprimante 3D/Assemblage_chest.SLDASM
114.3 x 100.1 x 129.9 mm
Chest_Back
Chest_Upper
Chest_Front
Chest_Lower
Document x 3
(#31287) TOP_191 x 3
(#129725) KSB1023A_M2_5X8Z x 3
(#112458) KSB1023A_T2X25NI x 12
Chest_Middle
