wael-suleiman-UdeS/RobotFoot/doc/Documentation et reference/Darwin/DARwIn OP Part Files/OP 3D CAD Files/3D STEP/5_PR13_B01_FRM_PCB_MAIN_B.step

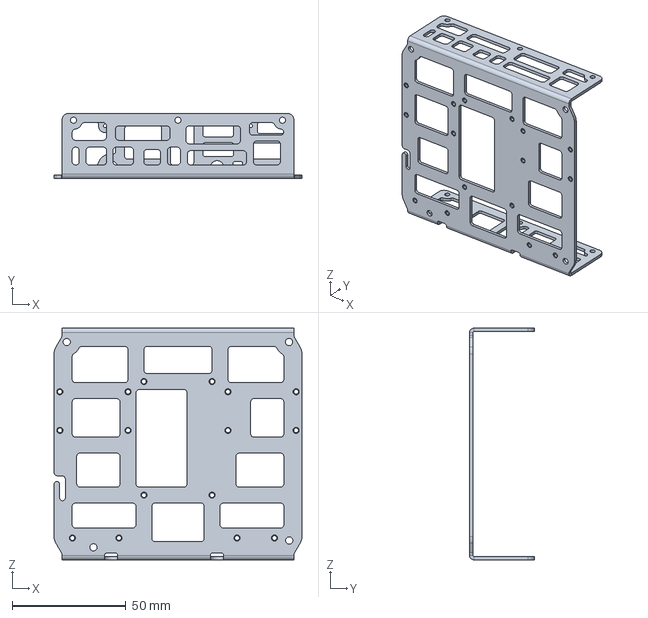
[picture p150: CAD file, 2013-12-12]
doc/Documentation et reference/Darwin/DARwIn OP Part Files/OP 3D CAD Files/3D STEP/5_PR13_B01_FRM_PCB_MAIN_B.step
109.2 x 28.7 x 102.0 mm
