wael-suleiman-UdeS/RobotFoot/doc/Documentation et reference/Darwin/DARwIn OP Part Files/OP 2D CAD Files/2D STEP/5_PR13_B01_FRM_PCB_MAIN_B.step

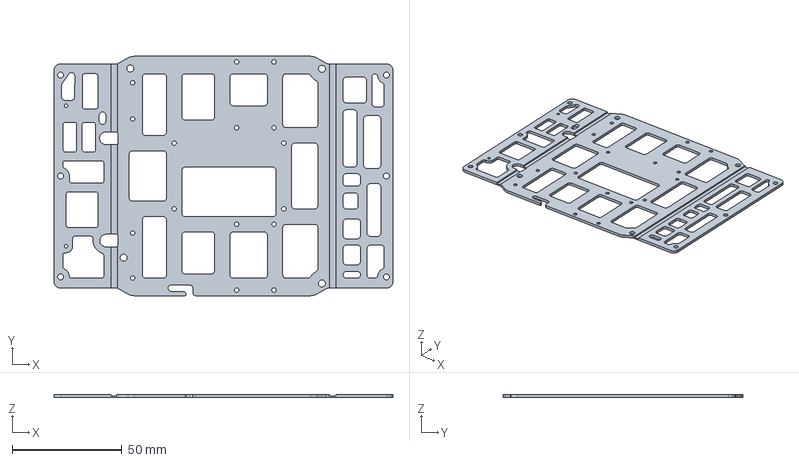
[picture p151: CAD file, 2013-12-12]
doc/Documentation et reference/Darwin/DARwIn OP Part Files/OP 2D CAD Files/2D STEP/5_PR13_B01_FRM_PCB_MAIN_B.step
154.5 x 109.2 x 1.50 mm
