wael-suleiman-UdeS/RobotFoot/doc/Documentation et reference/Darwin/DARwIn OP Part Files/OP 3D CAD Files/3D STEP/4_PR13_B01_FRM_PCB_MAIN_T.step

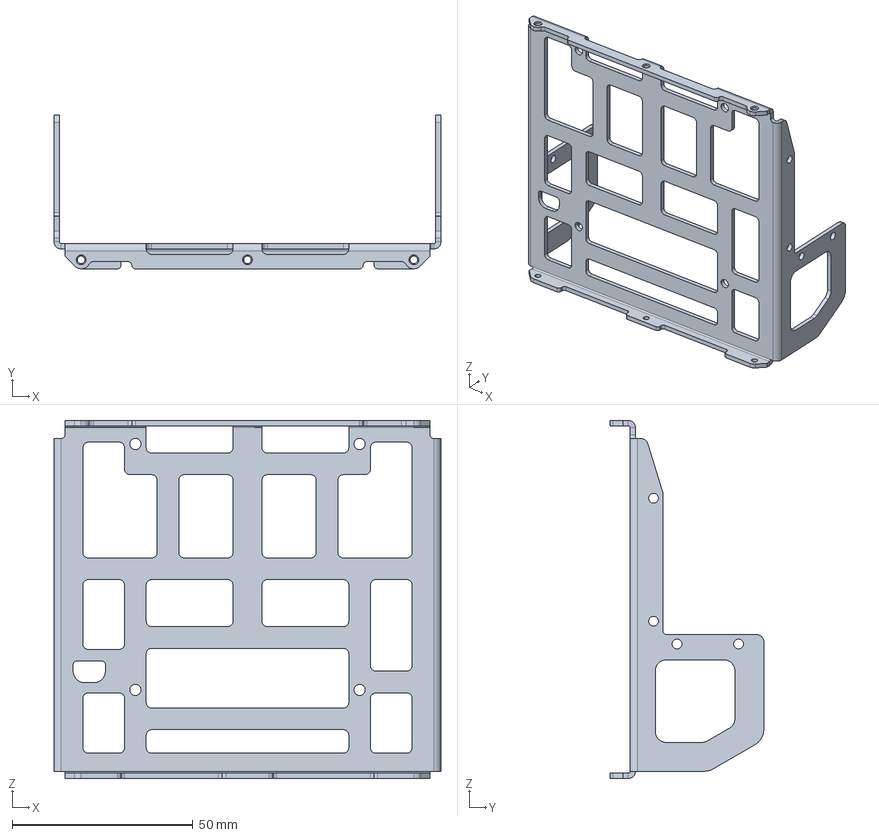
[picture p152: CAD file, 2013-12-12]
doc/Documentation et reference/Darwin/DARwIn OP Part Files/OP 3D CAD Files/3D STEP/4_PR13_B01_FRM_PCB_MAIN_T.step
107.0 x 42.5 x 99.0 mm
