wael-suleiman-UdeS/RobotFoot/3D Models/servomoteur/ServoBody2.SLDPRT

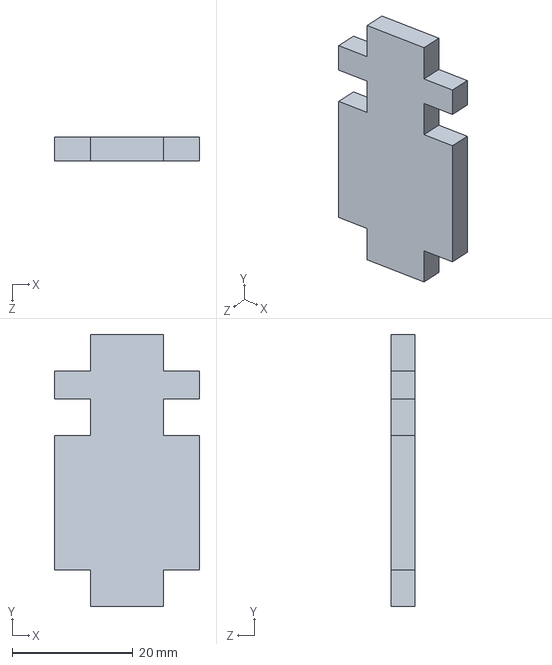
[picture p153: CAD file, 2013-02-07]
3D Models/servomoteur/ServoBody2.SLDPRT
24.0 x 45.0 x 4.00 mm
