wael-suleiman-UdeS/RobotFoot/doc/Documentation et reference/Bioloid-Solidworks/Main/CM-5.SLDPRT

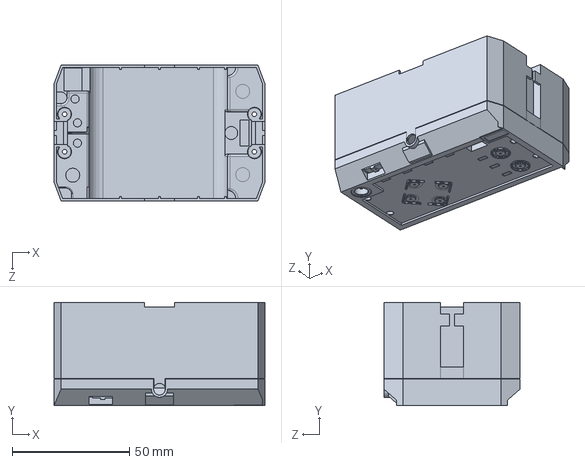
[picture p154: CAD file, 2013-12-12]
doc/Documentation et reference/Bioloid-Solidworks/Main/CM-5.SLDPRT
90.0 x 44.0 x 58.0 mm
