wael-suleiman-UdeS/RobotFoot/doc/Documentation et reference/Darwin/DARwIn OP Part Files/OP 2D CAD Files/2D PRT/14_FR07_S101.sldprt

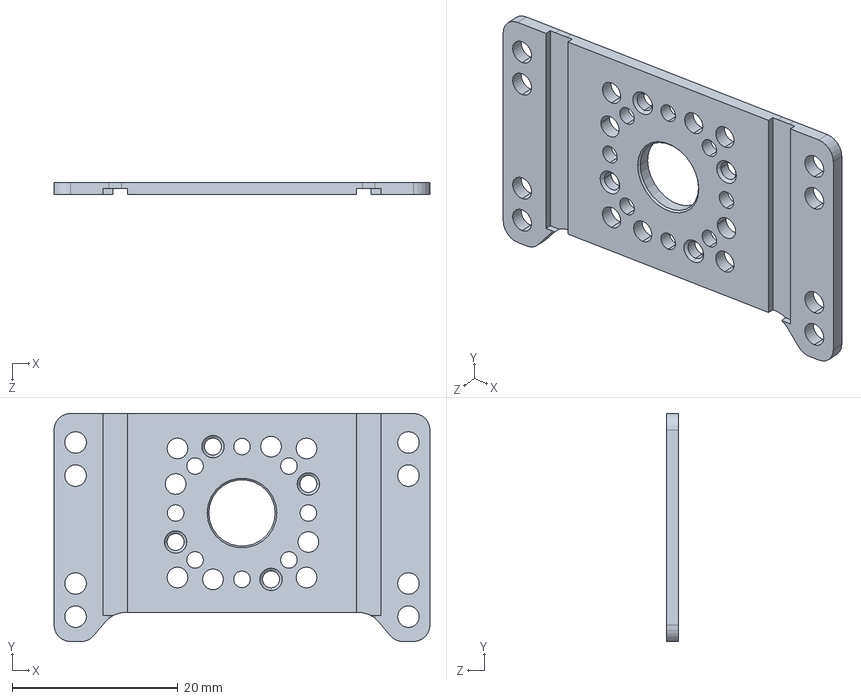
[picture p155: CAD file, 2013-12-12]
doc/Documentation et reference/Darwin/DARwIn OP Part Files/OP 2D CAD Files/2D PRT/14_FR07_S101.sldprt
45.3 x 27.5 x 1.50 mm
