wael-suleiman-UdeS/RobotFoot/doc/Documentation et reference/Darwin/DARwIn OP Part Files/OP 2D CAD Files/2D STEP/3_FR07_X101.step

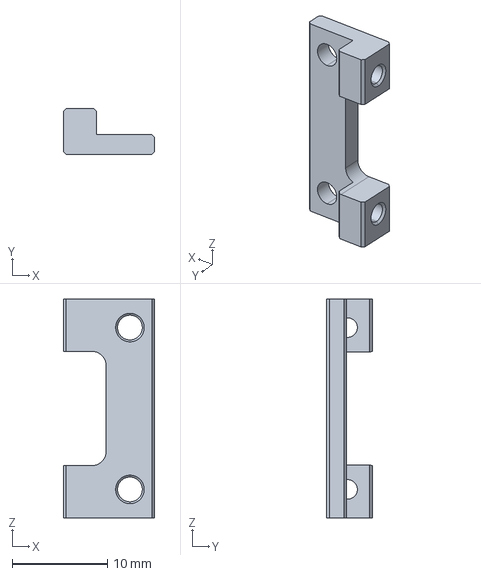
[picture p156: CAD file, 2013-12-12]
doc/Documentation et reference/Darwin/DARwIn OP Part Files/OP 2D CAD Files/2D STEP/3_FR07_X101.step
9.60 x 4.80 x 23.0 mm
