wael-suleiman-UdeS/RobotFoot/doc/Documentation et reference/Darwin/DARwIn OP Part Files/OP 3D CAD Files/3D PRT/Projet/STM32F4DISCOVERY.SLDPRT

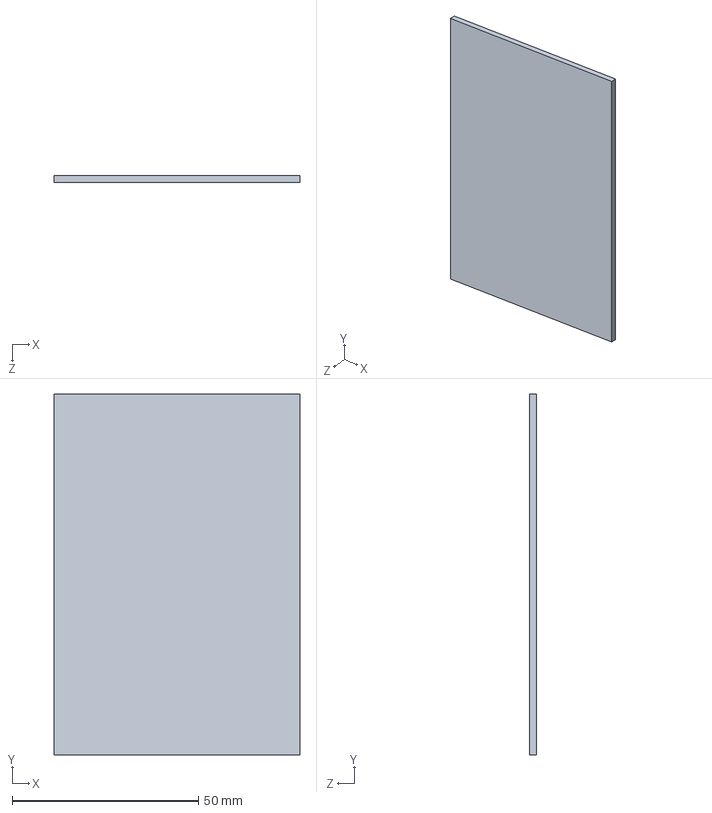
[picture p157: CAD file, 2013-12-12]
doc/Documentation et reference/Darwin/DARwIn OP Part Files/OP 3D CAD Files/3D PRT/Projet/STM32F4DISCOVERY.SLDPRT
66.0 x 97.0 x 2.00 mm
