wael-suleiman-UdeS/RobotFoot/doc/Documentation et reference/Darwin/DARwIn OP Part Files/OP 3D CAD Files/3D STEP/18_FR07_E160.step

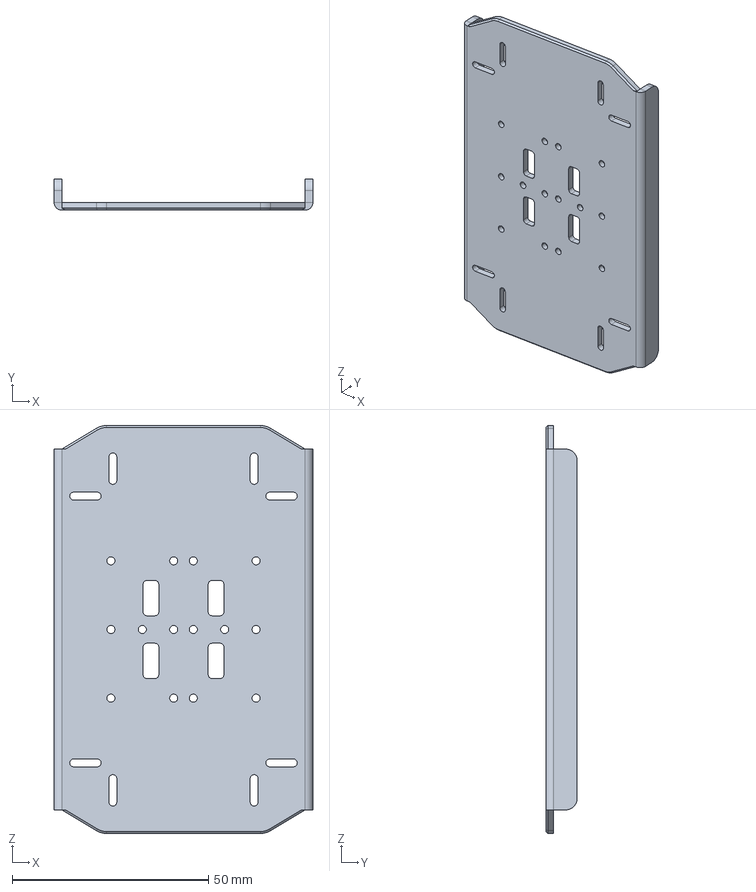
[picture p158: CAD file, 2013-12-12]
doc/Documentation et reference/Darwin/DARwIn OP Part Files/OP 3D CAD Files/3D STEP/18_FR07_E160.step
66.0 x 8.00 x 104.0 mm
