wael-suleiman-UdeS/RobotFoot/solidworks/Chest/dxf/Etat déplié - Chest_Upper.DXF

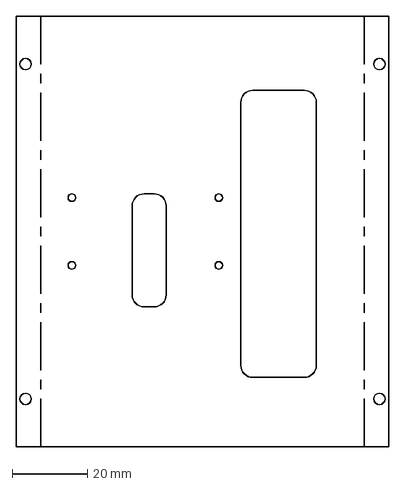
[picture p159: CAD file, 2013-12-12]
solidworks/Chest/dxf/Etat déplié - Chest_Upper.DXF
98.9 x 114.3 mm
