wael-suleiman-UdeS/RobotFoot/solidworks/Chest/Imprimante 3D/Chest_Upper.SLDPRT

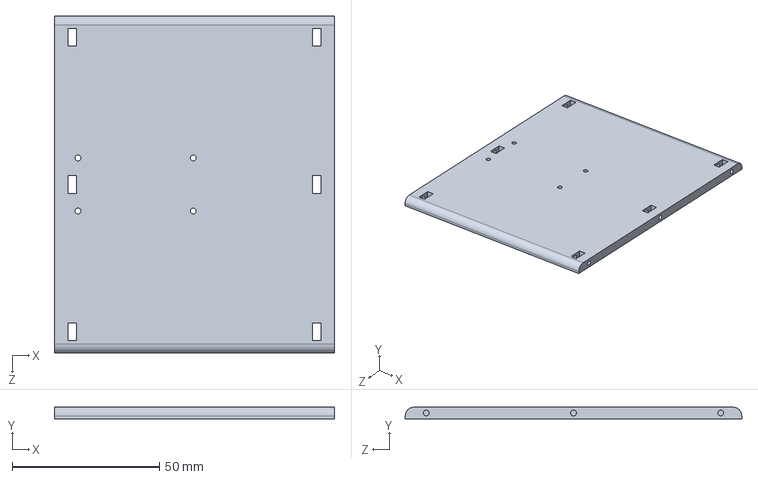
[picture p160: CAD file, 2013-12-12]
solidworks/Chest/Imprimante 3D/Chest_Upper.SLDPRT
95.1 x 4.00 x 114.3 mm
