wael-suleiman-UdeS/RobotFoot/solidworks/Chest/STEP/Chest_Upper.STEP

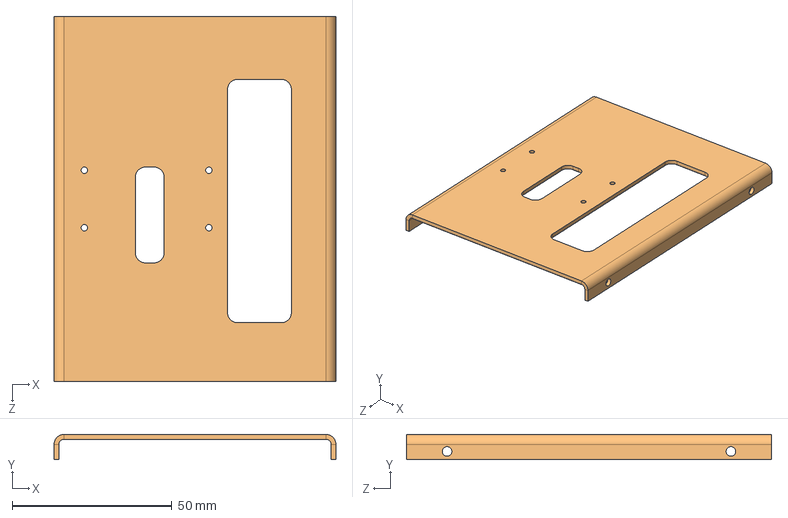
[picture p161: CAD file, 2013-12-12]
solidworks/Chest/STEP/Chest_Upper.STEP
88.3 x 7.87 x 114.3 mm
