wael-suleiman-UdeS/RobotFoot/solidworks/Chest/Tolerie/STEP/Chest_Lower.STEP

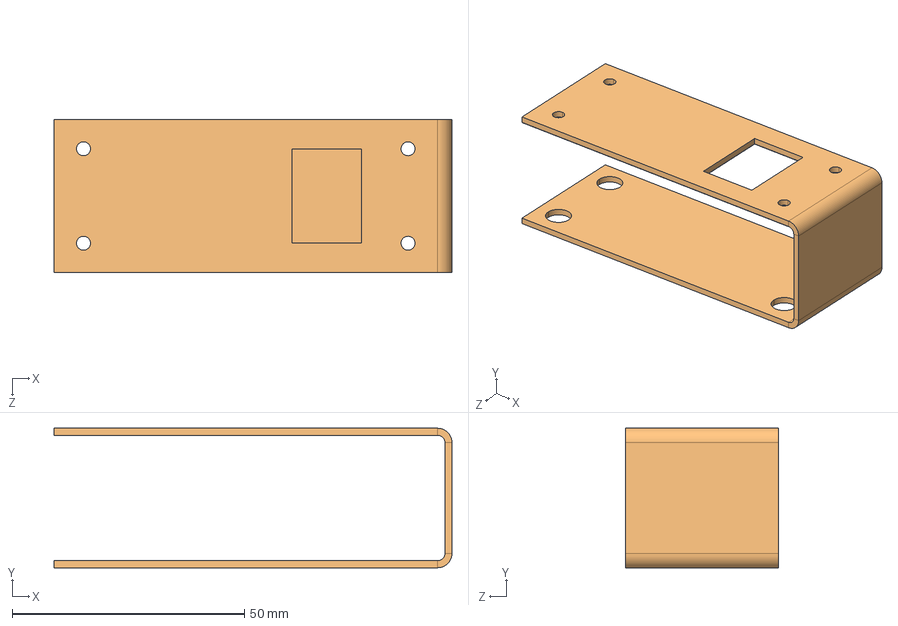
[picture p162: CAD file, 2013-12-12]
solidworks/Chest/Tolerie/STEP/Chest_Lower.STEP
85.7 x 30.0 x 33.0 mm
