wael-suleiman-UdeS/RobotFoot/solidworks/Exports/CBR Laser Soumission/Head_Neck.STEP

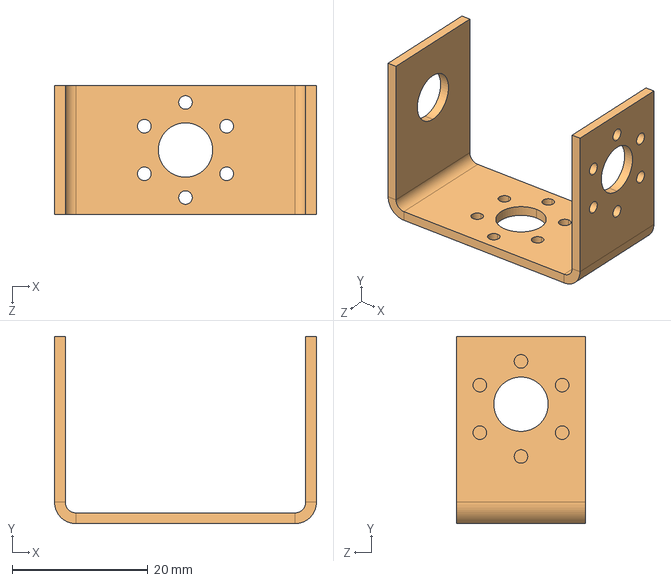
[picture p163: CAD file, 2013-12-12]
solidworks/Exports/CBR Laser Soumission/Head_Neck.STEP
38.6 x 27.6 x 19.0 mm
