wael-suleiman-UdeS/RobotFoot/solidworks/Exports/Plans/STEP export/Leg_Femur.STEP

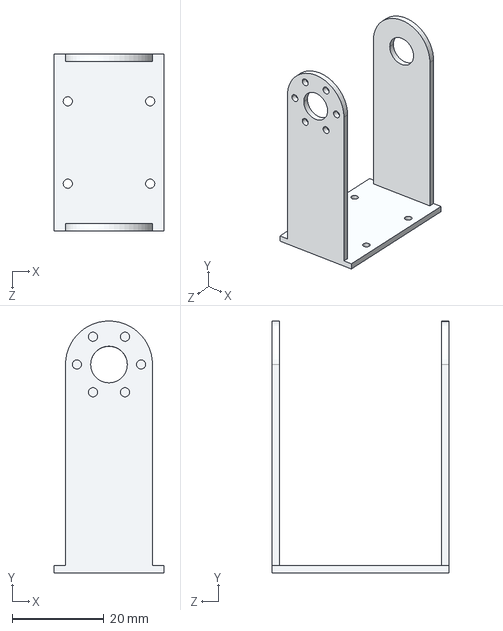
[picture p164: CAD file, 2013-12-12]
solidworks/Exports/Plans/STEP export/Leg_Femur.STEP
24.0 x 55.0 x 38.6 mm
