wael-suleiman-UdeS/RobotFoot/solidworks/Jambes/STL export/Bracket.STL

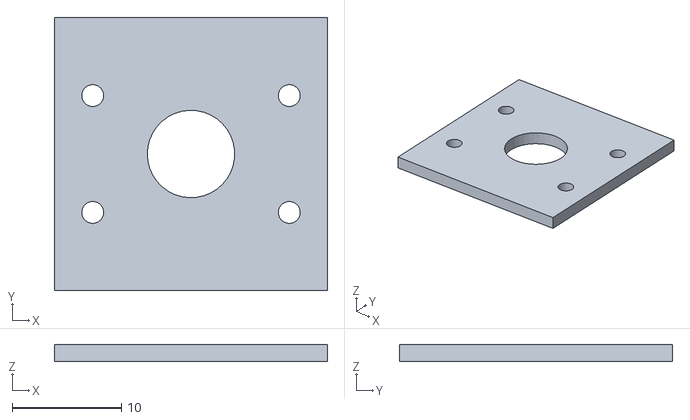
[picture p165: CAD file, 2013-12-12]
solidworks/Jambes/STL export/Bracket.STL
25.0 x 25.0 x 1.59
