wael-suleiman-UdeS/RobotFoot/3D Models/servomoteur/ServoHorn.SLDPRT

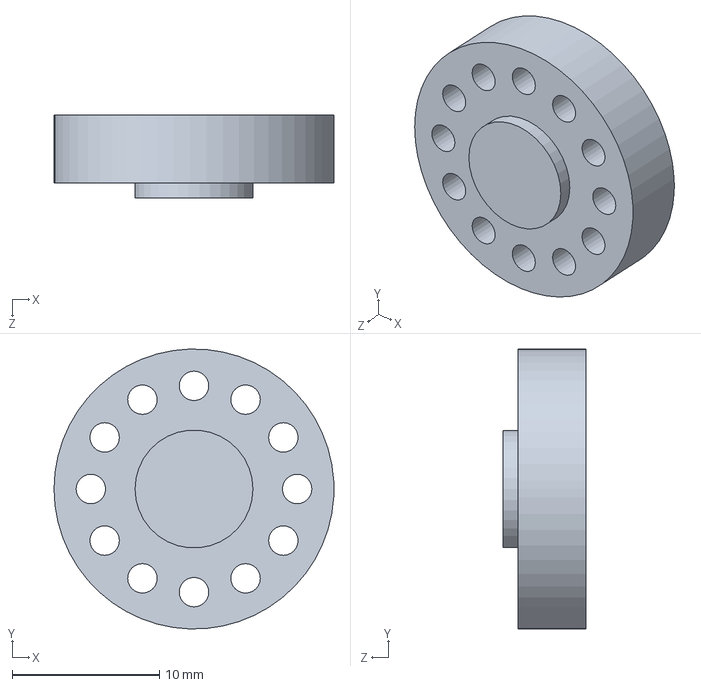
[picture p166: CAD file, 2013-02-07]
3D Models/servomoteur/ServoHorn.SLDPRT
19.0 x 19.0 x 5.60 mm
