wael-suleiman-UdeS/RobotFoot/solidworks/Chest/dxf/Etat déplié - Chest_Lower.DXF

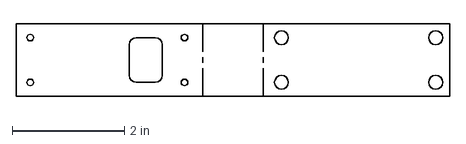
[picture p167: CAD file, 2013-12-12]
solidworks/Chest/dxf/Etat déplié - Chest_Lower.DXF
7.73 x 1.30 in
