wael-suleiman-UdeS/RobotFoot/solidworks/Chest/Imprimante 3D/Chest_Lower.SLDPRT

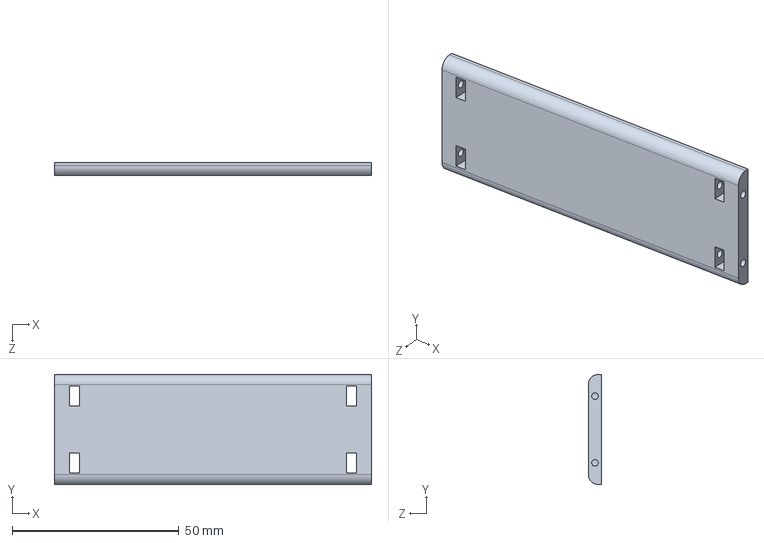
[picture p168: CAD file, 2013-12-12]
solidworks/Chest/Imprimante 3D/Chest_Lower.SLDPRT
95.1 x 33.0 x 4.00 mm
