wael-suleiman-UdeS/RobotFoot/solidworks/Chest/STEP/Chest_Middle.STEP

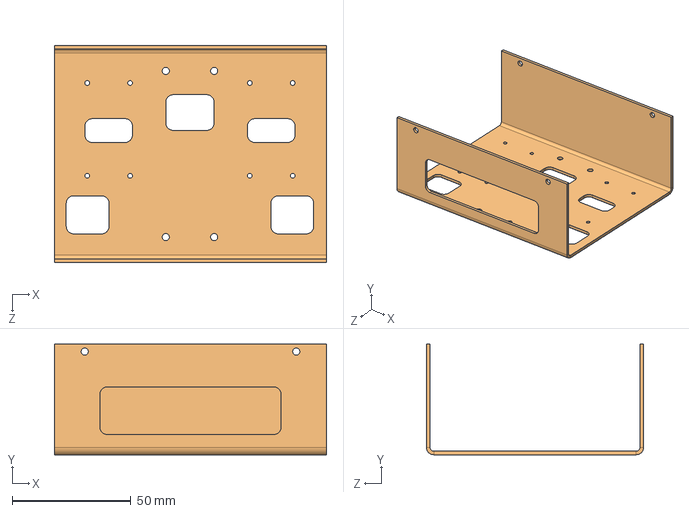
[picture p169: CAD file, 2013-12-12]
solidworks/Chest/STEP/Chest_Middle.STEP
114.3 x 46.6 x 91.3 mm
