wael-suleiman-UdeS/RobotFoot/solidworks/Exports/CBR Laser Soumission/Head_Upper.STEP

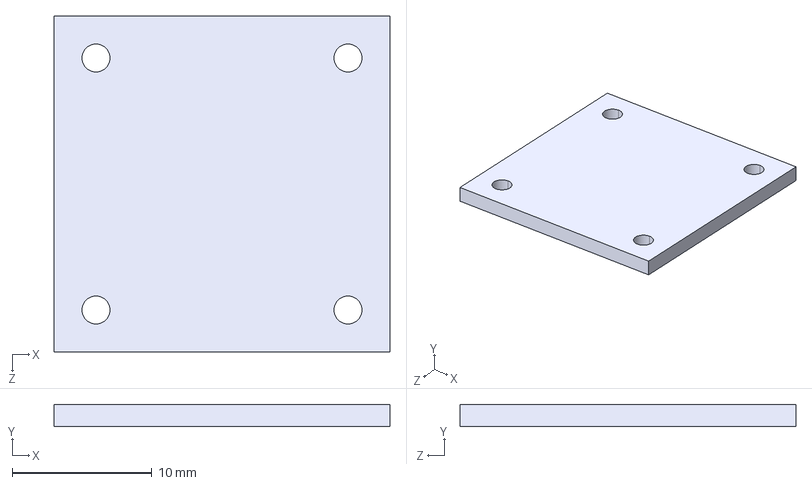
[picture p170: CAD file, 2013-12-12]
solidworks/Exports/CBR Laser Soumission/Head_Upper.STEP
24.0 x 1.59 x 24.0 mm
