wael-suleiman-UdeS/RobotFoot/solidworks/Exports/STEP export/Leg_Foot.STEP

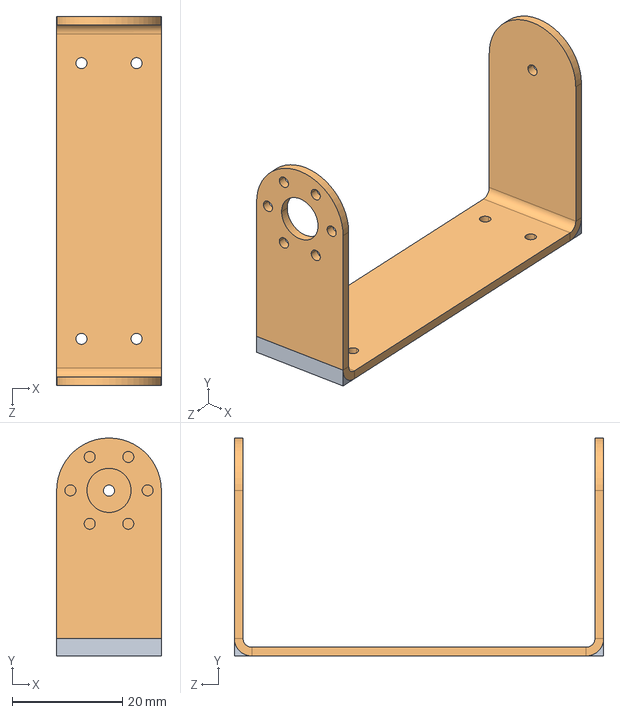
[picture p171: CAD file, 2013-12-12]
solidworks/Exports/STEP export/Leg_Foot.STEP
19.0 x 39.5 x 67.0 mm
