wael-suleiman-UdeS/RobotFoot/solidworks/Jambes/Bering.SLDPRT

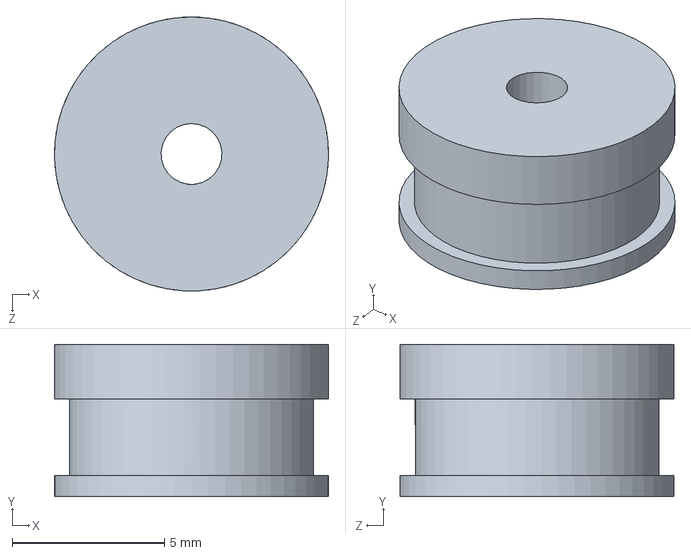
[picture p172: CAD file, 2013-12-12]
solidworks/Jambes/Bering.SLDPRT
9.00 x 5.00 x 9.00 mm
