wael-suleiman-UdeS/RobotFoot/solidworks/Jambes/STL export/BracketFoot.STL

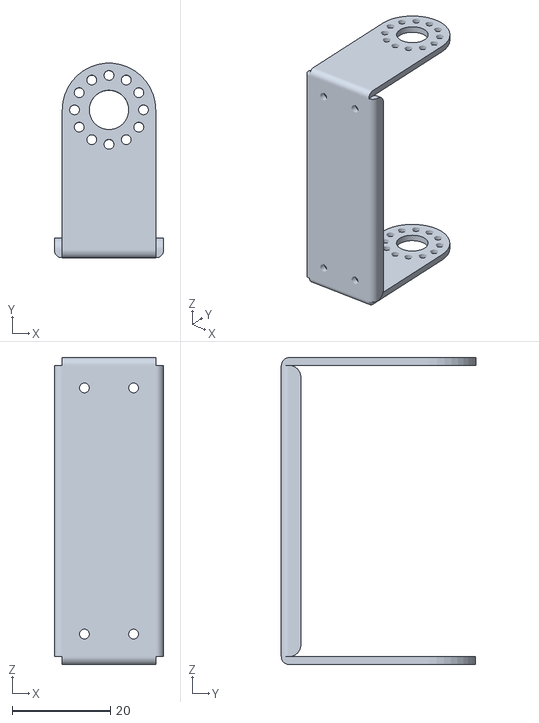
[picture p173: CAD file, 2013-12-12]
solidworks/Jambes/STL export/BracketFoot.STL
22.2 x 39.5 x 62.4
