wael-suleiman-UdeS/RobotFoot/solidworks/servomoteur/Document.sldprt

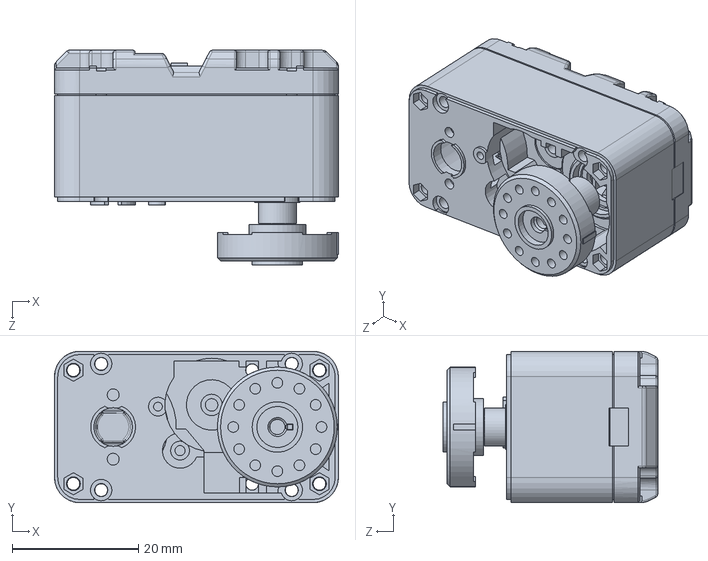
[picture p174: CAD file, 2013-12-12]
solidworks/servomoteur/Document.sldprt
45.0 x 24.0 x 34.0 mm
