wael-suleiman-UdeS/RobotFoot/3D Models/servomoteur/ServoBodyyy.SLDPRT

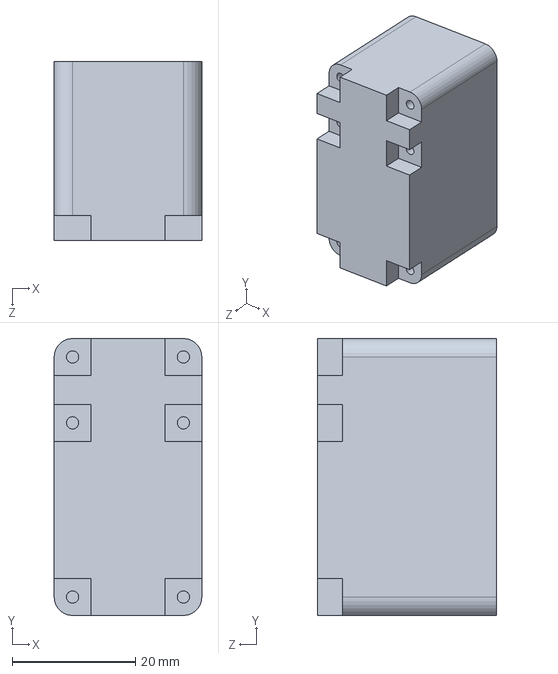
[picture p175: CAD file, 2013-02-07]
3D Models/servomoteur/ServoBodyyy.SLDPRT
24.0 x 45.0 x 29.0 mm
