wael-suleiman-UdeS/RobotFoot/doc/Documentation et reference/Darwin/DARwIn OP Part Files/OP 2D CAD Files/2D STEP/6_PR13_B_SPACER_PELV.step

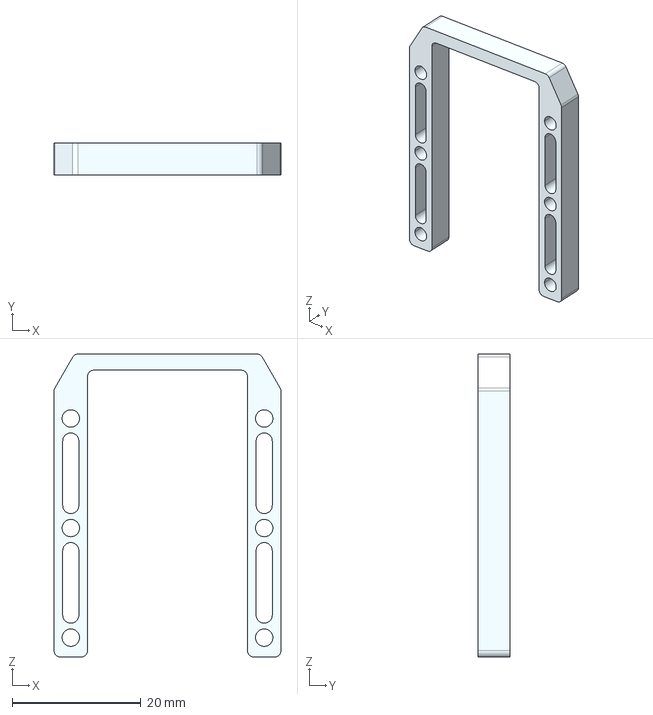
[picture p176: CAD file, 2013-12-12]
doc/Documentation et reference/Darwin/DARwIn OP Part Files/OP 2D CAD Files/2D STEP/6_PR13_B_SPACER_PELV.step
35.2 x 5.00 x 47.0 mm
