wael-suleiman-UdeS/RobotFoot/doc/Documentation et reference/Darwin/DARwIn OP Part Files/OP 3D CAD Files/3D STEP/13_FR07_H120.step

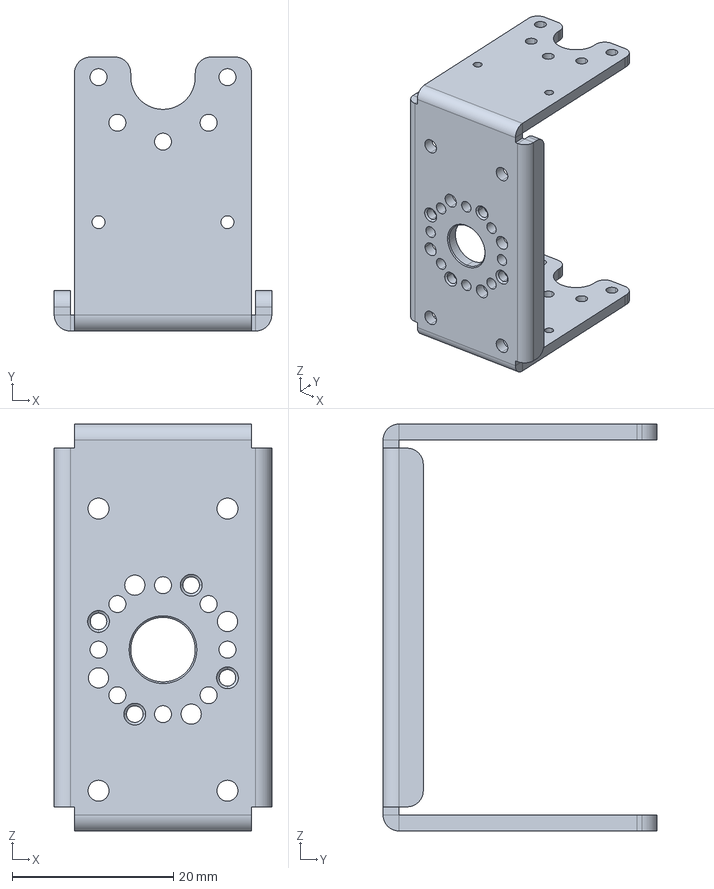
[picture p177: CAD file, 2013-12-12]
doc/Documentation et reference/Darwin/DARwIn OP Part Files/OP 3D CAD Files/3D STEP/13_FR07_H120.step
27.0 x 34.0 x 50.5 mm
