wael-suleiman-UdeS/RobotFoot/solidworks/Chest/dxf/Etat déplié - Chest_Middle.DXF

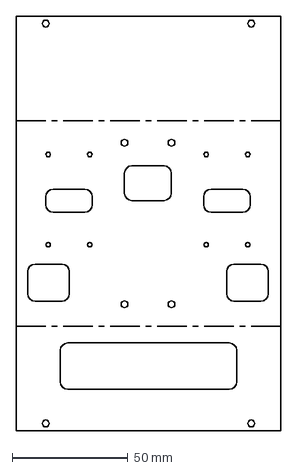
[picture p178: CAD file, 2013-12-12]
solidworks/Chest/dxf/Etat déplié - Chest_Middle.DXF
114.3 x 179.3 mm
