wael-suleiman-UdeS/RobotFoot/solidworks/Chest/Imprimante 3D/Chest_Back.SLDPRT

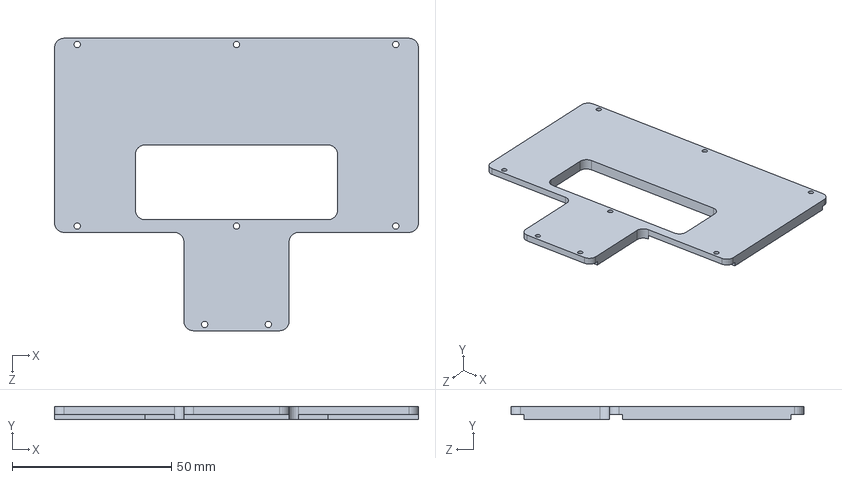
[picture p179: CAD file, 2013-12-12]
solidworks/Chest/Imprimante 3D/Chest_Back.SLDPRT
114.3 x 4.00 x 91.9 mm
