wael-suleiman-UdeS/RobotFoot/solidworks/Exports/Plans/STEP export/Chest_Upper.STEP

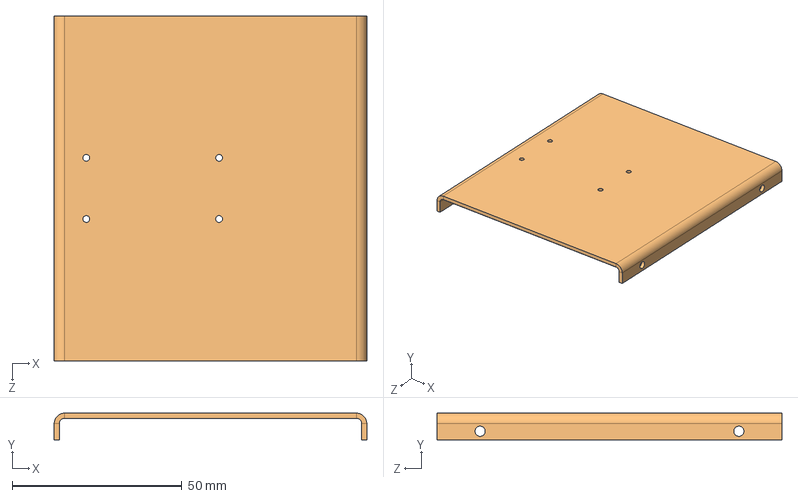
[picture p180: CAD file, 2013-12-12]
solidworks/Exports/Plans/STEP export/Chest_Upper.STEP
92.1 x 7.87 x 101.6 mm
