wael-suleiman-UdeS/RobotFoot/solidworks/Jambes/STL export/BracketFemur.STL

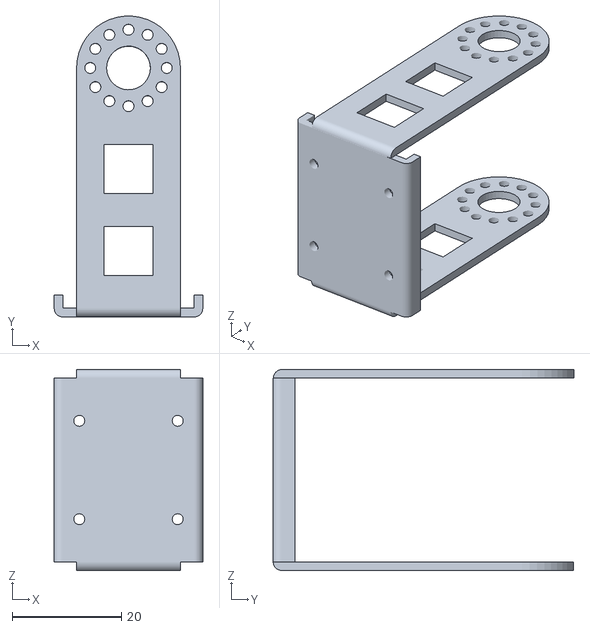
[picture p181: CAD file, 2013-12-12]
solidworks/Jambes/STL export/BracketFemur.STL
27.2 x 55.0 x 36.8
