wael-suleiman-UdeS/RobotFoot/3D Models/servomoteur/ServoBody.SLDPRT

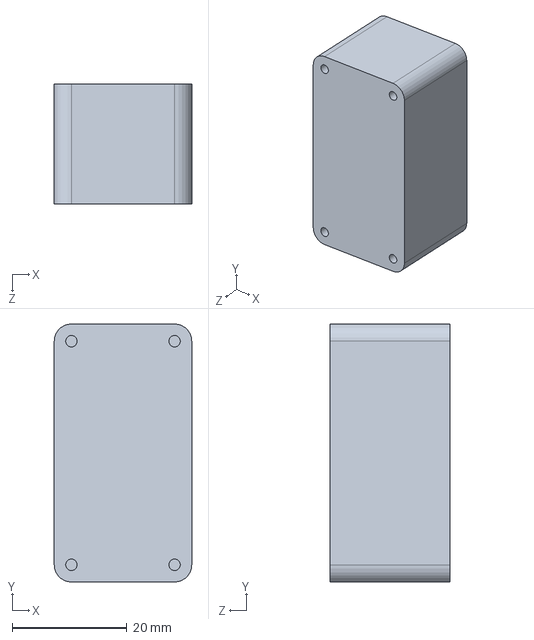
[picture p182: CAD file, 2013-02-07]
3D Models/servomoteur/ServoBody.SLDPRT
24.0 x 45.0 x 21.0 mm
