wael-suleiman-UdeS/RobotFoot/doc/Documentation et reference/Darwin/DARwIn OP Part Files/OP 2D CAD Files/2D STEP/13_FR07_H120.step

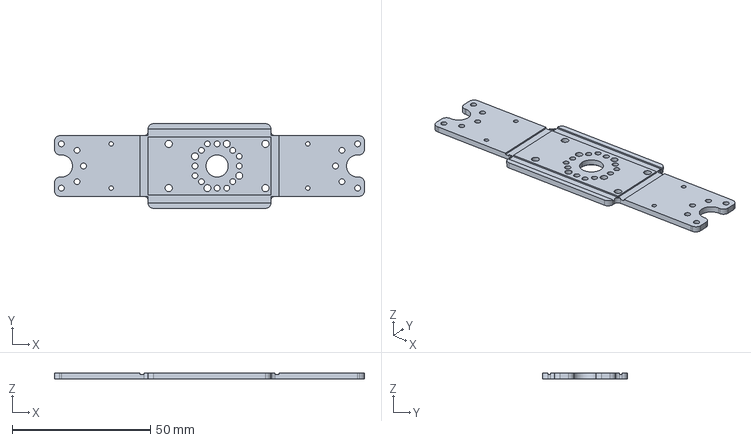
[picture p183: CAD file, 2013-12-12]
doc/Documentation et reference/Darwin/DARwIn OP Part Files/OP 2D CAD Files/2D STEP/13_FR07_H120.step
112.1 x 30.6 x 2.00 mm
