wael-suleiman-UdeS/RobotFoot/doc/Documentation et reference/Darwin/DARwIn OP Part Files/OP 3D CAD Files/3D STEP/14_FR07_S101.step

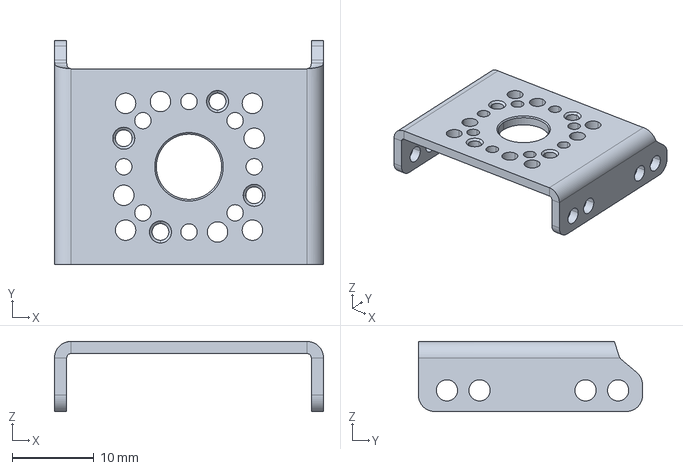
[picture p184: CAD file, 2013-12-12]
doc/Documentation et reference/Darwin/DARwIn OP Part Files/OP 3D CAD Files/3D STEP/14_FR07_S101.step
33.0 x 27.5 x 8.60 mm
