wael-suleiman-UdeS/RobotFoot/solidworks/Chest/Imprimante 3D/Chest_Middle.SLDPRT

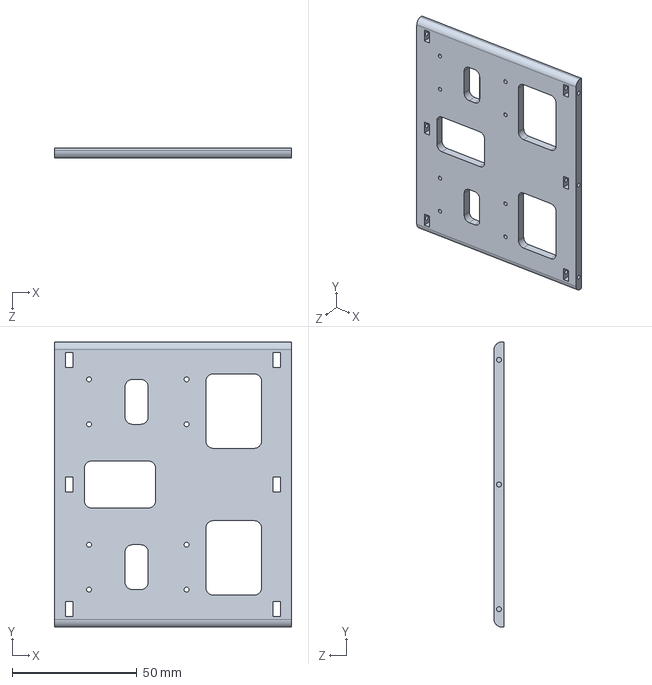
[picture p185: CAD file, 2013-12-12]
solidworks/Chest/Imprimante 3D/Chest_Middle.SLDPRT
95.1 x 114.3 x 4.00 mm
