wael-suleiman-UdeS/RobotFoot/solidworks/Jambes/equerre.SLDPRT

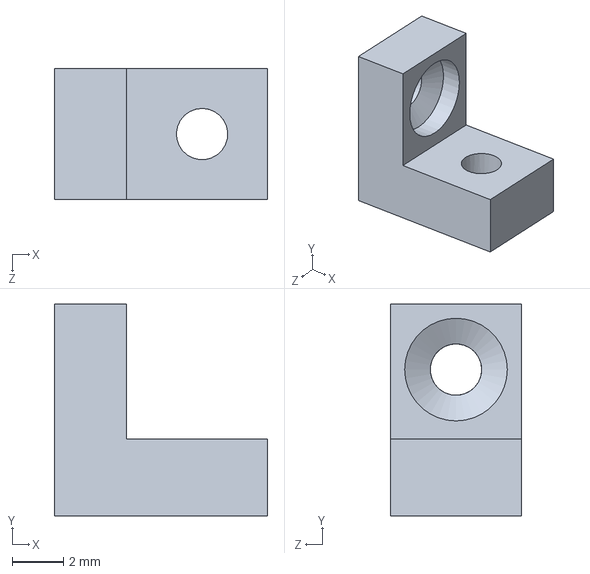
[picture p186: CAD file, 2013-12-12]
solidworks/Jambes/equerre.SLDPRT
8.30 x 8.25 x 5.10 mm
