wael-suleiman-UdeS/RobotFoot/doc/Documentation et reference/Darwin/DARwIn OP Part Files/OP 3D CAD Files/3D STEP/9R_PR13_B_BRKT_PELV_R.step

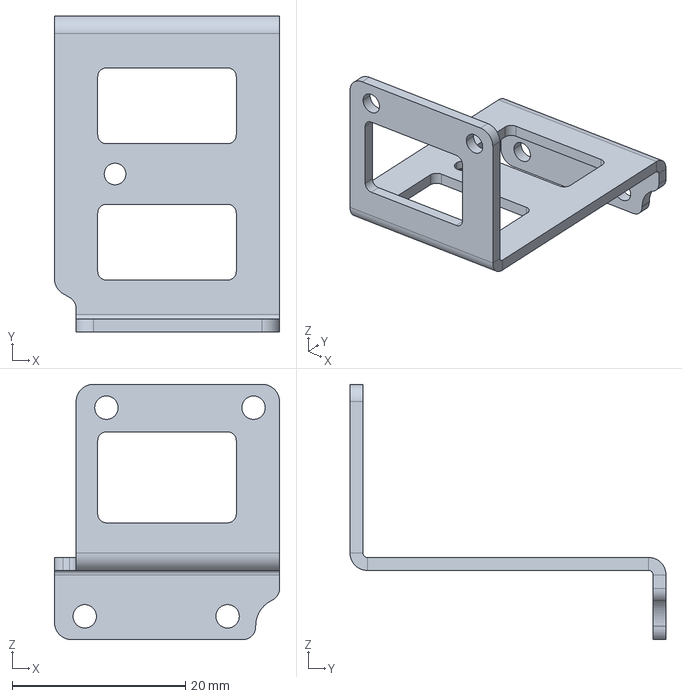
[picture p188: CAD file, 2013-12-12]
doc/Documentation et reference/Darwin/DARwIn OP Part Files/OP 3D CAD Files/3D STEP/9R_PR13_B_BRKT_PELV_R.step
26.0 x 36.5 x 29.5 mm
