wael-suleiman-UdeS/RobotFoot/solidworks/Chest/Imprimante 3D/Chest_Front.SLDPRT

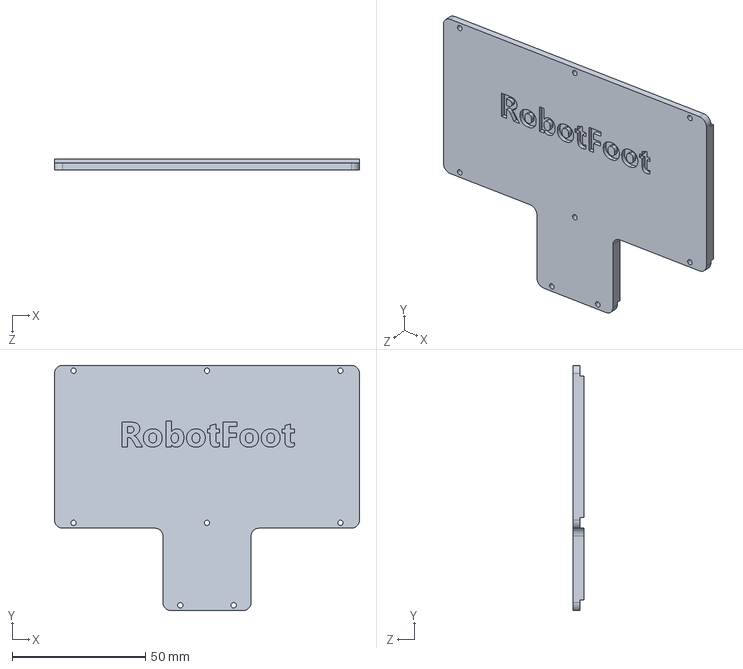
[picture p189: CAD file, 2013-12-12]
solidworks/Chest/Imprimante 3D/Chest_Front.SLDPRT
114.3 x 91.9 x 4.00 mm
