wael-suleiman-UdeS/RobotFoot/solidworks/Exports/Plans/STEP export/Leg_Tibia.STEP

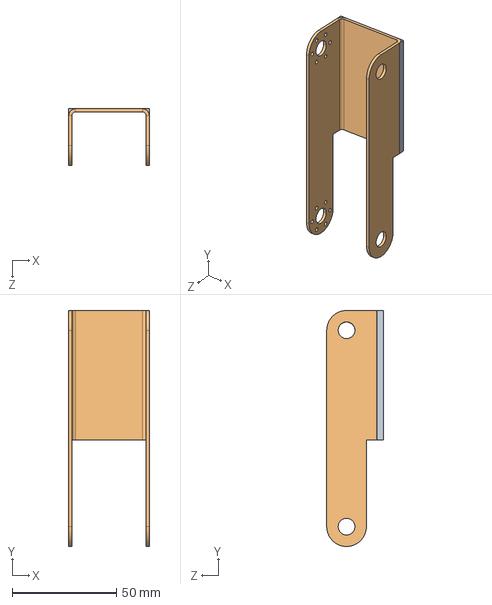
[picture p190: CAD file, 2013-12-12]
solidworks/Exports/Plans/STEP export/Leg_Tibia.STEP
38.6 x 113.0 x 27.1 mm
