wael-suleiman-UdeS/RobotFoot/solidworks/Exports/STEP export/Chest_Middle.STEP

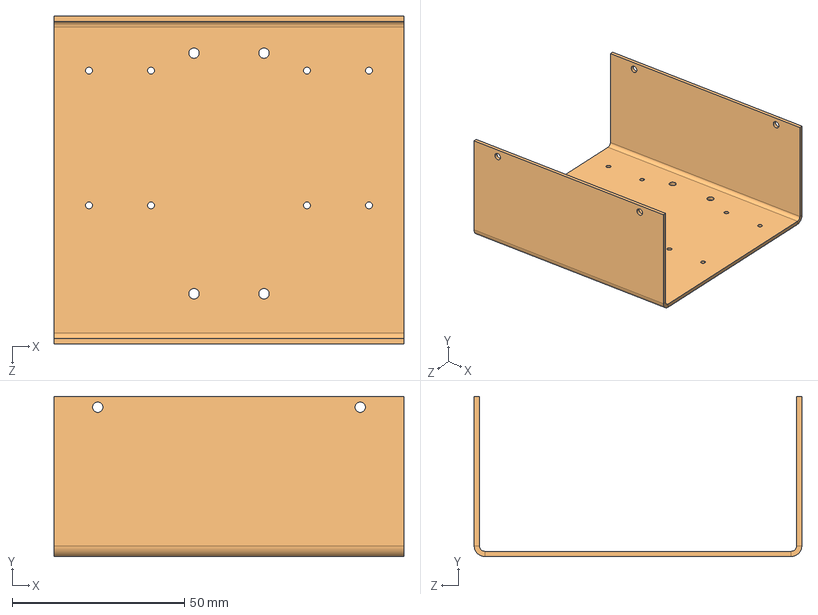
[picture p191: CAD file, 2013-12-12]
solidworks/Exports/STEP export/Chest_Middle.STEP
101.6 x 46.6 x 95.1 mm
