wael-suleiman-UdeS/RobotFoot/solidworks/Jambes/STL export/Knee.STL

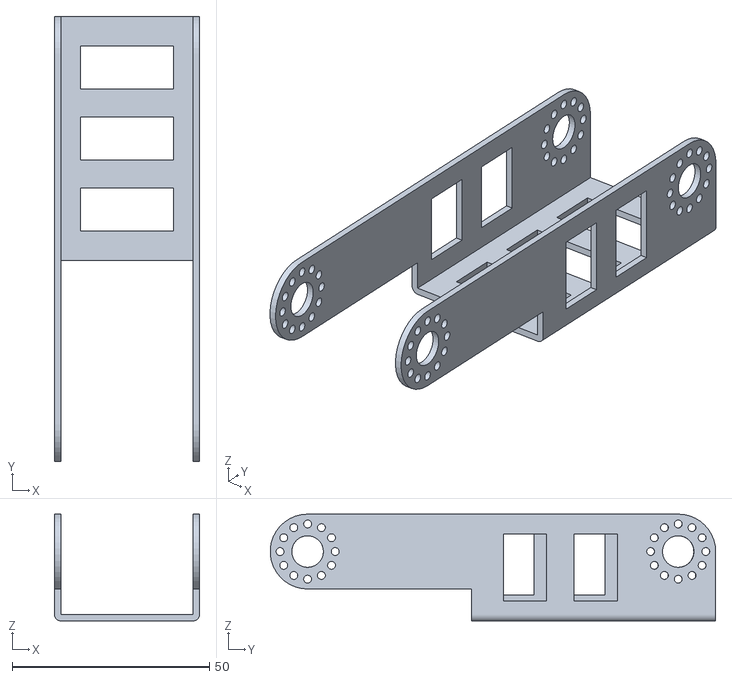
[picture p192: CAD file, 2013-12-12]
solidworks/Jambes/STL export/Knee.STL
36.8 x 113.0 x 27.1
