wael-suleiman-UdeS/RobotFoot/doc/Documentation et reference/Darwin/DARwIn OP Part Files/OP 2D CAD Files/2D STEP/9L_PR13_B_BRKT_PELV_L.step

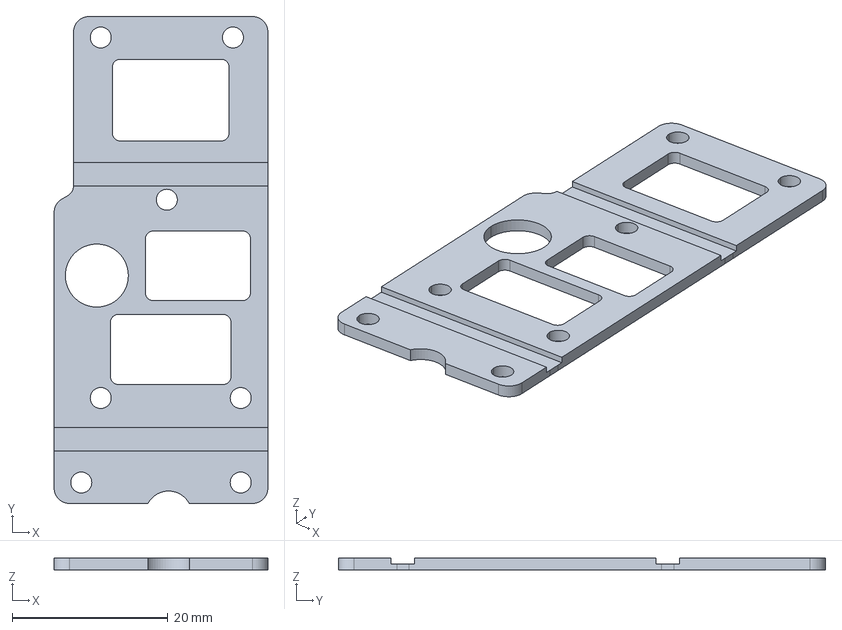
[picture p193: CAD file, 2013-12-12]
doc/Documentation et reference/Darwin/DARwIn OP Part Files/OP 2D CAD Files/2D STEP/9L_PR13_B_BRKT_PELV_L.step
27.5 x 62.6 x 1.50 mm
