wael-suleiman-UdeS/RobotFoot/solidworks/Exports/STEP export/Chest_Lower.STEP

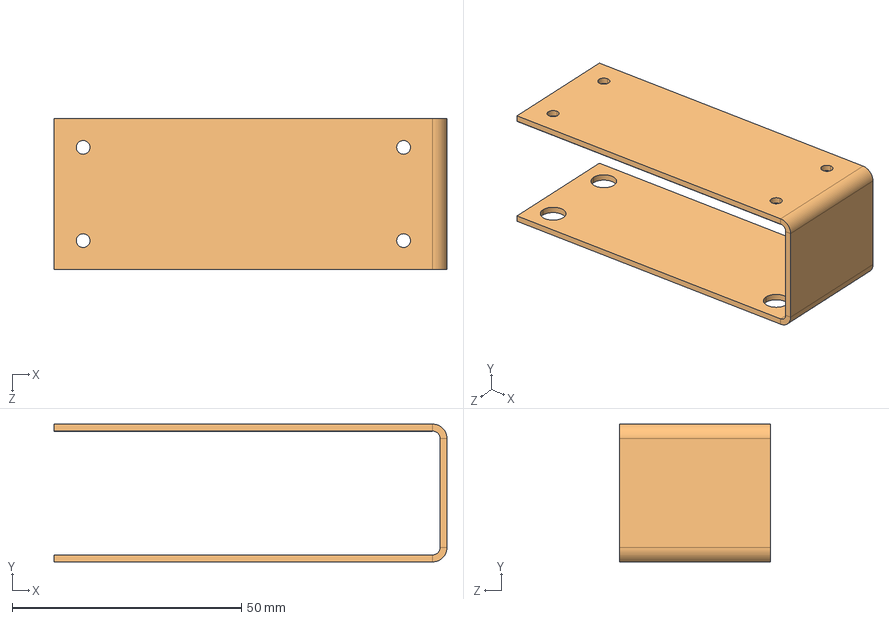
[picture p195: CAD file, 2013-12-12]
solidworks/Exports/STEP export/Chest_Lower.STEP
85.7 x 30.0 x 33.0 mm
