wael-suleiman-UdeS/RobotFoot/solidworks/Jambes/STL export/LeftFoot.STL

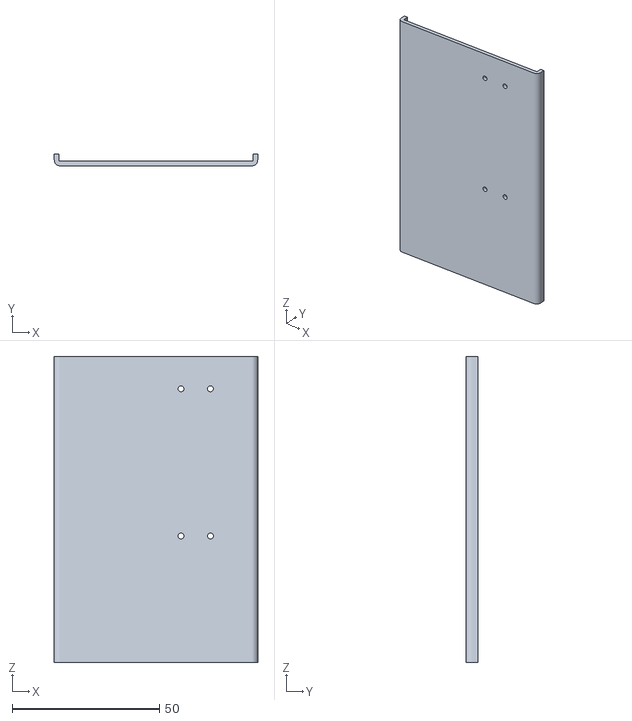
[picture p196: CAD file, 2013-12-12]
solidworks/Jambes/STL export/LeftFoot.STL
69.2 x 4.00 x 104.0
