wael-suleiman-UdeS/RobotFoot/doc/Documentation et reference/Darwin/DARwIn OP Part Files/OP 3D CAD Files/3D STEP/8_PR13_FRM_CVR_BAT.step

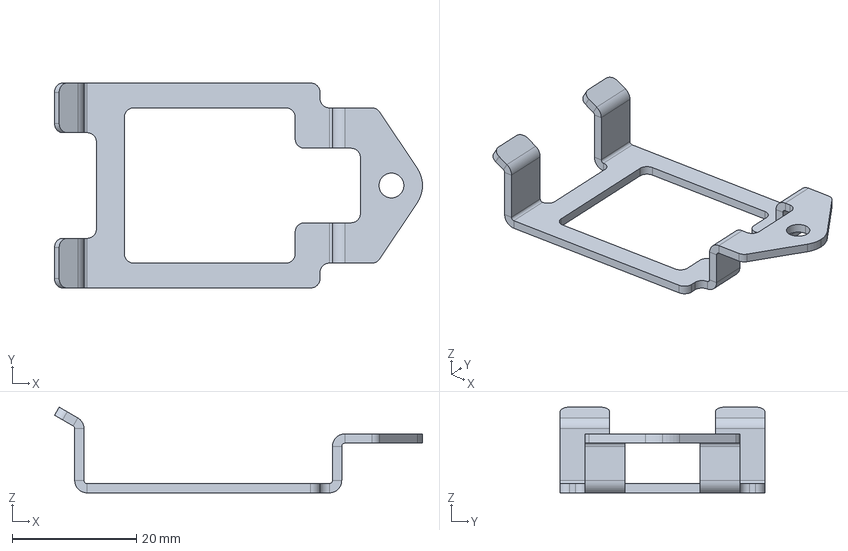
[picture p197: CAD file, 2013-12-12]
doc/Documentation et reference/Darwin/DARwIn OP Part Files/OP 3D CAD Files/3D STEP/8_PR13_FRM_CVR_BAT.step
59.2 x 33.0 x 13.8 mm
