wael-suleiman-UdeS/RobotFoot/solidworks/Exports/Plans/STEP export/Leg_LeftFoot.STEP

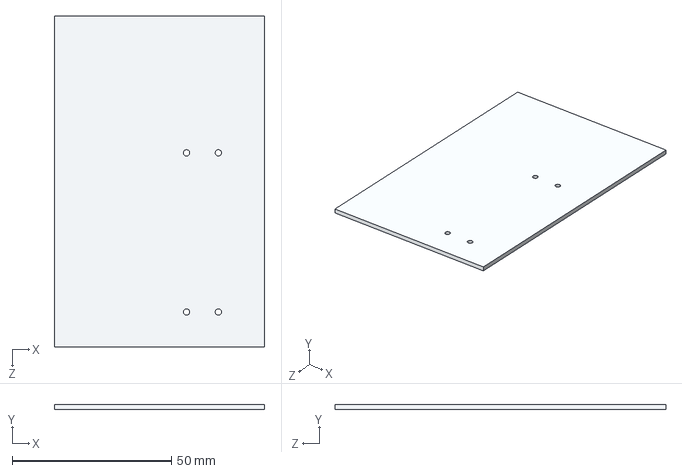
[picture p200: CAD file, 2013-12-12]
solidworks/Exports/Plans/STEP export/Leg_LeftFoot.STEP
66.0 x 1.59 x 104.0 mm
