wael-suleiman-UdeS/RobotFoot/doc/Documentation et reference/Darwin/DARwIn OP Part Files/OP 3D CAD Files/3D PRT/2_FR07_H104.sldprt

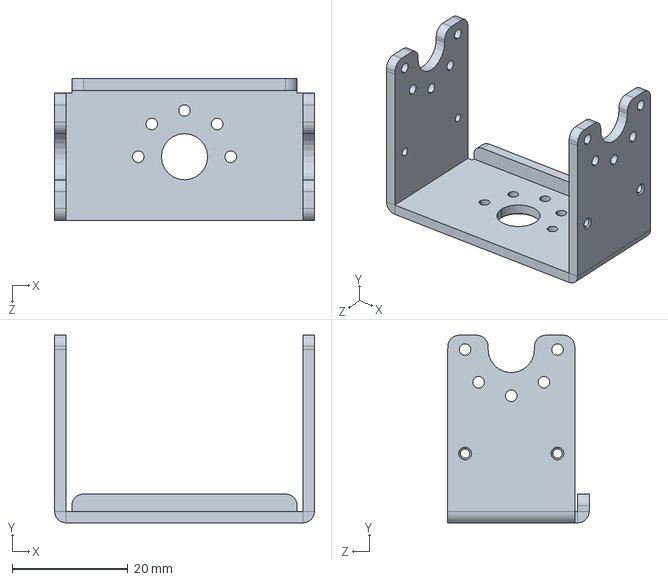
[picture p202: CAD file, 2013-12-12]
doc/Documentation et reference/Darwin/DARwIn OP Part Files/OP 3D CAD Files/3D PRT/2_FR07_H104.sldprt
45.0 x 32.5 x 24.5 mm
