wael-suleiman-UdeS/RobotFoot/doc/Documentation et reference/Darwin/DARwIn OP Part Files/OP 3D CAD Files/3D STEP/1_PR13_B01_BRKT_CAM.step

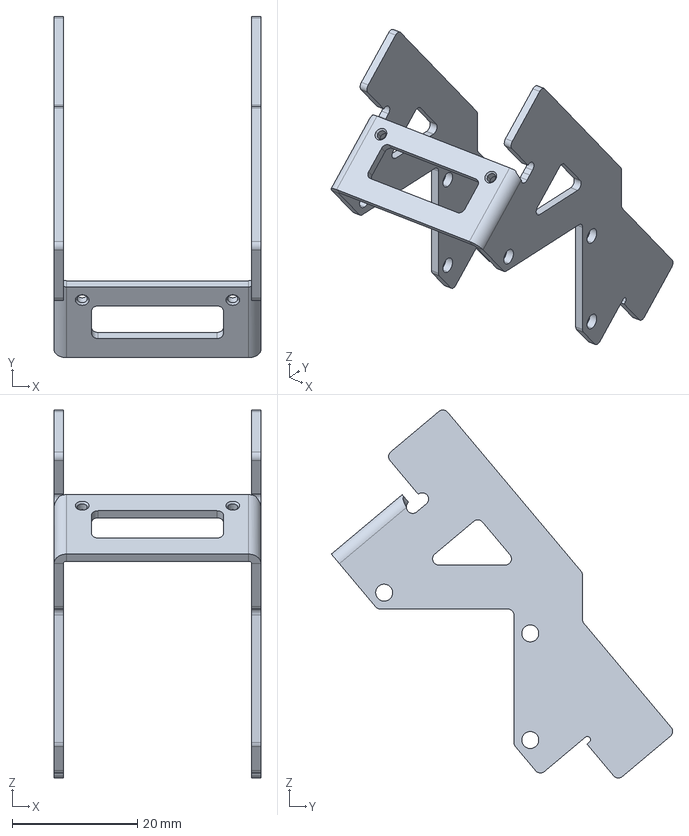
[picture p203: CAD file, 2013-12-12]
doc/Documentation et reference/Darwin/DARwIn OP Part Files/OP 3D CAD Files/3D STEP/1_PR13_B01_BRKT_CAM.step
33.0 x 54.4 x 58.7 mm
