wael-suleiman-UdeS/RobotFoot/doc/Documentation et reference/Darwin/DARwIn OP Part Files/OP 2D CAD Files/2D STEP/8_PR13_B_FRM_CVR_BAT.step

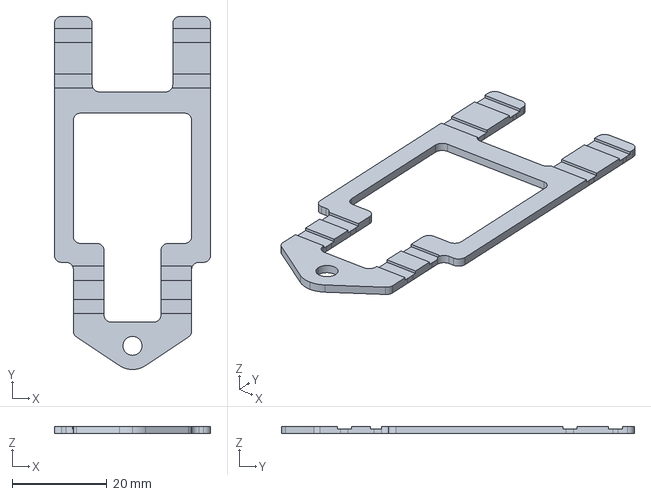
[picture p204: CAD file, 2013-12-12]
doc/Documentation et reference/Darwin/DARwIn OP Part Files/OP 2D CAD Files/2D STEP/8_PR13_B_FRM_CVR_BAT.step
33.0 x 74.5 x 1.50 mm
