wael-suleiman-UdeS/RobotFoot/solidworks/Jambes/Leg_Femur.SLDPRT

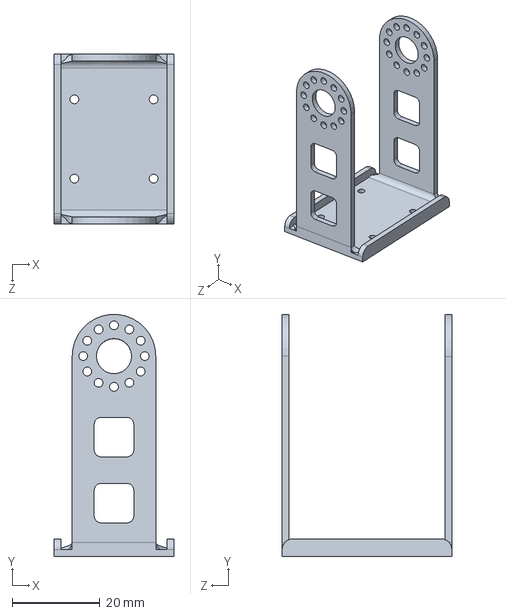
[picture p206: CAD file, 2013-04-02]
solidworks/Jambes/Leg_Femur.SLDPRT
27.2 x 55.0 x 38.6 mm
