wael-suleiman-UdeS/RobotFoot/doc/Documentation et reference/Darwin/DARwIn OP Part Files/OP 2D CAD Files/2D STEP/1_PR13_B01_BRKT_CAM.step

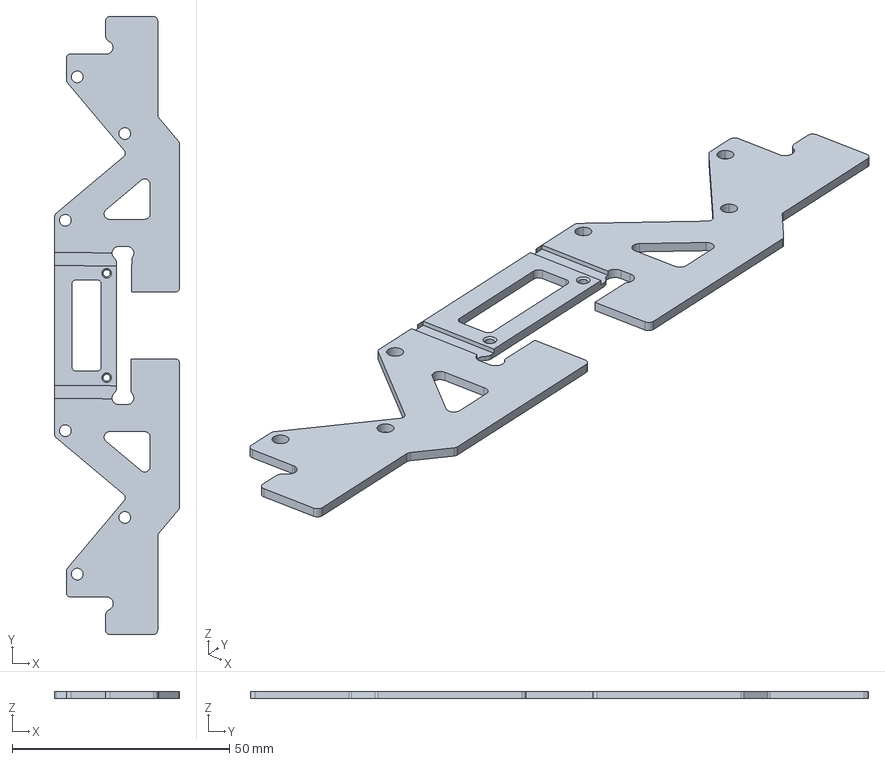
[picture p207: CAD file, 2013-12-12]
doc/Documentation et reference/Darwin/DARwIn OP Part Files/OP 2D CAD Files/2D STEP/1_PR13_B01_BRKT_CAM.step
28.8 x 142.1 x 1.50 mm
