wael-suleiman-UdeS/RobotFoot/solidworks/Jambes/Leg_Foot.SLDPRT

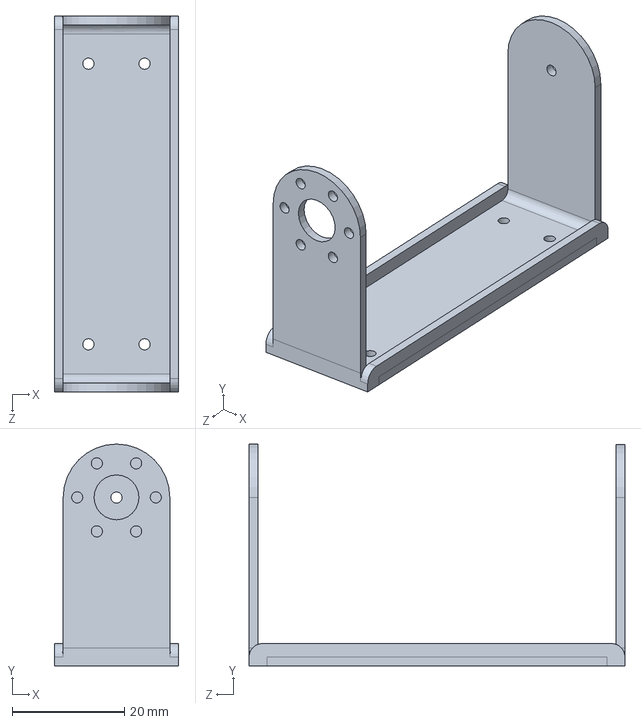
[picture p208: CAD file, 2013-04-02]
solidworks/Jambes/Leg_Foot.SLDPRT
22.2 x 39.5 x 67.0 mm
