wael-suleiman-UdeS/RobotFoot/doc/Documentation et reference/Darwin/DARwIn OP Part Files/OP 2D CAD Files/2D STEP/9R_PR13_B_BRKT_PELV_R.step

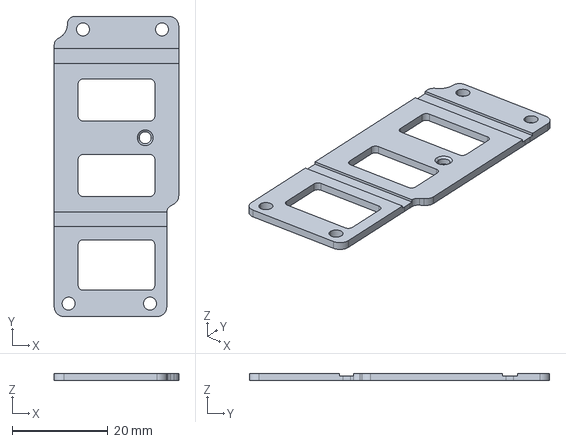
[picture p211: CAD file, 2013-12-12]
doc/Documentation et reference/Darwin/DARwIn OP Part Files/OP 2D CAD Files/2D STEP/9R_PR13_B_BRKT_PELV_R.step
26.0 x 62.6 x 1.50 mm
