wael-suleiman-UdeS/RobotFoot/(list of files, cad)

Other CAD files:
doc/Documentation et reference/Darwin/DARwIn OP Part Files/OP 3D CAD Files/3D PRT/5_PR13_B01_FRM_PCB_MAIN_B-1.sldprt
doc/Documentation et reference/Darwin/DARwIn OP Part Files/OP 3D CAD Files/3D PRT/4_PR13_B01_FRM_PCB_MAIN_T.sldprt
doc/Documentation et reference/Darwin/DARwIn OP Part Files/OP 3D CAD Files/3D PRT/5_PR13_B01_FRM_PCB_MAIN_B.sldprt
doc/Documentation et reference/Darwin/DARwIn OP Part Files/OP 3D CAD Files/3D PRT/5_PR13_B01_FRM_PCB_MAIN_B-2.sldprt
doc/Documentation et reference/Darwin/DARwIn OP Part Files/OP 3D CAD Files/3D PRT/16_FR07_H132.sldprt
solidworks/Head/Head_Neck.SLDPRT
doc/Documentation et reference/Darwin/DARwIn OP Part Files/OP 2D CAD Files/2D PRT/10_FR07_H102.sldprt
doc/Documentation et reference/Darwin/DARwIn OP Part Files/OP 3D CAD Files/3D STEP/3_FR07_X101.step
solidworks/Exports/Plans/STEP export/Head_Neck.STEP
solidworks/Head/Head_Upper.SLDPRT
doc/Documentation et reference/Darwin/DARwIn OP Part Files/OP 2D CAD Files/2D PRT/3_FR07_X101.sldprt
doc/Documentation et reference/Darwin/DARwIn OP Part Files/OP 3D CAD Files/3D PRT/6_PR13_B_SPACER_PELV.sldprt
solidworks/servomoteur/(#112458) KSB1023A_T2X25NI.sldprt
doc/Documentation et reference/Darwin/DARwIn OP Part Files/OP 3D CAD Files/3D PRT/13_FR07_H120.sldprt
solidworks/Exports/Plans/STEP export/Leg_Hanche.STEP
solidworks/Exports/STEP export/Leg_Hanche.STEP
solidworks/Jambes/STL export/BracketHanche.STL
solidworks/servomoteur/(#31287) TOP_191.sldprt
solidworks/Jambes/Leg_Tibia.SLDPRT
solidworks/servomoteur/(#129725) KSB1023A_M2_5X8Z.sldprt
solidworks/Exports/Plans/STEP export/Leg_beringAttach.STEP
solidworks/Jambes/Leg_Hanche.SLDPRT
doc/Documentation et reference/Darwin/DARwIn OP Part Files/OP 2D CAD Files/2D STEP/14_FR07_S101.step
doc/Documentation et reference/Darwin/DARwIn OP Part Files/OP 3D CAD Files/3D PRT/14_FR07_S101.sldprt
solidworks/Exports/Plans/STEP export/Leg_Foot.STEP
solidworks/Exports/STEP export/Leg_Tibia.STEP
solidworks/Jambes/Leg_BeringAttach.SLDPRT
solidworks/Exports/STEP export/Leg_RightFoot.STEP
solidworks/Jambes/Leg_RightFoot.SLDPRT
solidworks/Exports/Plans/STEP export/head_upper.STEP
solidworks/Exports/STEP export/Chest_Upper.STEP
solidworks/Jambes/Leg_LeftFoot.SLDPRT
doc/Documentation et reference/Darwin/DARwIn OP Part Files/OP 3D CAD Files/3D PRT/8_PR13_FRM_CVR_BAT-1.sldprt
solidworks/Exports/Plans/STEP export/Chest_Middle.STEP
solidworks/Exports/STEP export/Leg_beringAttach.STEP
doc/Documentation et reference/Darwin/DARwIn OP Part Files/OP 3D CAD Files/3D PRT/1_PR13_B01_BRKT_CAM.sldprt
solidworks/Exports/STEP export/Leg_LeftFoot.STEP
doc/Documentation et reference/Darwin/DARwIn OP Part Files/OP 3D CAD Files/3D PRT/17_FR07_H133.sldprt
solidworks/Exports/Plans/STEP export/Leg_RightFoot.STEP
solidworks/Exports/STEP export/Leg_Femur.STEP
doc/Documentation et reference/Darwin/DARwIn OP Part Files/OP 3D CAD Files/3D PRT/17_FR07_H133-1.sldprt
doc/Documentation et reference/Darwin/DARwIn OP Part Files/OP 3D CAD Files/3D PRT/8_PR13_FRM_CVR_BAT.sldprt
doc/Documentation et reference/Darwin/DARwIn OP Part Files/OP 3D CAD Files/3D STEP/6_PR13_B_SPACER_PELV.step
doc/Documentation et reference/Darwin/DARwIn OP Part Files/OP 3D CAD Files/3D STEP/15_FR07_X102.step
3D Models/servomoteur/Document.sldprt
3D Models/servomoteur/ServoParfait.SLDASM
doc/Documentation et reference/Darwin/DARwIn OP Part Files/OP 2D CAD Files/2D IGS/10_FR07_H102.igs
doc/Documentation et reference/Darwin/DARwIn OP Part Files/OP 2D CAD Files/2D IGS/11_FR07_SC101.igs
doc/Documentation et reference/Darwin/DARwIn OP Part Files/OP 2D CAD Files/2D IGS/12_FR07_E180.igs
doc/Documentation et reference/Darwin/DARwIn OP Part Files/OP 2D CAD Files/2D IGS/13_FR07_H120.igs
doc/Documentation et reference/Darwin/DARwIn OP Part Files/OP 2D CAD Files/2D IGS/14_FR07_S101.igs
doc/Documentation et reference/Darwin/DARwIn OP Part Files/OP 2D CAD Files/2D IGS/15_FR07_X102.igs
doc/Documentation et reference/Darwin/DARwIn OP Part Files/OP 2D CAD Files/2D IGS/16_FR07_H132.igs
doc/Documentation et reference/Darwin/DARwIn OP Part Files/OP 2D CAD Files/2D IGS/17_FR07_H133.igs
doc/Documentation et reference/Darwin/DARwIn OP Part Files/OP 2D CAD Files/2D IGS/18_FR07_E160.igs
doc/Documentation et reference/Darwin/DARwIn OP Part Files/OP 2D CAD Files/2D IGS/1_PR13_B01_BRKT_CAM.igs
doc/Documentation et reference/Darwin/DARwIn OP Part Files/OP 2D CAD Files/2D IGS/2_FR07_H104.igs
doc/Documentation et reference/Darwin/DARwIn OP Part Files/OP 2D CAD Files/2D IGS/3_FR07_X101.igs
doc/Documentation et reference/Darwin/DARwIn OP Part Files/OP 2D CAD Files/2D IGS/4_PR13_B01_FRM_PCB_MAIN_T.igs
doc/Documentation et reference/Darwin/DARwIn OP Part Files/OP 2D CAD Files/2D IGS/5_PR13_B01_FRM_PCB_MAIN_B.igs
doc/Documentation et reference/Darwin/DARwIn OP Part Files/OP 2D CAD Files/2D IGS/6_PR13_B_SPACER_PELV.igs
doc/Documentation et reference/Darwin/DARwIn OP Part Files/OP 2D CAD Files/2D IGS/7_FR07_E130.igs
doc/Documentation et reference/Darwin/DARwIn OP Part Files/OP 2D CAD Files/2D IGS/8_PR13_B_FRM_CVR_BAT.igs
doc/Documentation et reference/Darwin/DARwIn OP Part Files/OP 2D CAD Files/2D IGS/9L_PR13_B_BRKT_PELV_L.igs
doc/Documentation et reference/Darwin/DARwIn OP Part Files/OP 2D CAD Files/2D IGS/9R_PR13_B_BRKT_PELV_R.igs
doc/Documentation et reference/Darwin/DARwIn OP Part Files/OP 2D CAD Files/2D PRT/10_FR07_H102.prt
doc/Documentation et reference/Darwin/DARwIn OP Part Files/OP 2D CAD Files/2D PRT/11_FR07_SC101.prt
doc/Documentation et reference/Darwin/DARwIn OP Part Files/OP 2D CAD Files/2D PRT/12_FR07_E180.prt
doc/Documentation et reference/Darwin/DARwIn OP Part Files/OP 2D CAD Files/2D PRT/13_FR07_H120.prt
doc/Documentation et reference/Darwin/DARwIn OP Part Files/OP 2D CAD Files/2D PRT/14_FR07_S101.prt
doc/Documentation et reference/Darwin/DARwIn OP Part Files/OP 2D CAD Files/2D PRT/15_FR07_X102.prt
doc/Documentation et reference/Darwin/DARwIn OP Part Files/OP 2D CAD Files/2D PRT/16_FR07_H132.prt
doc/Documentation et reference/Darwin/DARwIn OP Part Files/OP 2D CAD Files/2D PRT/17_FR07_H133.prt
doc/Documentation et reference/Darwin/DARwIn OP Part Files/OP 2D CAD Files/2D PRT/18_FR07_E160.prt
doc/Documentation et reference/Darwin/DARwIn OP Part Files/OP 2D CAD Files/2D PRT/1_PR13_B01_BRKT_CAM.prt
doc/Documentation et reference/Darwin/DARwIn OP Part Files/OP 2D CAD Files/2D PRT/2_FR07_H104.prt
doc/Documentation et reference/Darwin/DARwIn OP Part Files/OP 2D CAD Files/2D PRT/3_FR07_X101.prt
doc/Documentation et reference/Darwin/DARwIn OP Part Files/OP 2D CAD Files/2D PRT/4_PR13_B01_FRM_PCB_MAIN_T.prt
doc/Documentation et reference/Darwin/DARwIn OP Part Files/OP 2D CAD Files/2D PRT/5_PR13_B01_FRM_PCB_MAIN_B.prt
doc/Documentation et reference/Darwin/DARwIn OP Part Files/OP 2D CAD Files/2D PRT/6_PR13_B_SPACER_PELV.prt
doc/Documentation et reference/Darwin/DARwIn OP Part Files/OP 2D CAD Files/2D PRT/7_FR07_E130.prt
doc/Documentation et reference/Darwin/DARwIn OP Part Files/OP 2D CAD Files/2D PRT/8_PR13_B_FRM_CVR_BAT.prt
doc/Documentation et reference/Darwin/DARwIn OP Part Files/OP 2D CAD Files/2D PRT/9L_PR13_B_BRKT_PELV_L.prt
doc/Documentation et reference/Darwin/DARwIn OP Part Files/OP 2D CAD Files/2D PRT/9R_PR13_B_BRKT_PELV_R.prt
doc/Documentation et reference/Darwin/DARwIn OP Part Files/OP 3D CAD Files/3D IGS/10_FR07_H102.igs
doc/Documentation et reference/Darwin/DARwIn OP Part Files/OP 3D CAD Files/3D IGS/11_FR07_SC101.igs
doc/Documentation et reference/Darwin/DARwIn OP Part Files/OP 3D CAD Files/3D IGS/12_FR07_E180.igs
doc/Documentation et reference/Darwin/DARwIn OP Part Files/OP 3D CAD Files/3D IGS/13_FR07_H120.igs
doc/Documentation et reference/Darwin/DARwIn OP Part Files/OP 3D CAD Files/3D IGS/14_FR07_S101.igs
doc/Documentation et reference/Darwin/DARwIn OP Part Files/OP 3D CAD Files/3D IGS/15_FR07_X102.igs
doc/Documentation et reference/Darwin/DARwIn OP Part Files/OP 3D CAD Files/3D IGS/16_FR07_H132.igs
doc/Documentation et reference/Darwin/DARwIn OP Part Files/OP 3D CAD Files/3D IGS/17_FR07_H133.igs
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
