wael-suleiman-UdeS/RobotFoot/Darwin/Test2/backup/Test.txt

180 701 23 2 392 -131
0.1 0.2 0.1 0.2 0.1 0.1
0.1 0.2 0.1 0.2 0.1 0.1
0.1 0.2 0.1 0.2 0.1 0.1
0.1 0.2 0.1 0.2 0.1 0.1
0.1 0.2 0.1 0.2 0.1 0.1
0.1 0.2 0.1 0.2 0.1 0.1
0.1 0.2 0.1 0.2 0.1 0.1
0.1 0.2 0.1 0.2 0.1 0.1
0.1 0.2 0.1 0.2 0.1 0.1
0.1 0.2 0.1 0.2 0.1 0.1
0.1 0.2 0.1 0.2 0.1 0.1
0.1 0.2 0.1 0.2 0.1 0.1
0.1 0.2 0.1 0.2 0.1 0.1
0.1 0.2 0.1 0.2 0.1 0.1
0.1 0.2 0.1 0.2 0.1 0.1
0.1 0.2 0.1 0.2 0.1 0.1
0.1 0.2 0.1 0.2 0.1 0.1
0.1 0.2 0.1 0.2 0.1 0.1
