wael-suleiman-UdeS/RobotFoot/solidworks/Exports/Plans/pdf/Bracket.PDF

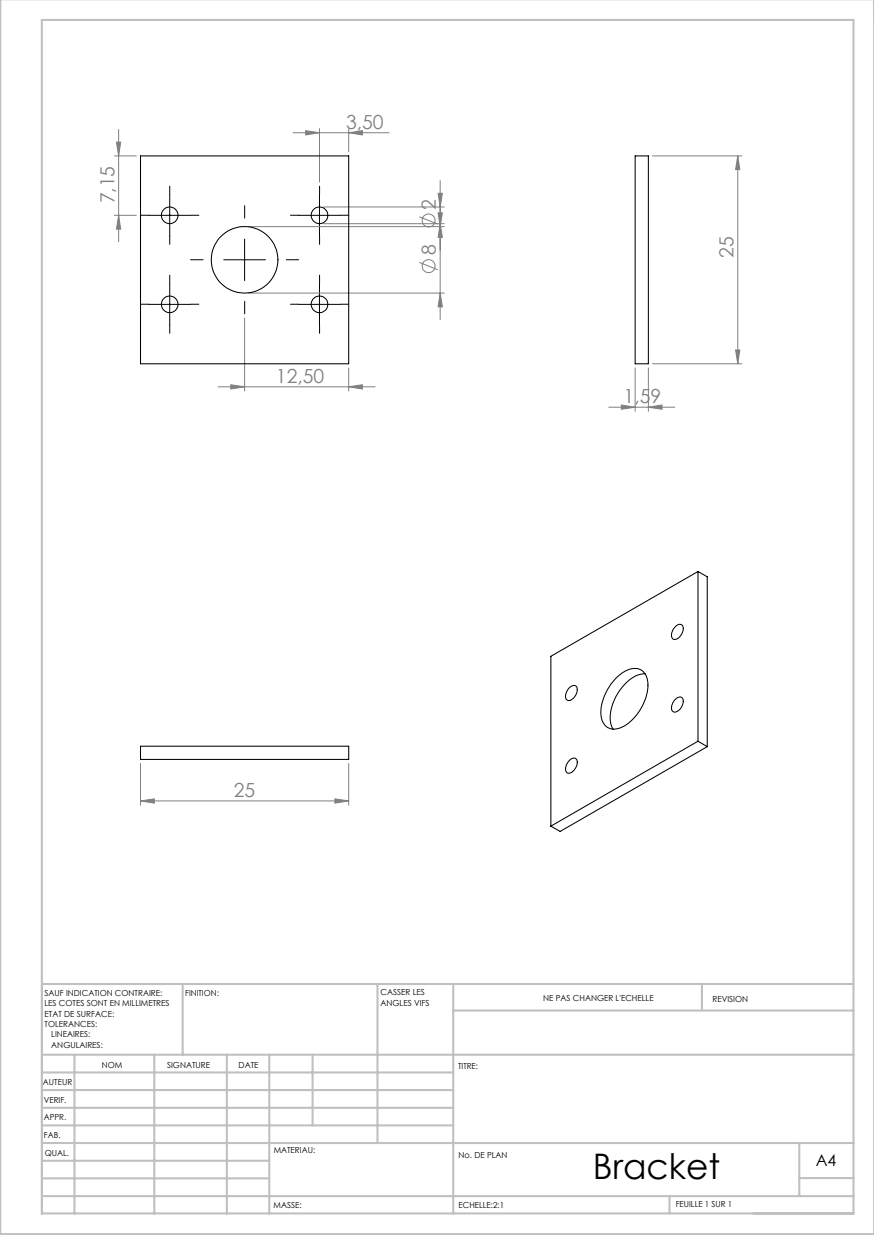
[picture p222: page 1]
ECHELLE:2:1; FEUILLE 1 SUR 1; NE PAS CHANGER L'ECHELLE; REVISION; CASSER LES ANGLES VIFS; SAUF INDICATION CONTRAIRE:; FINITION:

LES COTES SONT EN MILLIMETRES
ETAT DE SURFACE:
TOLERANCES:
LINEAIRES:
ANGULAIRES:

NOM | SIGNATURE | DATE | | | | TITRE:
QUAL. | | | | MATERIAU: | Bracket MASSE: No. DE PLAN | A4

AUTEUR
VERIF.
APPR.
FAB.
