wael-suleiman-UdeS/RobotFoot/solidworks/Exports/Plans/pdf/Knee.PDF

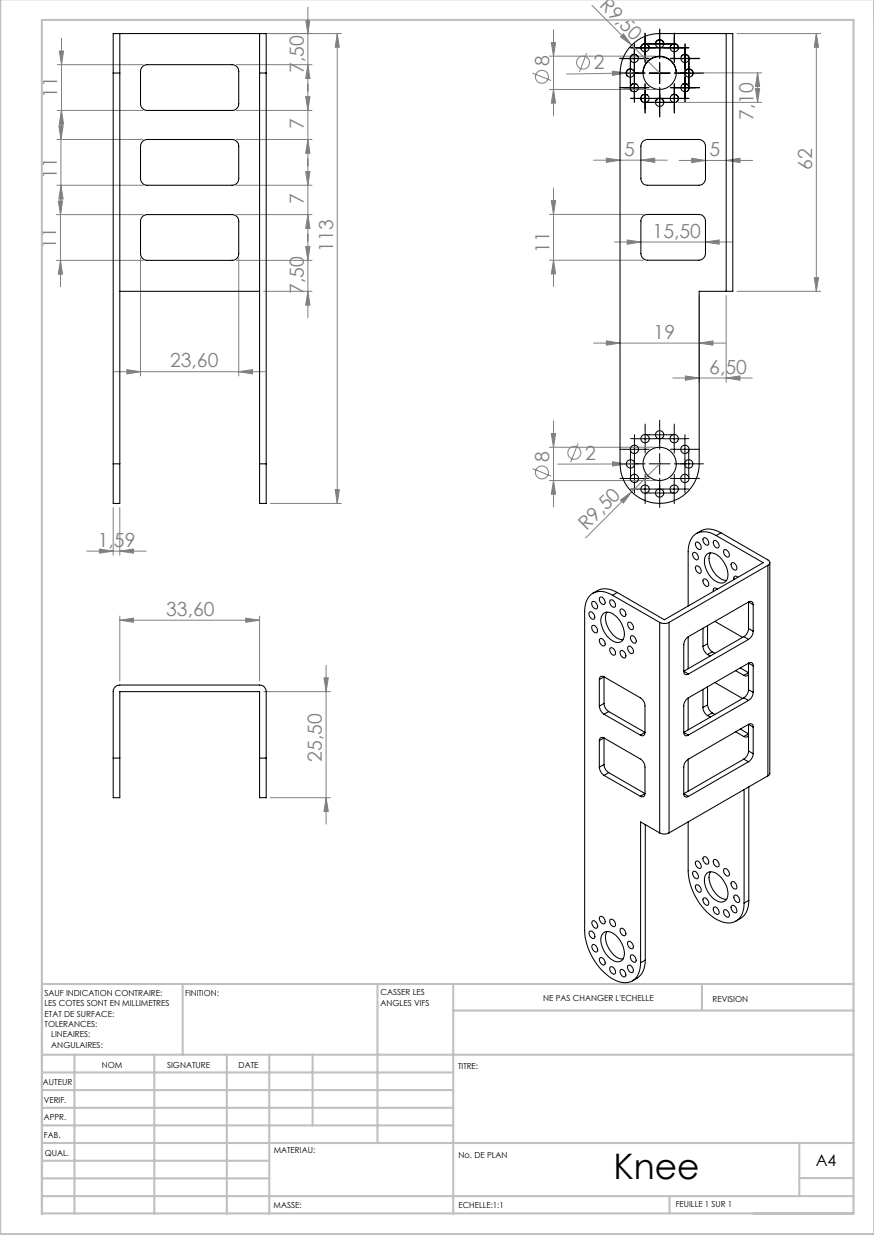
[picture p223: page 1]
ECHELLE:1:1; FEUILLE 1 SUR 1; NE PAS CHANGER L'ECHELLE; REVISION; CASSER LES ANGLES VIFS; SAUF INDICATION CONTRAIRE:; FINITION:

LES COTES SONT EN MILLIMETRES
ETAT DE SURFACE:
TOLERANCES:
LINEAIRES:
ANGULAIRES:

NOM | SIGNATURE | DATE | | | | TITRE:

AUTEUR
VERIF.
APPR.
FAB.
QUAL. | | | | MATERIAU: | Knee MASSE: No. DE PLAN | A4
