wael-suleiman-UdeS/RobotFoot/PCB/cartectrl.pdf

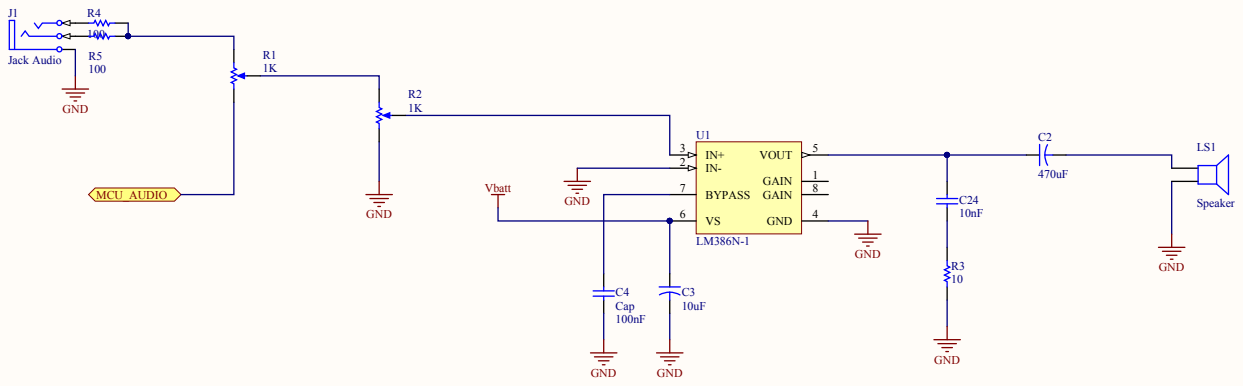
[picture p224: page 1]

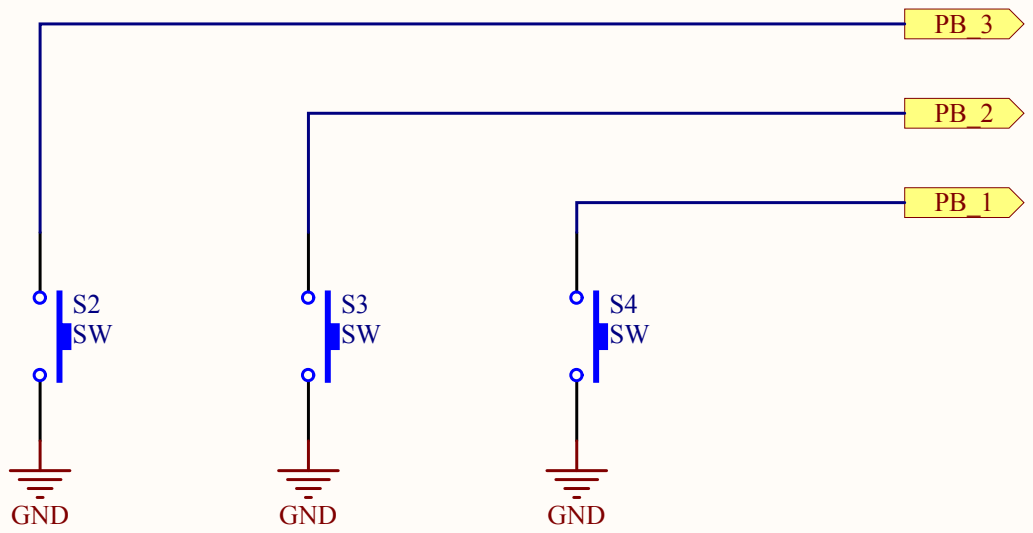
[picture p225: page 2]

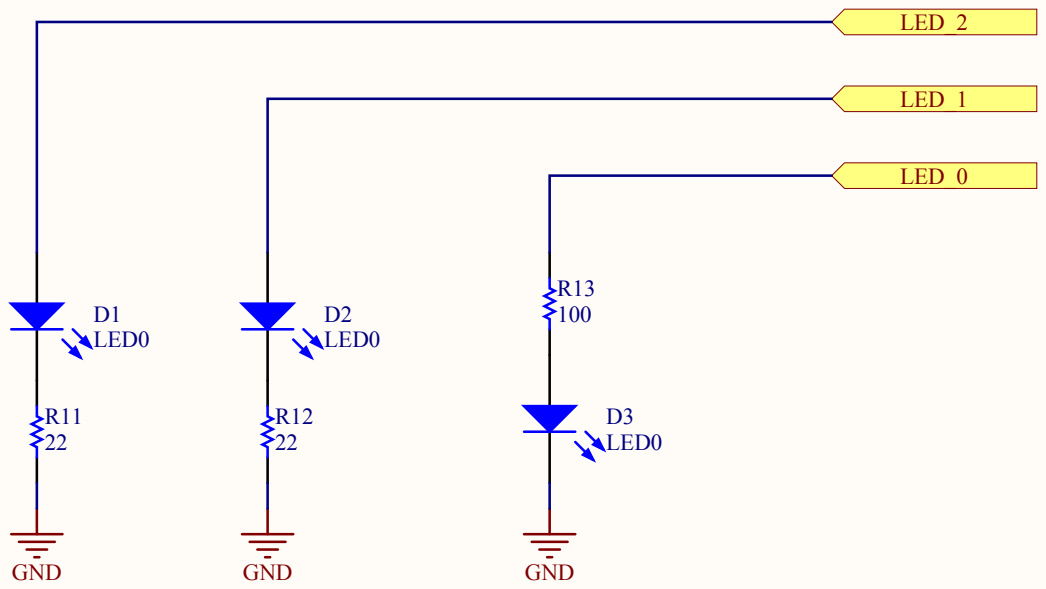
[picture p226: page 3]

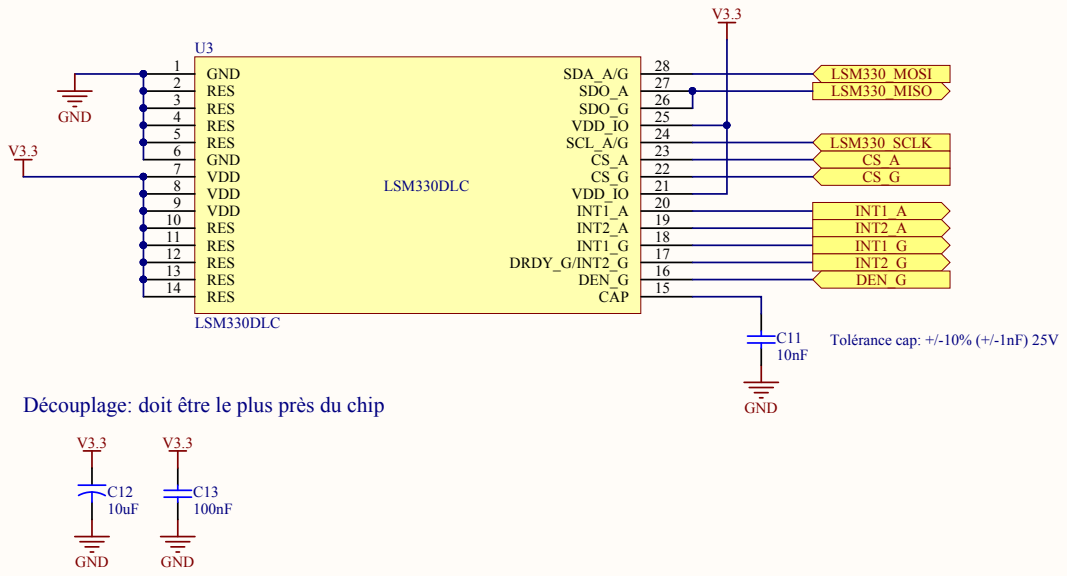
[picture p227: page 4]

Découplage: doit être le plus près du chip

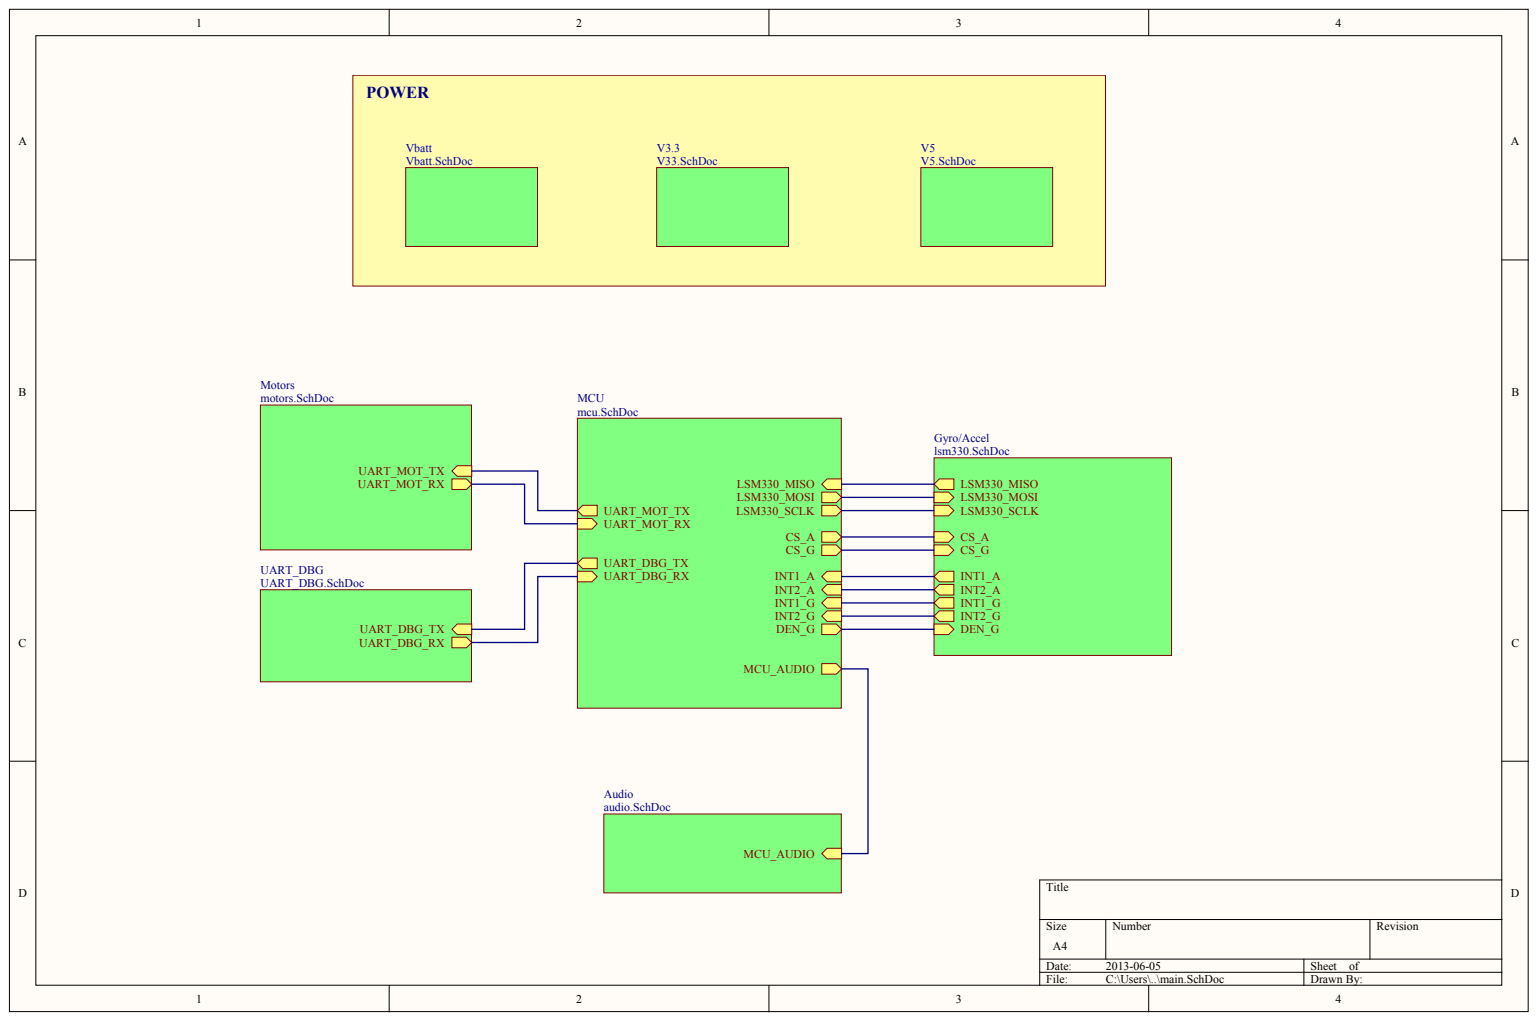
[picture p228: page 5]

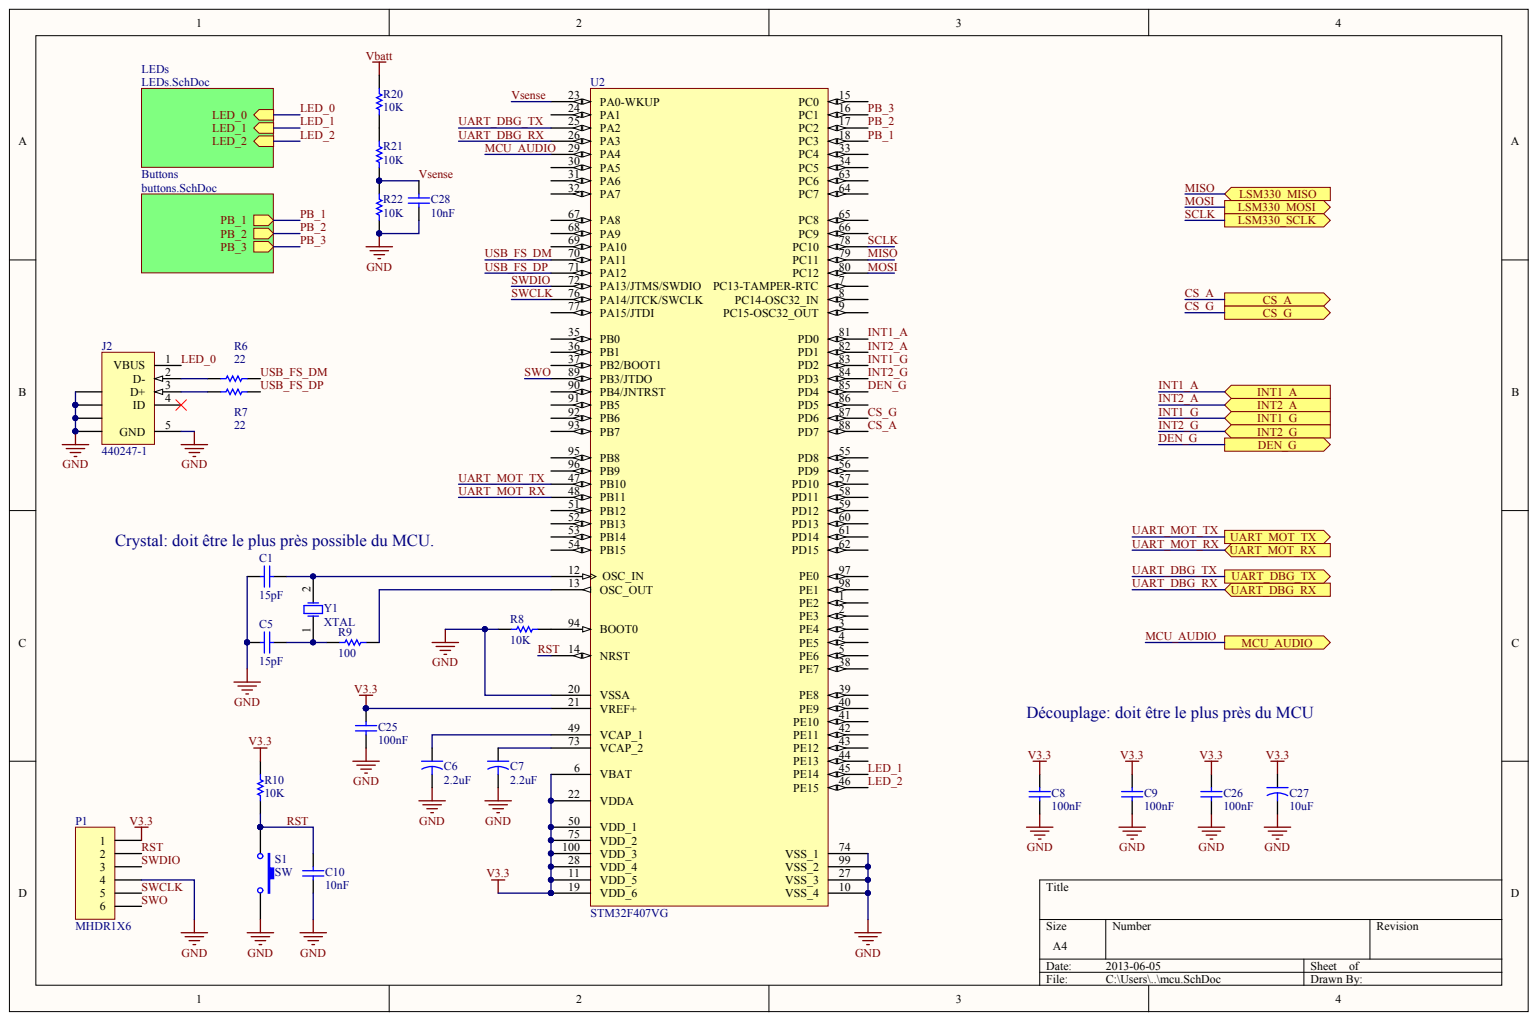
[picture p229: page 6]

Crystal: doit être le plus près possible du MCU.

OSC_OUT 13

R8 | BOOT0 94

NRST 14 VSSA 20

Découplage: doit être le plus près du MCU

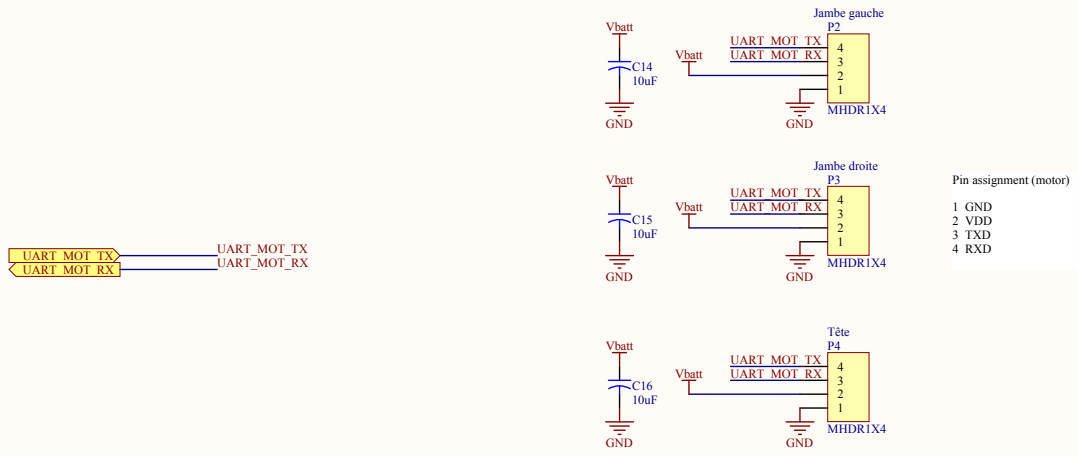
[picture p230: page 7]

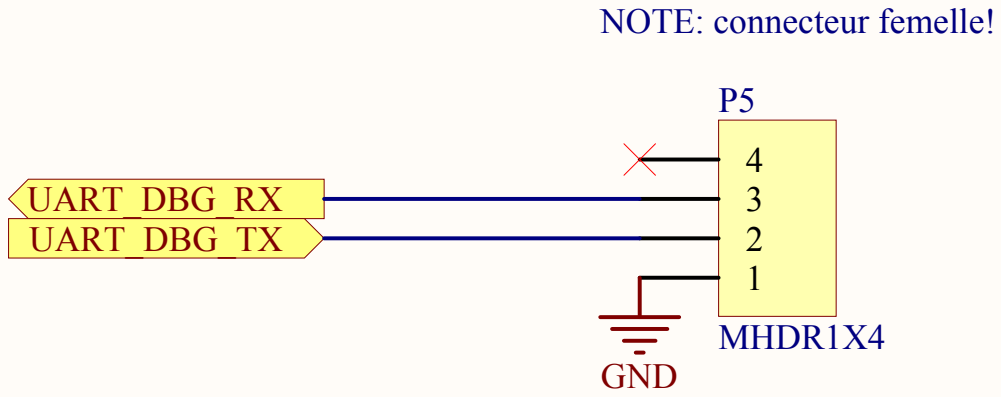
[picture p231: page 8]

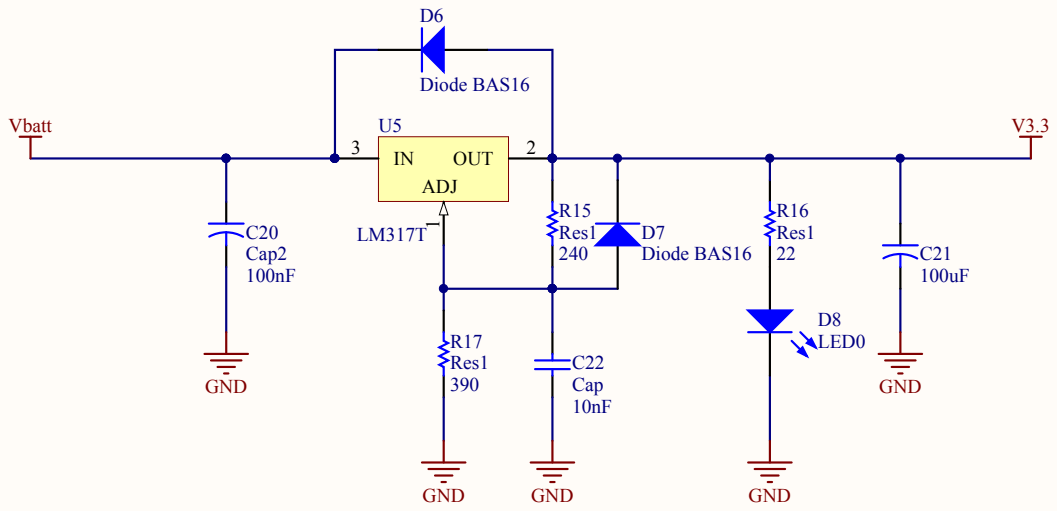
[picture p232: page 9]

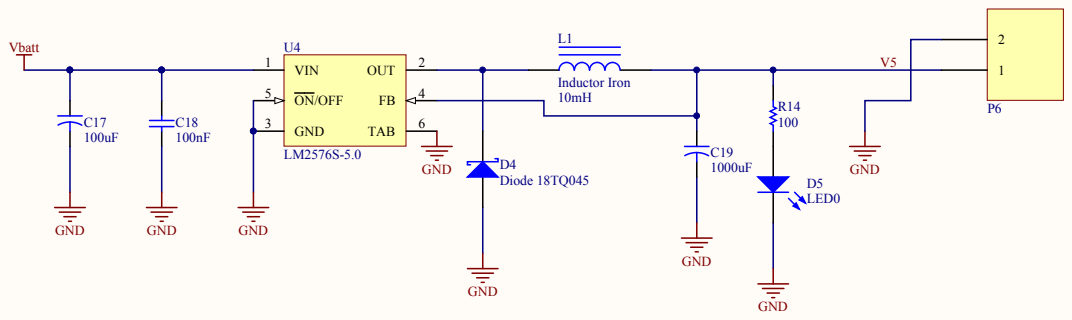
[picture p233: page 10]

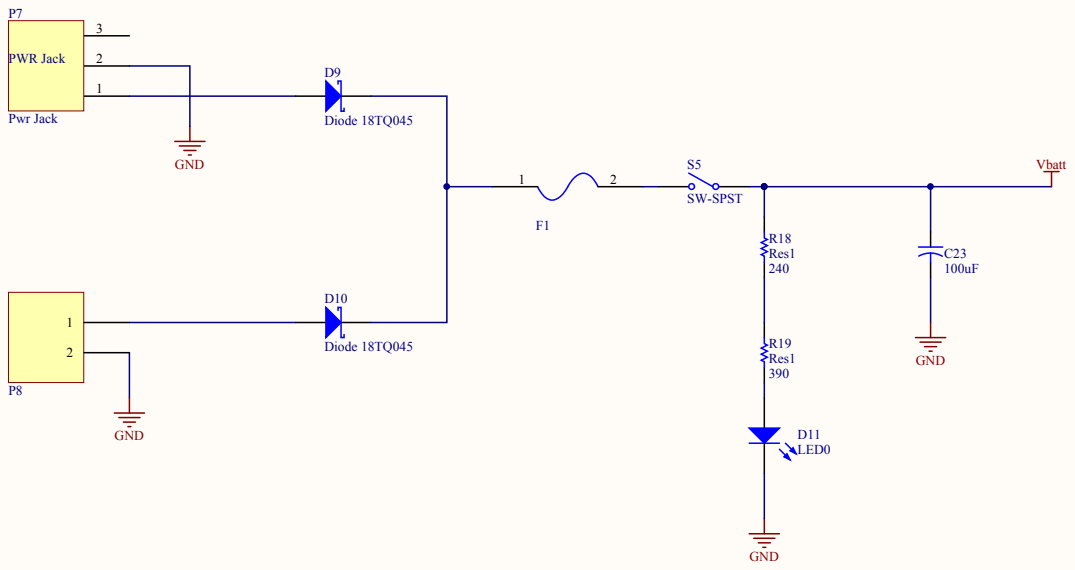
[picture p234: page 11]

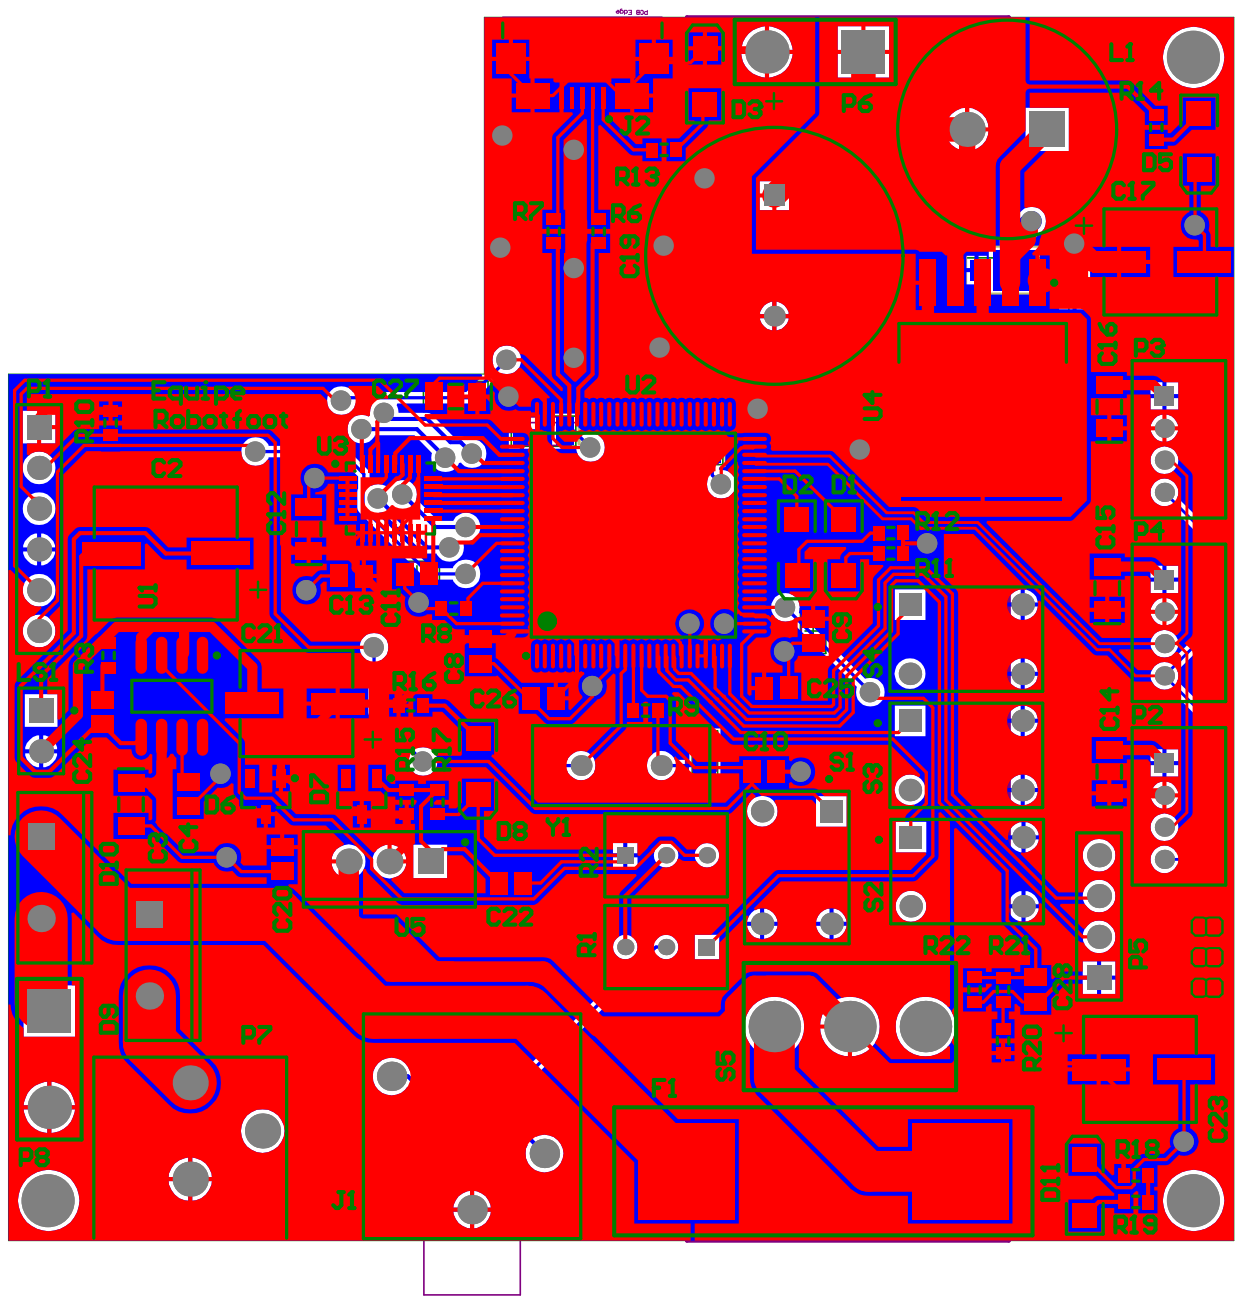
[picture p235: page 12]
