wael-suleiman-UdeS/RobotFoot/Livrables/Présentation Publique/Robotfoot_affiche4.pdf

# Comment construire un robot de A à Z

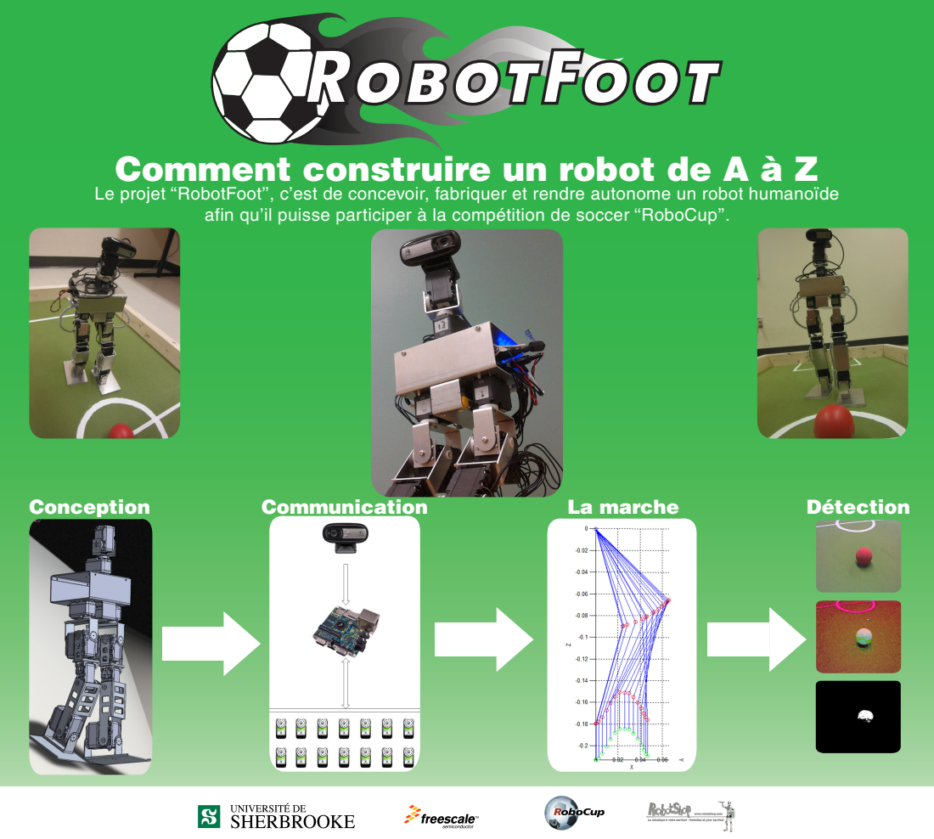
[picture p236: page 1]
Conception; Communication; La marche; Détection

Le projet ‘‘RobotFoot’’, c’est de concevoir, fabriquer et rendre autonome un robot humanoïde

afin qu’il puisse participer à la compétition de soccer ‘‘RoboCup’’.
