wael-suleiman-UdeS/RobotFoot/Livrables/Présentation Publique/affiche2/robotfoot_logo.pdf

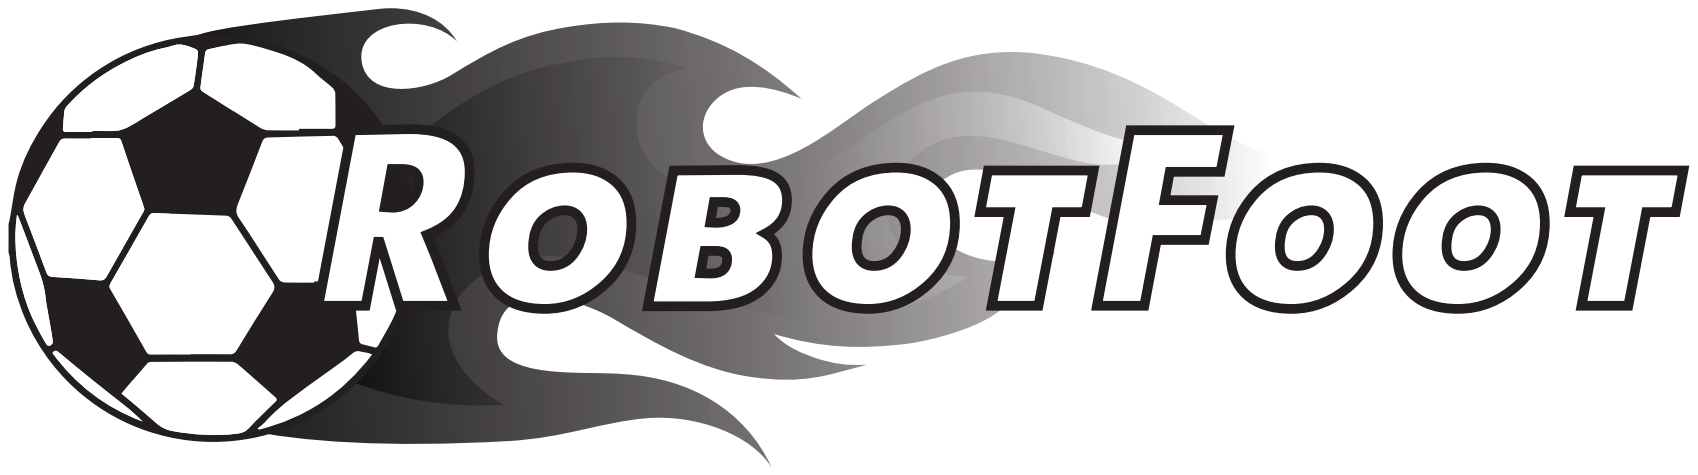
[picture p237: page 1]
