wael-suleiman-UdeS/RobotFoot/solidworks/Chest/plans/Chest_Lower.PDF

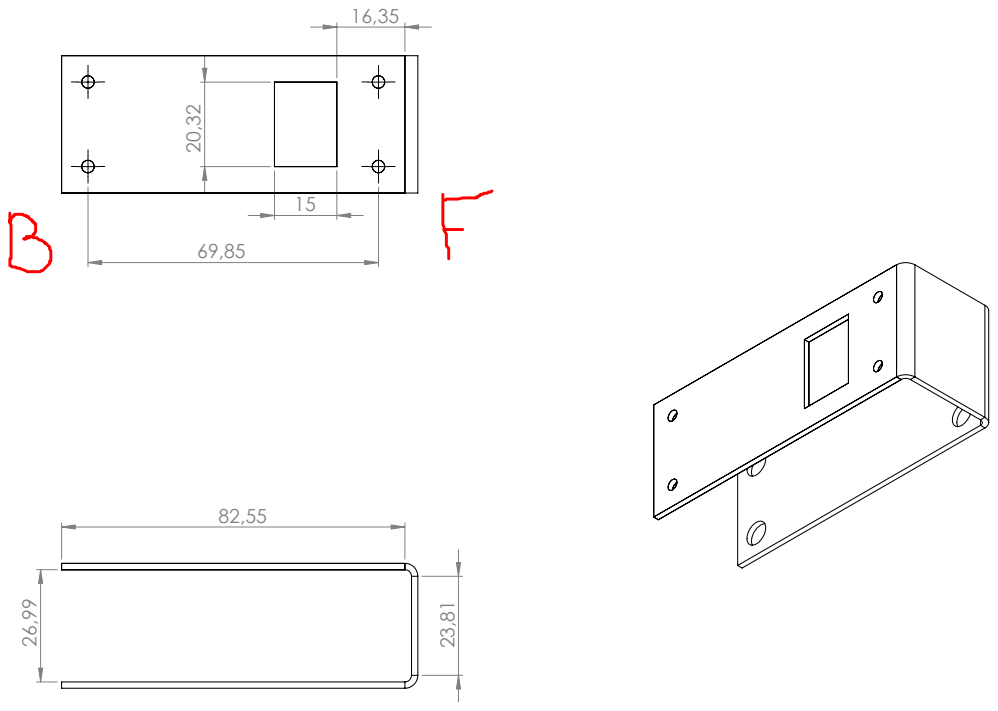
[picture p238: page 1]
