wael-suleiman-UdeS/RobotFoot/solidworks/Chest/plans/Chest_Upper.PDF

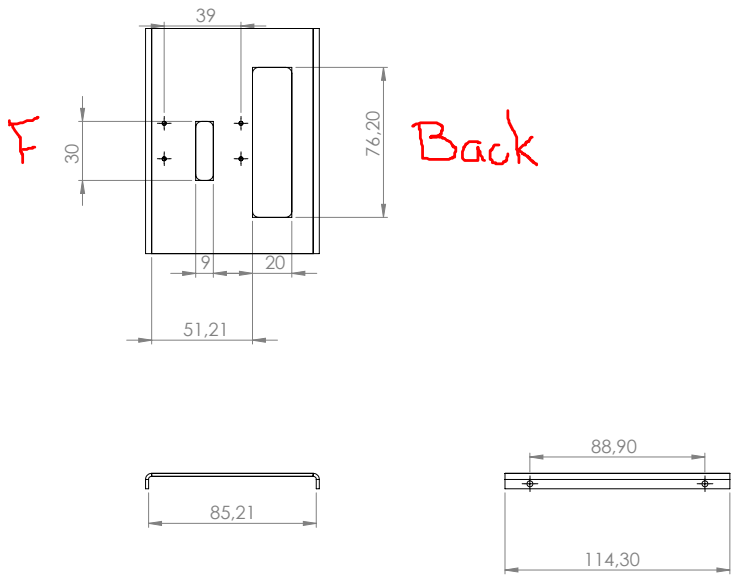
[picture p239: page 1]
