wael-suleiman-UdeS/RobotFoot/(list of files, drawings)

Other design files:
Altium/audio.SchDoc
Altium/buttons.SchDoc
Altium/cartectrl.PrjPcb
Altium/LEDs.SchDoc
Altium/lsm330.SchDoc
Altium/mcu.SchDoc
Altium/motors.SchDoc
Altium/PCB.PcbDoc
Altium/robotfoot.PcbLib
Altium/UART_DBG.SchDoc
Altium/V5.SchDoc
Altium/V33.SchDoc
Altium/Vbatt.SchDoc
PCB/Altium/audio.SchDoc
PCB/Altium/buttons.SchDoc
PCB/Altium/cartectrl.PrjPcb
PCB/Altium/LEDs.SchDoc
PCB/Altium/lsm330.SchDoc
PCB/Altium/main.SchDoc
PCB/Altium/mcu-adv.SchDoc
PCB/Altium/mcu.SchDoc
PCB/Altium/motors.SchDoc
PCB/Altium/PCB.PcbDoc
PCB/Altium/UART_DBG.SchDoc
PCB/Altium/V5.SchDoc
PCB/Altium/V33.SchDoc
PCB/Altium/Vbatt.SchDoc
