wael-suleiman-UdeS/RobotFoot/3D Printer/Configuration.h

#define CONFIGURATION_H
#define MOTHERBOARD 33
#define THERMISTORHEATER 7
#define THERMISTORBED 7
#define _AXIS_STEP_PER_UNIT {40, 79, 3200/1.25,140}
#define ENDSTOPPULLUPS // Comment this out (using // at the start of the line) to disable the endstop pullup resistors
const bool X_ENDSTOP_INVERT = false;
const bool Y_ENDSTOP_INVERT = false;
const bool Z_ENDSTOP_INVERT = false;
#define BAUDRATE 115200
#define USE_ARC_FUNCTION
#define X_ENABLE_ON 0
#define Y_ENABLE_ON 0
#define Z_ENABLE_ON 0
#define E_ENABLE_ON 0
const bool DISABLE_X = false;
const bool DISABLE_Y = false;
const bool DISABLE_Z = true;
const bool DISABLE_E = false;
const bool INVERT_X_DIR = false;
const bool INVERT_Y_DIR = false;
const bool INVERT_Z_DIR = true;
const bool INVERT_E_DIR = false;
#define X_HOME_DIR -1
#define Y_HOME_DIR -1
#define Z_HOME_DIR -1
const bool min_software_endstops = false; //If true, axis won't move to coordinates less than zero.
const bool max_software_endstops = true; //If true, axis won't move to coordinates greater than the defined lengths below.
const int X_MAX_LENGTH = 200;
const int Y_MAX_LENGTH = 200;
const int Z_MAX_LENGTH = 300;
const int NUM_AXIS = 4; // The axis order in all axis related arrays is X, Y, Z, E
#define _MAX_FEEDRATE {400, 400, 4, 45}       // (mm/sec)
#define _HOMING_FEEDRATE {2000,2000,200}      // (mm/min) !!
#define _AXIS_RELATIVE_MODES {false, false, false, false}
#define MAX_STEP_FREQUENCY 30000 // Max step frequency
#define _ACCELERATION 1000         // Axis Normal acceleration mm/s^2
#define _RETRACT_ACCELERATION 2000 // Extruder Normal acceleration mm/s^2
#define _MAX_XY_JERK 20.0
#define _MAX_Z_JERK 0.4
#define _MAX_ACCELERATION_UNITS_PER_SQ_SECOND {5000,5000,50,5000}    // X, Y, Z and E max acceleration in mm/s^2 for printing moves or retracts
#define MINIMUM_PLANNER_SPEED 2.0 // (mm/sec)
#define DEFAULT_MINIMUMFEEDRATE       0.0     // minimum feedrate
#define DEFAULT_MINTRAVELFEEDRATE     0.0
#define SLOWDOWN
const int dropsegments=5; //everything with less than this number of steps will be ignored as move and joined with the next movement
#define _DEF_CHAR_UUID "00000000-0000-0000-0000-000000000000"
  #define BLOCK_BUFFER_SIZE 16
  #define BLOCK_BUFFER_MASK 0x0f
#define MM_PER_ARC_SEGMENT 1
#define N_ARC_CORRECTION 25
#define PIDTEMP 1
#define PID_SOFT_PWM
#define PID_INTEGRAL_DRIVE_MAX 80 // too big, and heater will lag after changing temperature, too small and it might not compensate enough for long-term errors
#define PID_PGAIN 2560 //256 is 1.0  // value of X means that error of 1 degree is changing PWM duty by X, probably no need to go over 25
#define PID_IGAIN 64 //256 is 1.0  // value of X (e.g 0.25) means that each degree error over 1 sec (2 measurements) changes duty cycle by 2X (=0.5) units (verify?)
#define PID_DGAIN 4096 //256 is 1.0  // value of X means that around reached setpoint, each degree change over one measurement (half second) adjusts PWM by X units to compensate
#define HEATER_DUTY_FOR_SETPOINT(setpoint) ((int)((187L*(long)setpoint)>>8)-27)
#define LED_PWM_FOR_BRIGHTNESS(brightness) ((64*brightness-1384)/(300-brightness))
#define HEATER_CURRENT 255
#define HEATER_CHECK_INTERVAL 500
#define BED_CHECK_INTERVAL 5000
#define DISABLE_CHECK_DURING_ACC
#define DISABLE_CHECK_DURING_TRAVEL 1000
#define MINTEMP 5
#define MAXTEMP 275
#define HEATER_USES_THERMISTOR
#define BED_USES_THERMISTOR
#define CONTROLLERFAN_SEC 60 //How many seconds, after all motors were disabled, the fan should run
