wael-suleiman-UdeS/RobotFoot/Embedded_Computer/src/RobotFoot.cpp

/*!
 * \file RobotFoot.cpp
 * \brief The main file of the project
 * \authors Mitchel Labonté and Mickael Paradis
 * \version 0.2
 */
#include <iostream>
#include <boost/filesystem.hpp>
#include <boost/chrono.hpp>
#include <memory> // shared_ptr

#include "Utilities/XmlParser.h"
#include "Utilities/logger.h"
#include "Utilities/ThreadManager.h"
#include "Control/MotorControl_2.h"
#include "ImageProcessing/HeadControlTask.h"
#include "LegMotion/LegMotion.h"

int main(int argc, char * argv[])
{ 
    // Add io stream to Logger
    Logger::getInstance().addStream(std::cout);

    // Load config file
    Logger::getInstance() << "Loading configuration file..." << std::endl;
    XmlParser config;
    if (!config.loadFile("config/config.xml")) 
    {
        Logger::getInstance(Logger::LogLvl::ERROR) << "Error while loading configuration file." << std::endl;
        std::exit(1);
    }

    // Set logging level  
    Logger::getInstance().setLogLvl(config.getStringValue(XmlPath::Root / "Logging" / "LogLvl"));

    // Init IO_service for ThreadManager and MotorControl
    boost::asio::io_service boost_io;
    try
    {
        
        std::shared_ptr<ThreadManager> threadManager_ptr(new ThreadManager());
        std::shared_ptr<MotorControl> motorControl_ptr(new MotorControl(threadManager_ptr, config, boost_io));
        std::shared_ptr<HeadControlTask> headControlTask;
        std::shared_ptr<LegMotion> legMotion;
       
        bool activatedMotor = config.getIntValue(XmlPath::Root / XmlPath::Motion / XmlPath::ActivateMotor);
        bool isTracking = config.getIntValue(XmlPath::Root / XmlPath::ImageProcessing);
        bool isMoving   = config.getIntValue(XmlPath::Root / XmlPath::Motion);
        bool performInitPos = config.getIntValue(XmlPath::Root / XmlPath::Motion / XmlPath::PerformInitPosition);

        float distanceToKick = config.getIntValue(XmlPath::LegsMotors / XmlPath::DistanceToKick);
        float KickSpeedRatio = config.getIntValue(XmlPath::LegsMotors / XmlPath::KickSpeedRatio);
        float MouvementTime = config.getIntValue(XmlPath::LegsMotors / XmlPath::MouvementTime);

        int itTimeMs = config.getIntValue(XmlPath::Root / XmlPath::Motion / XmlPath::IterationTimeMs);
        if (isTracking)
        {
            headControlTask = std::make_shared<HeadControlTask>(threadManager_ptr, config, motorControl_ptr);
        }

        if (isMoving)
        {
            legMotion = std::make_shared<LegMotion>(threadManager_ptr, motorControl_ptr, config, activatedMotor);
        } 

        ObjectPosition objectToTrack;
        objectToTrack.y = 0;
        objectToTrack.x = 0;
        objectToTrack.angle = 0;

        Eigen::Vector2f pointD;
        Eigen::Vector2f startAngle;
        Eigen::Vector2f endAngle;

        // Start io task
        threadManager_ptr->create(80, [&boost_io]() mutable { boost_io.run(); }, ThreadManager::Task::IO_CONTROL);
        while (1) // main loop
        {
            // Wait for button start event
            while(motorControl_ptr->isPaused());

            if (isTracking && headControlTask)
            {
                // Starting Head task
                threadManager_ptr->create(50, [headControlTask]() mutable { headControlTask->run(); }, ThreadManager::Task::HEAD_CONTROL);
            }

            if (isMoving && legMotion)
            {
                legMotion->SetTorque();
                if (performInitPos)
                {
                    legMotion->InitPosition(4000);
                }
            }
            while (!motorControl_ptr->isPaused()) // main loop
            {
                if (isMoving)
                {
                    if (isTracking)
                    {
                        if (motorControl_ptr->isInterrupeted())
                        {
                            legMotion->InitPosition(4000);
                            motorControl_ptr->resetInterrupeted();
                        }
                        motorControl_ptr->SetObjectToTrack(MotorControl::Object::BALL);
                        while(objectToTrack.y <= 0 || objectToTrack.y > 100)
                        {
                            objectToTrack = motorControl_ptr->GetObjectPosition();
                        }
						objectToTrack.x /= 100;
                        objectToTrack.y /= 100;
                    }
                    else
                    {
                        // Dummy object detected
                        objectToTrack.y = 0.3;
                        objectToTrack.x = 0;
                        objectToTrack.angle = 0;
                    }
                    Logger::getInstance(Logger::LogLvl::INFO) << "Object distance : " << objectToTrack.y << std::endl;
                    pointD = Eigen::Vector2f(objectToTrack.y, 0);
                    startAngle = Eigen::Vector2f(0, 0);
                    endAngle = Eigen::Vector2f(0, 0);
                        

                    // Choose kick or walk and start motion task
                    if (objectToTrack.y <= distanceToKick)
                    {          
                        legMotion->InitKick(KickSpeedRatio, MouvementTime);
                    }
                    else
                    {
                        legMotion->InitWalk(pointD, startAngle, endAngle);
                        motorControl_ptr->isWalking(true);
                    }                    
                    threadManager_ptr->create(90, [legMotion, itTimeMs]() mutable { legMotion->Run(itTimeMs); }, ThreadManager::Task::LEGS_CONTROL);
                    threadManager_ptr->attach(ThreadManager::Task::LEGS_CONTROL);

                    objectToTrack.y = 0;
                    objectToTrack.x = 0;
                    objectToTrack.angle = 0;
                    motorControl_ptr->isWalking(false);
                }
                else
                {
                    threadManager_ptr->attach(ThreadManager::Task::IO_CONTROL);
                }
            }
        }
        Logger::getInstance() << "END" << std::endl;
    }
    catch (std::exception& e)
    {
        Logger::getInstance(Logger::LogLvl::ERROR) << "Exception in main() : " << e.what() << std::endl;
    }
    return 0;
}
