wael-suleiman-UdeS/RobotFoot/Embedded_Computer/src/Control/MotorControl_2.h

#ifndef MOTOR_CONTROL_H
#define MOTOR_CONTROL_H

#include "Control/STM32F4_2.h"
#include "Control/Motor.h"
#include "Control/Protocol.h"

#include "Utilities/ThreadManager.h"
#include "Utilities/XmlParser.h"

#include <vector>
#include <boost/thread/mutex.hpp>
#include <boost/circular_buffer.hpp>
#include <memory> // shared_ptr
#include <ostream>

struct ObjectPosition
{
public:
	double x;
	double y;
	double angle;
};

inline std::ostream & operator<<(std::ostream &os, const ObjectPosition &position)
{
	os << position.x << "," << position.y;
	return os;
}

inline std::ostream & operator<<(std::ostream &&os, const ObjectPosition &position)
{
	return operator<<(os, position);
}

class MotorControl
{
public:
   enum class Config {
      ALL_MOTORS = 0,
      ALL_LEGS,
      RIGHT_LEG,
      LEFT_LEG,
      HEAD,
      NUM_TEST
   };

   enum class Button {
      BUTTON_1 = 0, // S2
      BUTTON_2,     // S3
      BUTTON_3      // S4
   };

   enum class Object {
      BALL = 0,
      GOAL
   };
   
   MotorControl(std::shared_ptr<ThreadManager> threadManager_ptr, const XmlParser &config, boost::asio::io_service &boost_io);
   ~MotorControl();

   void WriteAll();
   bool InitPositions( const std::vector<double>& vPos,
                       const Config config,
                       const double msTotalTime = 10000.0,
                       const double msDt = 16);
  
   void UpdateMotorStatus(const std::vector<char>& msg);
   void GetMotorStatus(std::vector<Protocol::MotorStruct> &status, const Config config);
   bool GetButtonStatus(const Button button_enum);
   bool isPaused();

   bool SetTorque(bool value, const Config config);

   bool SetPosition(double pos, std::string name); 
   bool SetPositions(const std::vector<double>& pos, const Config config);
   
   const double ReadPosition(std::string name);
   bool ReadPositions(std::vector<double>& pos, const Config config);

   void SendRawPacket(const std::uint8_t& cmd, const std::vector<char>& data, std::string name);
   void SendRawPackets(const std::vector<std::uint8_t>& cmds, const std::vector<std::vector<char>>& data, const Config config);
   std::vector<char> GetRawPacket();

   // TODO To be removed
   void HardSet(const std::vector<double>& pos, const Config config);
   void HardGet(std::vector<double>& pos, const Config config);
   void HardGetMaxAngles(std::vector<double>& angles, const Config config);
   void HardGetMinAngles(std::vector<double>& angles, const Config config);

   std::string GetColorToTrack();
   void SetObjectPosition(ObjectPosition object); 
   ObjectPosition GetObjectPosition();
   void SetObjectToTrack(Object object);

   bool isInterrupeted();
   void resetInterrupeted() { _isInterrupeted = false;};
   void isWalking(bool value);
private:
   void InitializeMotors(const XmlParser &config);
   void InitializeConfigurations(const XmlParser &config);
   void InitPID(const XmlParser &config);

   std::vector<bool> _buttonStatus;
   std::shared_ptr<STM32F4> _stm32f4;
   std::shared_ptr<ThreadManager> _threadManager;
   
   boost::mutex _io_mutex;
   boost::circular_buffer<std::vector<char>> _rawPackets;

   std::map<std::string, std::shared_ptr<Motor>> _mapStrMotors;
   std::map<int, std::shared_ptr<Motor>> _mapIdMotors;
   std::map<Config, std::vector<std::shared_ptr<Motor>>> _configurations;

   double _robotHeight;
   bool   _isPaused;
   ObjectPosition _objectDistance;
   
   std::vector<std::string> _trackingObjects; 
   std::string _currentColor;
   bool _isInterrupeted;
   bool _isWalking;
};
#endif  //MOTOR_CONTROL_H
