wael-suleiman-UdeS/RobotFoot/cartectrl/cartectrl/src/bsp/Button.cpp

/**
  ******************************************************************************
  * @file    Button.cpp
  * @author  James-Adam Renquinha Henri (Jarhmander)
  * @version 1.0
  * @date    2013-10-22
  * @brief   Code to read I/Os as buttons (rather low level, should not be used
  *          by user-level code)
  ******************************************************************************
  */

//------------------------------------------------------------------------------
#include "bsp/Button.hpp"
//------------------------------------------------------------------------------


/// File is empty on purpose.


//------------------------------------------------------------------------------
