wael-suleiman-UdeS/RobotFoot/cartectrl/cartectrl/src/LEDs.cpp

/**
  ******************************************************************************
  * @file    LEDs.cpp
  * @author  James-Adam Renquinha Henri (Jarhmander)
  * @version 1.0
  * @date    2013-10-22
  * @brief   Contains definitions to LED objects.
  ******************************************************************************
  */

//------------------------------------------------------------------------------
#include <LEDs.hpp>
//------------------------------------------------------------------------------


namespace bsp
{

#if STM32F4DISCOVERY_TEST
LED<gpio::d, 12> LED1 {};
LED<gpio::d, 13> LED2 {};
LED<gpio::d, 14> LED3 {};
LED<gpio::d, 15> LED4 {};
#else
LED<gpio::e, 14> LED1 {};
LED<gpio::e, 15> LED2 {};
#endif


}

//------------------------------------------------------------------------------
