wael-suleiman-UdeS/RobotFoot/cartectrl/cartectrl/include/initClock.h

/**
  ******************************************************************************
  * @file    initClock.h
  * @author  James-Adam Renquinha Henri (Jarhmander)
  * @version V1.0.0
  * @date    2013-03-21
  * @brief   Clock initialisation routine
  ******************************************************************************
  */

//------------------------------------------------------------------------------
#ifndef INITCLOCK_H
#define INITCLOCK_H
//------------------------------------------------------------------------------

#ifdef __cplusplus
 extern "C" {
#endif

/** @addtogroup Init
  * @{
  */

/** @addtogroup Clock
  * @{
  */

void initClock(void);

#ifdef __cplusplus
 }
#endif

/**
  * @}
  */

/**
  * @}
  */
//------------------------------------------------------------------------------
#endif // INITCLOCK_H
