wael-suleiman-UdeS/RobotFoot/Embedded_Computer/src/Utilities/ThreadManager.h

/////////////////////////////////////////////////////////////////////
//
// Class ThreadManager
// Author : Mickael Paradis
// Date : October 11
// Description : Class managing threads and their priorities.
//
/////////////////////////////////////////////////////////////////////
#ifndef THREADMANAGER_H
#define THREADMANAGER_H
#include <boost/thread.hpp>
#include <boost/function.hpp>
#include <boost/asio.hpp>
#include <boost/date_time/posix_time/posix_time.hpp>
#include <map>
#include <string>
#include <memory>

#include "Utilities/XmlParser.h"

class ThreadManager
{
    public:
        ThreadManager();
        ~ThreadManager();

        enum Task
        {
            UNKNOW = 0,
            LEGS_CONTROL,
            HEAD_CONTROL,
            MOTOR_CONTROL,
            IO_CONTROL
        };

        boost::thread::id create(unsigned int priority, const boost::function0<void>& thread_func, Task task = Task::UNKNOW);
        
        void stop(boost::thread::id thread_id);
        void stop(Task task);

        void attach(boost::thread::id thread_id);
        void attach(Task task);

        bool resume(boost::thread::id thread_id);
        bool resume(Task task);

        void wait();
        void end();
        
        int calculate_the_answer_to_life_the_universe_and_everything();     
    private:
        std::map<boost::thread::id, std::shared_ptr<boost::thread>> _threads;
        std::map<boost::thread::id, std::pair<bool, std::shared_ptr<boost::condition_variable>>> _cond_variables;
        std::map<Task, boost::thread::id> _tasks; 
};
#endif
