wael-suleiman-UdeS/RobotFoot/cartectrl/cartectrl/unit_test/UnitTestHerkulex.h

#ifndef UNIT_TEST_HERKULEX_H
#define UNIT_TEST_HERKULEX_H

#include "UnitTest.h"

class UnitTestHerkulex : public UnitTest
{
public:
    UnitTestHerkulex();
    virtual ~UnitTestHerkulex();

    virtual bool Test();

};


#endif // UNIT_TEST_HERKULEX_H
