wael-suleiman-UdeS/RobotFoot/(commit log)

2013-02-07 Test
    Un commit de test sur RoboFoot.
2013-02-07 3D models
    [(#112458) KSB1023A_T2X25NI.sldprt, (#129725) KSB1023A_M2_5X8Z.sldprt, (#31287) TOP_191.sldprt, AssemblageJambe.SLDASM, Bracket.SLDPRT, BracketFemur.SLDPRT, BracketFoot.SLDPRT, BracketHanche.SLDPRT]
2013-02-27 Projet : Détection et suivi de la balle
    Premier essai de détection et suivi d'un objet de couleur spécifique
    (préférablement un objet sphérique) avec valeurs paramètrables.
2013-02-27 Premier commit du code de MCU
    Attention, ne pas toucher au fichier projet sans configuration préalable de Code::Blocks!
    Le code ne fait que toggler les LEDs sur le board.
    [config.cfg]
2013-03-06 Update du altium + ajout test uart pour la carte de contrôle
    Ajout du test en pyton des servo moteur
    [V33.SchDoc, V5.SchDoc, audio.SchDoc, cartectrl.PrjPcb, mcu.SchDoc]
2013-03-06 Ajout de la dilatation
2013-03-07 Correction du .gitignore; retrait du fichier .depend pour effectivement empêcher Git de tracker le fichier
2013-03-07 .gitignore les fichiers log...
2013-03-07 Section Imprimante 3D
    Nouvelle section avec le config.h
    [Configuration.h]
2013-03-07 fichier test.c supprimé (travail de Mathieu)
2013-03-07 Commit initial de test USB. Ça ne marchera certainement pas tout de suite...
2013-03-08 Fix: retrait de la dépendance à stm32f4_discovery.h
2013-03-08 Le projet compile; mais est-ce que ça marche? J'en doute fort, il faut une config préalable du clock!
2013-03-08 Fix: retrait de la dépendance à stm32f4_discovery.h
    Notez que le fichier modifié se retrouve dans extlib. Étrangement le fichier
    dépend de stm32f4_discovery.h, alors que le code n'est pas spécifique au board
    de développement. C'est donc juste un #include qui est effacé.
2013-03-08 test de commit
2013-03-08 Code de la calibration de la camera ajouté
    Permet de trouver les matrices de distorsion et des coefficient de la
    caméra. Cela va être nécessaire pour avoir des coordonnées précises.
2013-03-10 Le tout compile et les interrupts de USB se font trigger. Mais ça ne marche pas encore... Ça va venir, ça va venir...
2013-03-10 Doxyfile pour la doc de stm32f4 firware package.
2013-03-11 Ajout de prototype de fonction de base pour la compilation en c++!
2013-03-12 Altium update
    [V33.SchDoc, V5.SchDoc, audio.SchDoc]
2013-03-13 .gitignore encore à jour pour ne pas tracker les fichiers *.map
2013-03-14 ÇA MARCHE OSTI!!! CRISS DE BUFFER OVERFLOW!!! Code du usb downloadé déficient!!!
    Augmenter le buffer pour les chaînes fait en sorte qu'il n'y a plus de buffer overflow.
2013-03-14 Linker script et startup
    Le linker script est plus beau. Le code de startup tient en compte les sections "fastcode".
    Les fonctions memcpy et memset sont utilisées pour l'initialisation ce qui sauve un peu
    de mémoire et rend le code plus lisible.
2013-03-14 String de produit changé.
2013-03-14 Ce commit risque fort probablement de se perdre dans la brume. Formatage du code...
2013-03-14 Vérifier les settings de projet, il faut peut-être prendre certains paramètres.
2013-03-14 POUR DAVE altium commit
    [audio.SchDoc]
2013-03-14 fichier syscall.c de master.
2013-03-14 Ajout de extern "C". Retrait du code de vcp.
2013-03-14 Mise à jour du main et du projet...
    Le délai pour la flash était à changer (voltage trop bas) et les commentaires sont un peu mieux.
2013-03-14 Retrait d'une fonction devant être appelée sur appui de la touche User...
2013-03-18 Interface des moteurs
    Communication tx et rx complété.
2013-03-21 Simple correction des en-têtes de fichiers.
2013-03-21 Fonction initClock dans son propre module.
    La fonction initClock initialise les clocks du MCU, donne une latence à la
    flash, active les caches de données/instructions et le prefetch buffer pour
    améliorer les performances de l'exécution du code.
2013-03-25 _sbrk modifié pour que malloc/free fonctionnent.
2013-03-27 Ad: snapshot...
    Un commit sans regarder ce qui a été changé. Vérifiez l'état du
    repository pour mieux documenter les changements futurs.
2013-03-27 Commit Altium 2
    [V33.SchDoc, V5.SchDoc, Vbatt.SchDoc, audio.SchDoc, cartectrl.PrjPcb, mcu-adv.SchDoc]
2013-03-27 Added some UnitTest for Herculex motor
    Not still functionnal
2013-03-27 Ad: Mis à jour composante stm32f4, pcb vide, feuille main
    [cartectrl.PcbDoc, cartectrl.PrjPcb, main.SchDoc, mcu.SchDoc]
2013-03-29 Ad: Mise à jour massive.
    MCU presque complété (il manque les DELs). Il faut cependant déterminer
    les pins finales pour les fonctions SPI/UART, pour le moment des pins
    acceptables ont été choisies sans tenir en compte le layout final du
    board.
    La composante schématique du connecteur USB est à jour, il y avait une
    erreur dessus.
    Le LSM330 est placé et le mcu est plogué dessus.
    Les schématiques sont plus sous forme hiérarchique, avec un main comme
    top.
    [V33.SchDoc, V5.SchDoc, Vbatt.SchDoc, audio.SchDoc, buttons.SchDoc, cartectrl.PrjPcb, lsm330.SchDoc, main.SchDoc]
2013-03-30 Basic UnitTest for Hekulex motor is functionnal
2013-03-30 Set ID's of all motors
2013-04-01 Dâve: schématique complet, manque valeurs.
    Il faut juste mettre les valeurs de composantes, prendre les bons
    footprints selon les pièces commandées.
    [LEDs.SchDoc, UART_DBG.SchDoc, V33.SchDoc, V5.SchDoc, Vbatt.SchDoc, audio.SchDoc, buttons.SchDoc, cartectrl.PrjPcb]
2013-04-01 Test with controlling many motors
    Only with the stm32f4, controlling many motors generate an error
    (Garbage detected). The reason why is not known yet but it is maybe
    because Uart voltage of stm32f4 is not high enough. Error seem to occur
    when motor is moving.
    Exept this, it is working as intended.
    [Tools.cpp, Tools.h, UnitTest.h, UnitTestHerkulex.cpp, UnitTestOutput.cpp, herkulex.cpp, herkulex.h]
2013-04-02 image processing: small fixes
    [ColorFinder.cpp, ColorFinder.h, ImageProcessing.cpp, ImageProcessing.h, main.cpp]
2013-04-02 Français to Reliche
    [AssemblageJambe.SLDASM, Bracket.SLDPRT, BracketFemur.SLDPRT, BracketFoot.SLDPRT, BracketHanche.SLDPRT, Chest_Lower.SLDPRT, Chest_Middle.SLDPRT, Chest_Upper.SLDPRT]
2013-04-02 IP : error handling
    [Camera.cpp, Camera.h, ColorFinder.cpp]
2013-04-02 Now it doesn't track uneeded files...
    [config.cfg]
2013-04-02 Ad: Correction de certaines schématiques.
    [Vbatt.SchDoc, mcu.SchDoc]
2013-04-03 .filters - .users
2013-04-03 bug fix: on top of master.
    Conflicts:
    Embedded Computer/TraitementImage/Experimentation/MyNewOpenCVProject/MyNewOpenCVProject.sdf
    Embedded Computer/TraitementImage/Experimentation/MyNewOpenCVProject/MyNewOpenCVProject.v11.suo
    Embedded Computer/TraitementImage/Experimentation/MyNewOpenCVProject/MyNewOpenCVProject/CameraCapture.cpp
    [Camera.cpp, Camera.h]
2013-04-03 exemple de makefile
    pour compiler du code avec la librairie OpenCV
2013-04-03 Dave: Footprints de tous les condensateurs et résistances.
    Footprints complet pour condensateurs et résistances, il faut terminer
    celui du potentiomètre. Changement des valeurs des résistances et
    condensateurs.
    [LEDs.SchDoc, UART_DBG.SchDoc, V33.SchDoc, V5.SchDoc, Vbatt.SchDoc, audio.SchDoc, buttons.SchDoc, cartectrl.PrjPcb]
2013-04-03 Adding Darwin Framework for test with Darwin Robot
2013-04-03 Finalisation du schématique (footprints)
    [LEDs.SchDoc, UART_DBG.SchDoc, V33.SchDoc, V5.SchDoc, Vbatt.SchDoc, audio.SchDoc, buttons.SchDoc, cartectrl.PrjPcb]
2013-04-05 When _sbrk fails, return a NULL pointer instead.
    [syscall.c]
2013-04-05 Dave: Debut pcb
    [PCB.PcbDoc, V5.SchDoc, Vbatt.SchDoc, audio.SchDoc, cartectrl.PcbDoc, cartectrl.PrjPcb, mcu.SchDoc, motors.SchDoc]
2013-04-05 Revert "Dave: Debut pcb"
    This reverts commit acd5a1958ba27004228ac96cc02f11faa7abc5f5. (Buggy commit)
    [PCB.PcbDoc, V5.SchDoc, Vbatt.SchDoc, audio.SchDoc, cartectrl.PcbDoc, cartectrl.PrjPcb, mcu.SchDoc, motors.SchDoc]
2013-04-05 Fix Doxygen group in initClock.h/initClock.c
    [initClock.c, initClock.h]
2013-04-05 Fix @retval -> @return
    [initClock.c]
2013-04-07 Dave: Schematic et librarie corrigées. Pret à concevoir pcb
    [V5.SchDoc, Vbatt.SchDoc, cartectrl.PrjPcb]
2013-04-07 Dave: Première passe de placement de pièces
    [PCB.PcbDoc, cartectrl.PcbDoc, cartectrl.PrjPcb]
2013-04-08 Modif pcb lib & schem
    -Added soic packages to LM386
    [audio.SchDoc]
2013-04-08 3D models and basic placement
    - 3D model for cap and coil. Just a mechanical constraint so the
    component clearance DRC stop complaining.
    - 5V power supply placement in its room
    -All components are in their rooms.
    [PCB.PcbDoc]
2013-04-08 Basic placement of MCU.
    [PCB.PcbDoc]
2013-04-08 More placement in rooms + correction of jack audio.
    [PCB.PcbDoc, audio.SchDoc]
2013-04-10 Added the relative error for the tracking (ObjectTracker)
    [ObjectTracker.cpp, ObjectTracker.h]
2013-04-10 Correct pot and correction of major placement of rooms. (Face is at the left edge)
    TODO: check hole!!!
    [PCB.PcbDoc, audio.SchDoc]
2013-04-10 Vbatt fitted on board.
    [PCB.PcbDoc, Vbatt.SchDoc]
2013-04-10 3.3V and power fitted.
    [PCB.PcbDoc, V5.SchDoc, audio.SchDoc]
2013-04-11 Completed tracker, no motors
2013-04-11 Tracking demo sample
2013-04-11 Rooms deleted.
    [PCB.PcbDoc, Vbatt.SchDoc]
2013-04-11 Small fixes, XmlParser started
    [Camera.cpp, RobotFoot.cpp]
2013-04-11 Almost done placing the part!
    [PCB.PcbDoc, V33.SchDoc, V5.SchDoc, Vbatt.SchDoc, audio.SchDoc, mcu.SchDoc]
2013-04-11 V3.3 flipped.
    [PCB.PcbDoc]
2013-04-13 Fix initClock.c so it includes its header.
    [initClock.c]
2013-04-16 Pièces placées, changement fait pour spi et uart
    [PCB.CSV, PCB.PcbDoc, audio.SchDoc, cartectrl.PrjPcb, mcu.SchDoc]
2013-04-17 Added STM32F4 compilation (hack)
    I hate hacks...
2013-04-17 Begin routing...
    Begin of routing. Also, relaxed the trace clearance rule and all violations vanished! Wut!
    [PCB.PcbDoc]
2013-04-17 OpenCV libs compiled with ARM
2013-04-17 nouveau .gitignore pour accepter les .so
2013-04-17 linux fix; STM32F4 hack
    \ = /
    [Camera.h, ColorFinder.h, ImageProcessing.h, ObjectTracker.cpp]
2013-04-17 Some more routing and Vsense added!
    [PCB.PcbDoc, mcu.SchDoc]
2013-04-18 Don't track those huge sdf files!!!
2013-04-18 torque fix
2013-04-19 camera center fix
2013-04-20 PID controller
2013-04-20 Everything seems to be routed! (Except GND)
    [LEDs.SchDoc, PCB.PcbDoc, mcu.SchDoc]
2013-04-20 GND routed
    [PCB.PcbDoc, cartectrl.PrjPcb]
2013-04-21 PID reset
2013-04-21 PCB complete! (at first glance...)
    [PCB.PcbDoc, V33.SchDoc, V5.SchDoc, Vbatt.SchDoc, audio.SchDoc, mcu.SchDoc]
2013-04-22 Minor edits, seems complete!
    *Vias to ground now doesn't have thermal relief and polygon pours have greater clearance.
    [PCB.PcbDoc]
2013-04-22 PCB output (gerbers)
    [cartectrl.PrjPcb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]
2013-04-23 Header footprints are invalid, need fix very quickly!!!!
    [PCB.PcbDoc]
2013-04-23 Header footprints fixed!!!
    Need some messing around with polygons...
    [PCB.CSV, PCB.PcbDoc, V33.SchDoc, cartectrl.PrjPcb, robotfoot.PcbLib]
2013-04-24 Should be OK now!
    [cartectrl.PrjPcb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]
2013-04-25 Added footprint for connector "292132-4" (motor connector)
2013-04-25 Replacement done. Attempt to add a S/N on it...
    [LEDs.SchDoc, PCB.PcbDoc, UART_DBG.SchDoc, V33.SchDoc, V5.SchDoc, Vbatt.SchDoc, audio.SchDoc, buttons.SchDoc]
2013-04-25 About to generate output files...
    [PCB.PcbDoc]
2013-04-25 File generated, plus S/N on board.
    [PCB.GBL, PCB.GBS, PCB.GTL, PCB.GTO, PCB.GTS]
2013-04-25 Output jobs: print.
    [cartectrl.PrjPcb]
2013-07-03 Typo fixed in comment.
    It may seem insignificant, but the comment is important to know some
    parameters set in the MCU.
    [initClock.c]
2013-08-27 Update Serial IO for motor in new PCB.
2013-09-04 Changes on eclipse project. Fixed small bug on usb write on MCU. Added Demo Folder for Embedded computer and finished the Simple Motor Control demo
    [main.cpp, test1.cpp]
2013-09-04 Added the emergency stop button. There is a conflict with .cproject and .project
2013-09-05 Added Eigen library and motor calcul for static walking demo.
2013-09-11 Update Demo progress, Usb problem detected that should be fix, be the rest pretty much done.
    [MotorControl.cpp, MotorControl.h, WalkStatus.cpp, main.cpp]
2013-09-16 Fix Set Torque
2013-09-17 Automatic calibration for servo
2013-09-23 Refactor motor calibration
2013-09-23 Fix compilation error in Xml Parser Added Boost library for ubuntu x86
    [XmlParser.h]
2013-09-25 New boost 1.54.0 for arm with the timer lib
2013-09-26 USB problem fixed: now proper flow control is made with received chars.
    NOTE: Please test cartectrl thoroughly and verify that the USB indeed work as intended!
2013-09-26 Quick fix of command set torque in cartectrl.
2013-10-01 Change Communication protocol from CPU to MCU. Fixed usb communication for motors.
    [MotorControl.cpp, MotorControl.h, SerialInterface.cpp, main.cpp]
2013-10-02 Usb motor reviewed by Adam
2013-10-03 Boost_chrono added to arm build and integration of timing in main loop
2013-10-08 Fix bug on old tracking demo.
    [ObjectTracker.cpp]
2013-10-11 Fixed typo in miscutils.h
    [miscutils.h]
2013-10-16 New ThreadManager class in Utilities
2013-10-16 ThreadManager Class done
2013-10-18 Thread name support in ThreadManager
2013-10-18 - Motors configurations in config.xml - New include path in makefile for easier #include interpretation - Refactoring of MotorControl class (in MotorControl_2 for the moment) - New method in XmlParse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
2013-10-19 Fixed build errors in XmlParser
    [XmlParser.cpp, XmlParser.h]
2013-10-21 Added Read and Clear Status in protocol for motor.
2013-10-21 Threaderize the testTracker function in the main
2013-10-22 Refactoring of MotorControl, ThreadManager and logger.h
2013-10-22 Fixed some problems in HeadControlTask
    [HeadControlTask.cpp, HeadControlTask.h, RobotFoot.cpp]
2013-10-22 Refactor the ObjectTracker Added speed in motor protocol
2013-10-22 Update PID config for object tracker
2013-10-22 Small fix for StaticWalk.cpp
    [StaticWalk.cpp]
2013-10-22 Files for LED control, new class GPIO_Pin
    LED class uses GPIO_Pin internally. GPIO_Pin will make configuring pin easy.
    Note that the 'std=gnu++0x' was added, some header files are added to the
    project and some dangling references to header files in src/ were removed
    from the project.
2013-10-22 Added ThreadManager in staticWalk
2013-10-22 Code use LED1 and LED2 objects
    Removed unnecessary handling of GPIOE.
2013-10-22 Adaption de ObjetTracker avec MotorControl
2013-10-22 FIX commit 88c567cb Code use LED1 and LED2 objects
    Typo fix in #include (prevent compiling otherwise).
    [main.cpp]
2013-10-22 Integrated ObjectTracker with MotorControl Created the HeadControlTask
2013-10-22 Swapping of LED number assignation
    LED objects correctly effect their corresponding LED. The initial error was
    pretty harmless, though.
    [LEDs.cpp, LEDs.hpp]
2013-10-23 Hack HardGet in MotorControl
2013-10-23 New files Button.{cpp,hpp}
2013-10-23 FIX: Button::state now return the right state!
    On the other file, only a line comment is added (just a visual thing).
2013-10-23 New files Input.{hpp,cpp}.
    They introduce Input and InputMan objects. They deal with buttons and allow
    installation of handlers on events from buttons. Also removed code from
    src/interrupts/stm32fxxx_it.c. Removed now obsolete function init_GPIO, and
    commented-out EmergencyStop inclusion and use in main.cpp.
    TODO: Doxygen comments...
2013-10-23 Repurpose EmergencyStop
    Now that inputMan handles all inputs and can call handlers on events,
    EmergencyStop now provide a static method to install itself as an handler on
    button::b3 pressed. Now, function initialize in main.cpp does exactly call
    this static method.
    TODO: Doxygen comments, with the respective authors.
2013-10-23 HeadControl threadize in the main
2013-10-24 Testing of camera
2013-10-24 Fix Gui display of camera
    [HeadControlTask.cpp, RobotFoot.cpp]
2013-10-30 Fix limit in config for motor 3 and 4. Added error message when clamping invalid motor position.
    [MotorControl_2.cpp]
2013-11-01 Functional trajectory generation, motion control contains a bug in the angle correction
    [DenavitHartenberg.cpp, DenavitHartenberg.h, MotionControl.cpp, MotionControl.h, Trajectory.cpp, Trajectory.h, test1.cpp]
2013-11-04 Fix little display error bug.
    [MotorControl_2.cpp]
2013-11-05 Invert Q for printing
    [MotionControl.cpp]
2013-11-05 Switch q in degrees
2013-11-06 Fix a bug with the ZMP trajectory generation
    [MotionControl.cpp, Trajectory.cpp, Trajectory.h, test1.cpp]
2013-11-07 Update Motor read
2013-11-07 Added config to invert motor position.
    [MotorControl_2.cpp, MotorControl_2.h, XmlParser.cpp, XmlParser.h]
2013-11-07 Updated Matlab so motor are not inverted.
2013-11-13 Fixed a bug in the steps generation and bezier curve creation
    [Trajectory.cpp, Trajectory.h, test1.cpp]
2013-11-13 Inverted x and y in the trajectory as the forward reference axis of the robot is y instead of x
    [Trajectory.cpp, test1.cpp]
2013-11-13 Fixed a bug where initial and final trajectory values were not correct
    [Trajectory.cpp]
2013-11-14 Sound subsystem added.
    Please be sure to look at the doxygen documentation to understand how to use
    it. It's not that it is hard, it's rather that if you skip an small but
    important detail, your 'sound object' won't do any sound.
    [sound.cpp]
2013-11-14 Fixed multiple bugs in the walk
    [DenavitHartenberg.cpp, Trajectory.cpp, test1.cpp]
2013-11-14 Fixed the forward reference axis for the trajectory
    [Trajectory.cpp, test1.cpp]
2013-11-14 VSense feature implemented.
    It is possible to read main supply voltage. Also, an audible alarm is fired if
    the main supply goes out of the desired voltage range.
2013-11-17 Fixed DH so Motor angle are coherent between Fixed right of left legs. Added generation or fixed foot in generate trajectory to be more felxible
2013-11-19 Fixed the ZMP so that it pauses when a leg is moving
    [EigenUtils.cpp, Trajectory.cpp, test1.cpp]
2013-11-20 Temporary changes to be able to read and write in ram of motor.
2013-11-20 Integrated new leg motion in RobotFoot main
2013-11-20 Integrated leg motion in Robotfoot main
2013-11-20 Fixed angle radian to degree
    [MotionControl.cpp, SerialInterface.cpp, SerialInterface.h]
2013-11-20 Fix an order of Q issue
    [MotionControl.cpp]
2013-11-21 Integrated leg motion control in robotfoot main (functional version)
2013-11-30 Change the sign of the offset angle depending on the fixed foot
    [MotionControl.cpp, test1.cpp]
2013-12-02 Fixed a bug with feet angle offsets
    [Trajectory.cpp]
2013-12-02 Button support
2013-12-02 Fix a crash when using the COM instead of the ZMP
    [Trajectory.cpp, test1.cpp]
2013-12-02 Fix a crash in ZMPGeneration
    [Trajectory.cpp, test1.cpp]
2013-12-02 New protocol
    This is a rebased tree. Too much changes and I didn't care splitting properly the commits.
    [FIFOalloc.cpp, FIFOalloc.hpp, HerkulexMan.hpp, Input.cpp, TimedTasks.cpp, UARTinterface.cpp, UARTinterface.hpp]
2013-12-03 ThreadManager new task (IO_SERVICE)
2013-12-03 New main with walk and kick motion and button press start
2013-12-04 Fixed the fucking checksum calculation
    [Protocol.cpp]
2013-12-04 Reset button support
2013-12-04 Fixed pause button
2013-12-04 Added Termination when position error is to high.
    [HeadControlTask.cpp, LegMotion.cpp, MotionControl.cpp, MotionControl.h, MotorControl_2.cpp, RobotFoot.cpp, XmlParser.cpp, XmlParser.h]
2013-12-04 Choose object to track
2013-12-04 Update Color change with button
2013-12-04 Switch ball color button
2013-12-10 Now reads are not screwed up...
    Oops, used a union for dataIn and dataOut! It couldn't be worse.
    Some other fixes, and new utils.
    Heheh, didn't care to split this commit into isolated set of changes... sry!
    [TimedTasks.cpp, USBProtocol.cpp, herkulex.cpp, herkulex.h, main.cpp, readcarte.lua]
2013-12-10 Yes!!! Now there is no stalled pending USB interrupts.
2013-12-11 Error message when not running in sudo.
    [ThreadManager.cpp]
2013-12-11 Scripts that allow easy poking of values into Herkulex servos.
2013-12-12 Fixed the motor id number 5, integrated curve trajectory correctly
    [MotionControl.cpp, MotionControl.h, Trajectory.cpp]
2013-12-12 To do pour la prochaine equipe
2013-12-12 Added stuff from DropBox
    [(#112458) KSB1023A_T2X25NI.sldprt, (#129725) KSB1023A_M2_5X8Z.sldprt, (#31287) TOP_191.sldprt, 10_FR07_H102.igs, 10_FR07_H102.prt, 10_FR07_H102.sldprt, 10_FR07_H102.step, 11_FR07_SC101.igs]
2013-12-12 Changed motor ID 253 -> 5.
2013-12-12 Fixed those little bugs in the PCB!
    [PCB.PcbDoc, buttons.SchDoc, cartectrl.PrjPcb, mcu.SchDoc, motors.SchDoc]
